mlab-upenn/gokart-mechatronics/Mechanical/SBW - lower/Why loose/loose 2.jpg

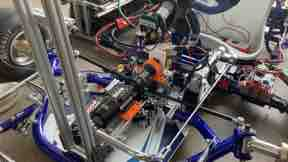
Mechanical/SBW - lower/Why loose/loose 2.jpg
