mlab-upenn/gokart-mechatronics/Mechanical/SBW - lower/Why loose/loose 1.jpg

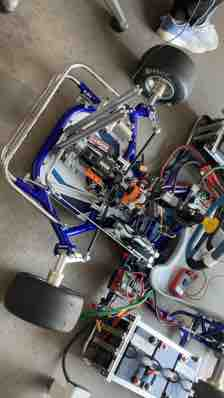
Mechanical/SBW - lower/Why loose/loose 1.jpg
