mlab-upenn/gokart-mechatronics/README.md

# Go-kart Mechatronics
Mechatronics design for AV4EV go-kart project.

**main branch** stores the current design, **dev branch** logs the previous developments and trials.
