mlab-upenn/gokart-mechatronics/Mechanical/BBW Spreadsheet.docx

BBW V4 Spreadsheet

Name | Photos | Functions | Solidworks Model | Quantity | Need of Manufacturing | Material

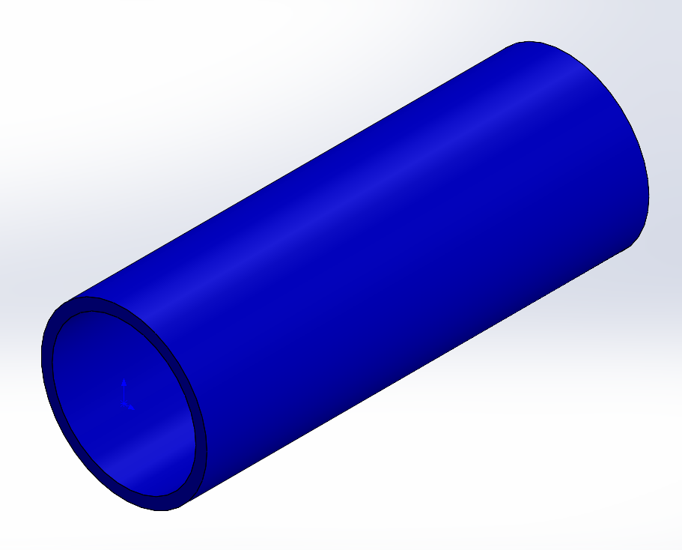
[picture p35: figure]

Side Chassis Frame | | original go-kart side chassis frame | link (https://github.com/mlab-upenn/gokart-mechatronics/tree/main/BBW%20V4) | 1 | No | Steel

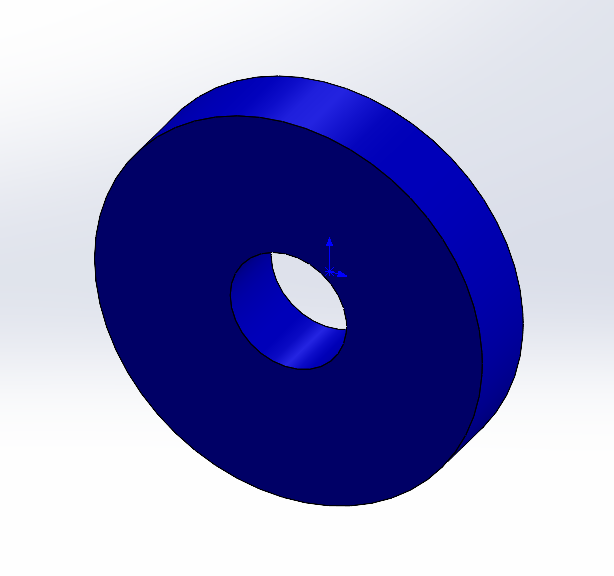
[picture p36: figure]

Chassis Mount | | original mounting hole for aluminum chassis | link (https://github.com/mlab-upenn/gokart-mechatronics/tree/main/BBW%20V4) | 1 | No | Steel

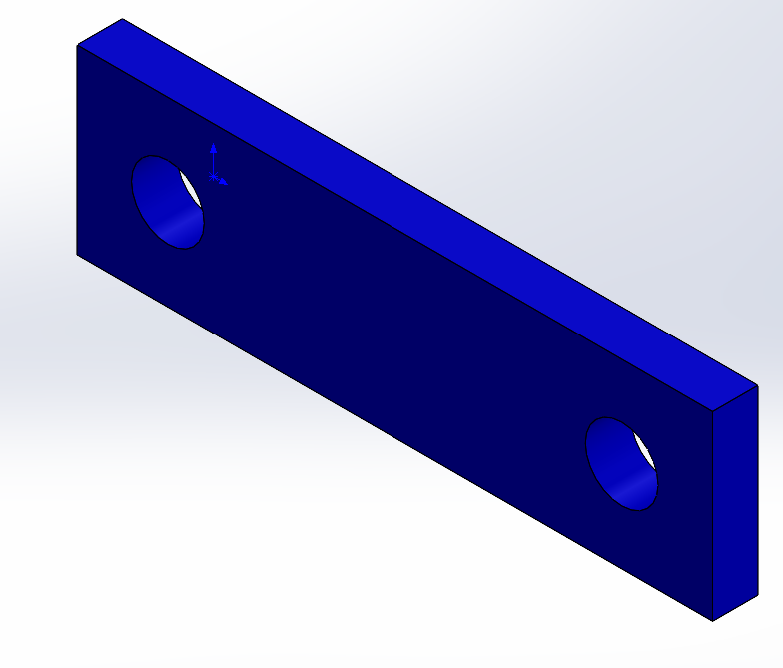
[picture p37: figure]

Black Box Frame | | original mount for the hydraulic brake part | link (https://github.com/mlab-upenn/gokart-mechatronics/tree/main/BBW%20V4) | 1 | No | Steel

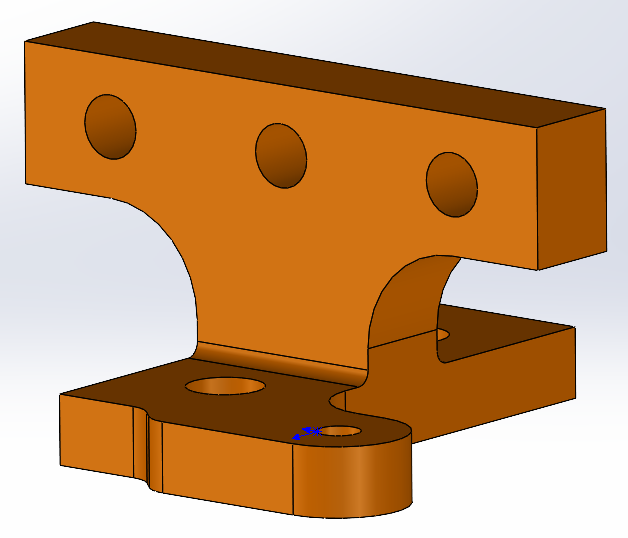
[picture p38: figure]

Small Plate | | connect the LA mount and chassis frame together | link (https://github.com/mlab-upenn/gokart-mechatronics/tree/main/BBW%20V4) | 1 | Yes | Plastic

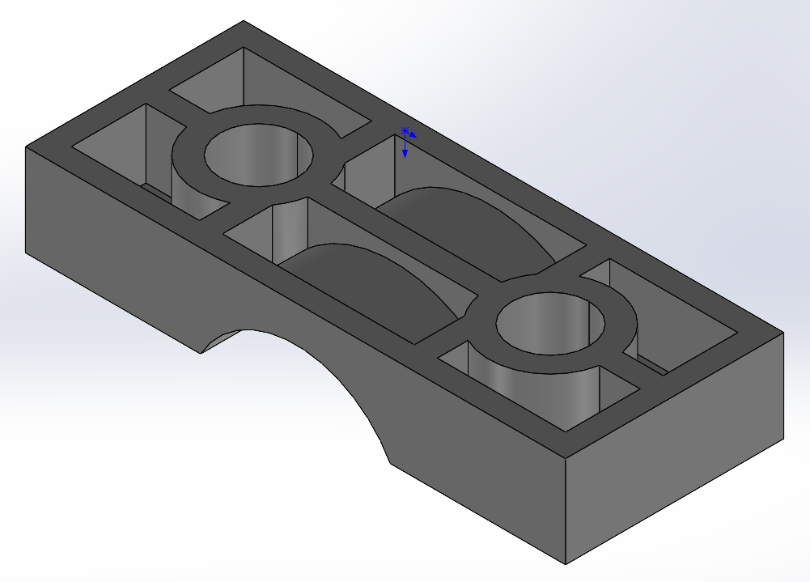
[picture p39: figure]

Original Clamp | | U-bolt clamp for holding the chassis frame | link (https://github.com/mlab-upenn/gokart-mechatronics/tree/main/BBW%20V4) | 1 | Purchase (https://www.mcmaster.com/u-bolts/system-of-measurement~metric/id~30mm/) | Plastic

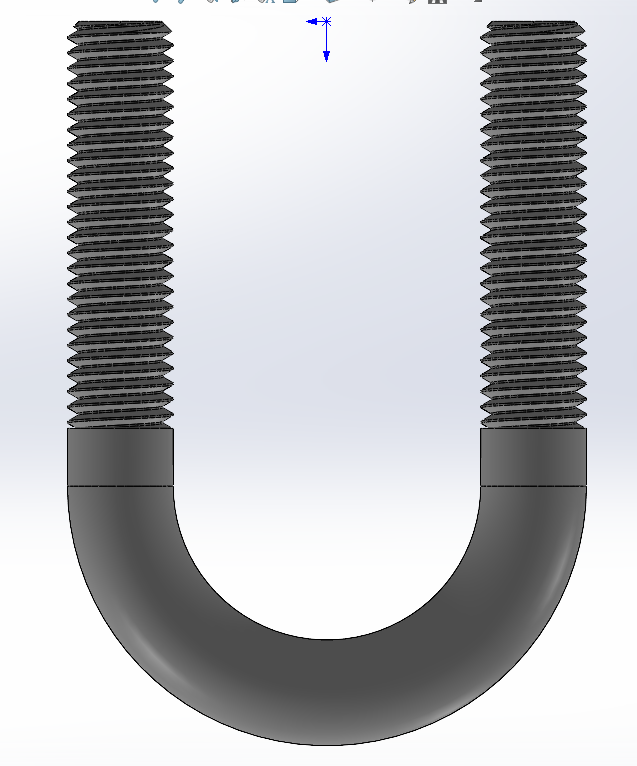
[picture p40: figure]

Thick U bolt | | clamp the whole design to the chassis frame | link (https://github.com/mlab-upenn/gokart-mechatronics/tree/main/BBW%20V4) | 1 | Purchase (https://www.mcmaster.com/u-bolts/system-of-measurement~metric/id~30mm/) | metal

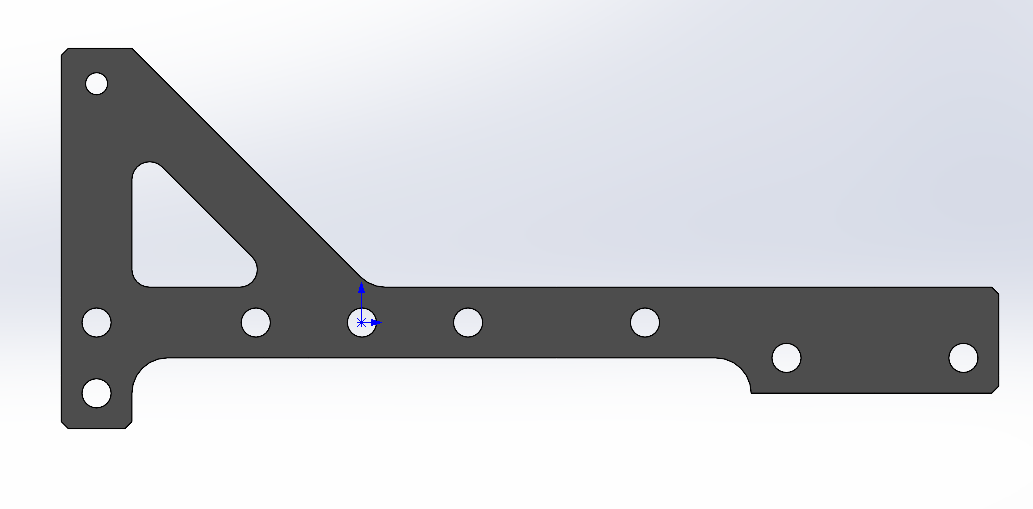
[picture p41: figure]

Steel Frame New | | mount the LA to the black box frame | link (https://github.com/mlab-upenn/gokart-mechatronics/tree/main/BBW%20V4) | 2 | custom | aluminum plate 6061

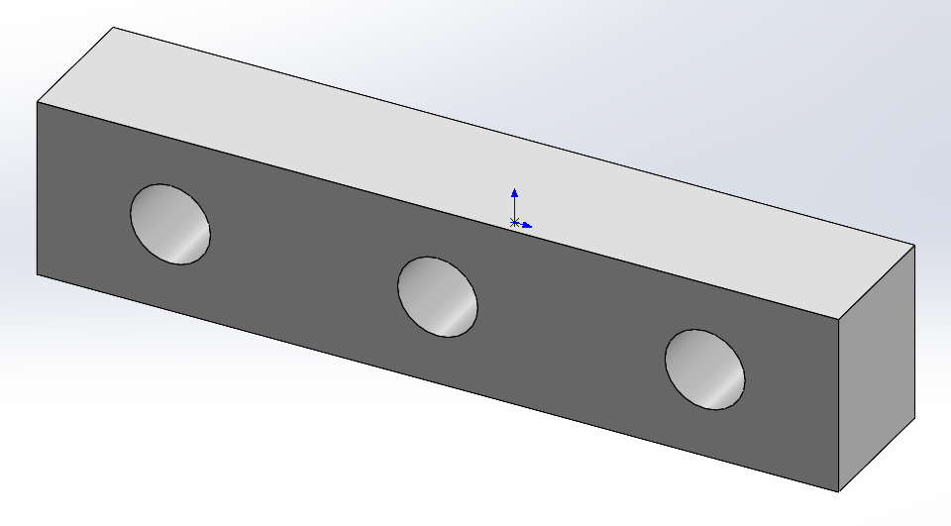
[picture p42: figure]

Mid Link | | position limit | link (https://github.com/mlab-upenn/gokart-mechatronics/tree/main/BBW%20V4) | 2 | Yes | plastic

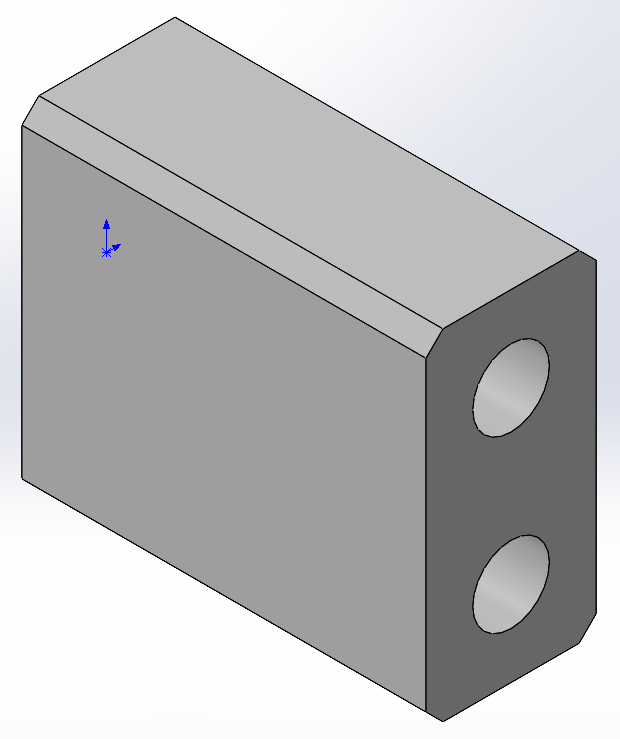
[picture p43: figure]

Back Link | | rear position limit | link (https://github.com/mlab-upenn/gokart-mechatronics/tree/main/BBW%20V4) | 1 | Yes | plastic

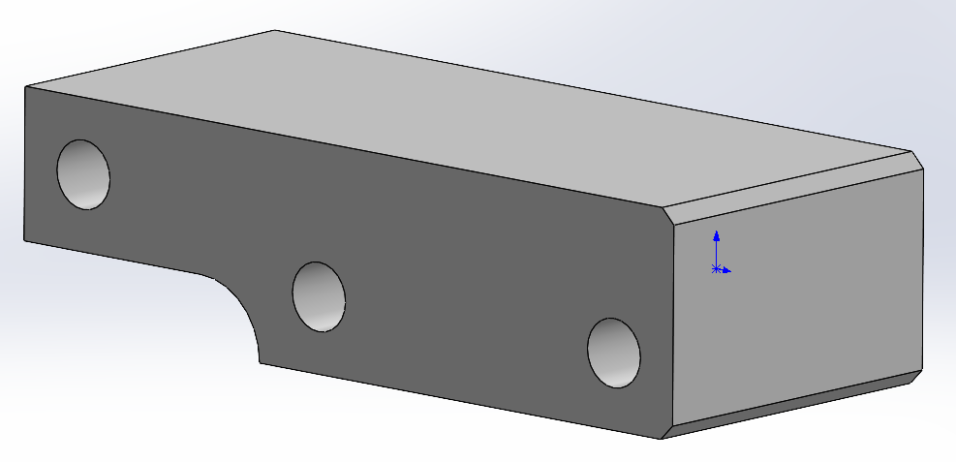
[picture p44: figure]

Front Link | | rear position limit | link (https://github.com/mlab-upenn/gokart-mechatronics/tree/main/BBW%20V4) | 1 | Yes | Plastic

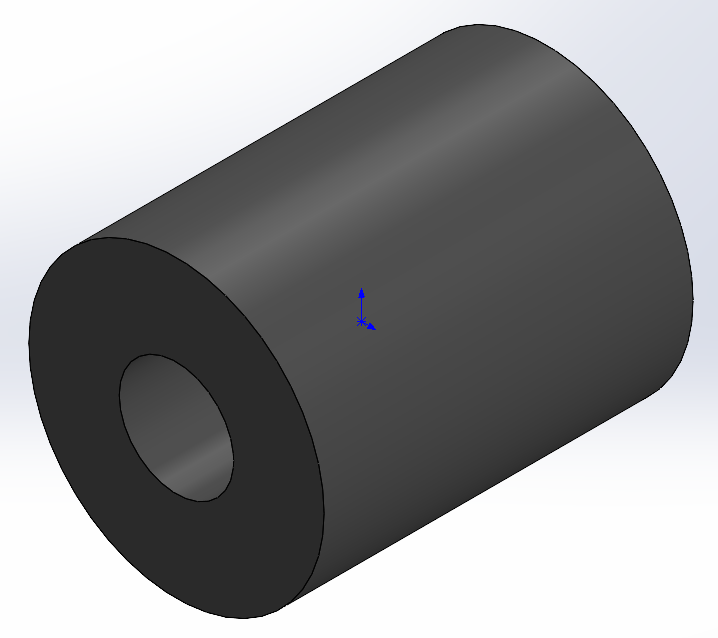
[picture p45: figure]

Sleeve 20mm | | position limit for the chassis mount screw | link (https://github.com/mlab-upenn/gokart-mechatronics/tree/main/BBW%20V4) | 1 | Yes | plastic

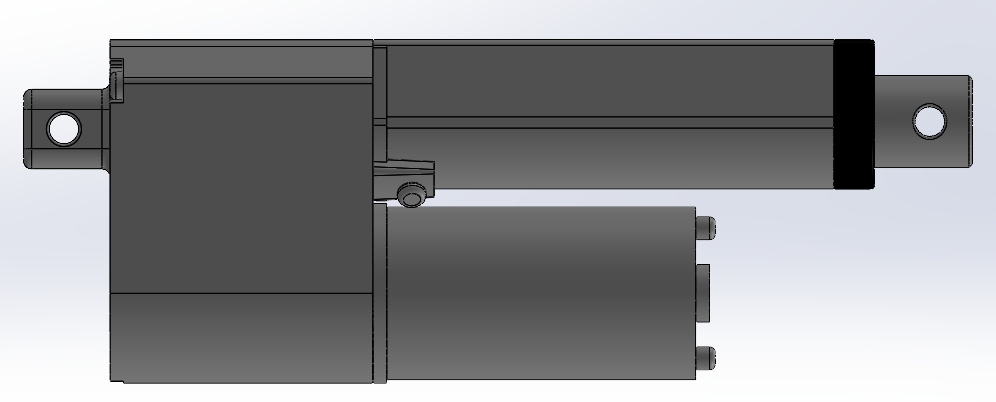
[picture p46: figure]

PA-14P | | linear actuator (LA) | link (https://github.com/mlab-upenn/gokart-mechatronics/tree/main/BBW%20V4) | 1 | Purchase (https://www.amazon.com/PROGRESSIVE-AUTOMATIONS-Electric-Actuator-PA-14P-4-35/dp/B00Q74I8TI) | -

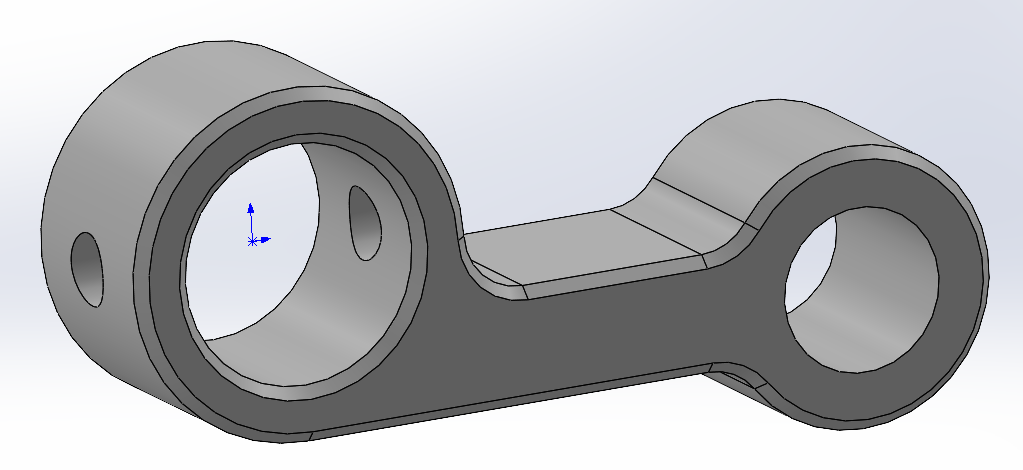
[picture p47: figure]

End Link New Metal | | connect the moving end of LA and transmit the force and the motion to the brake link | link (https://github.com/mlab-upenn/gokart-mechatronics/tree/main/BBW%20V4) | 1 | Custom | aluminum plate 6061

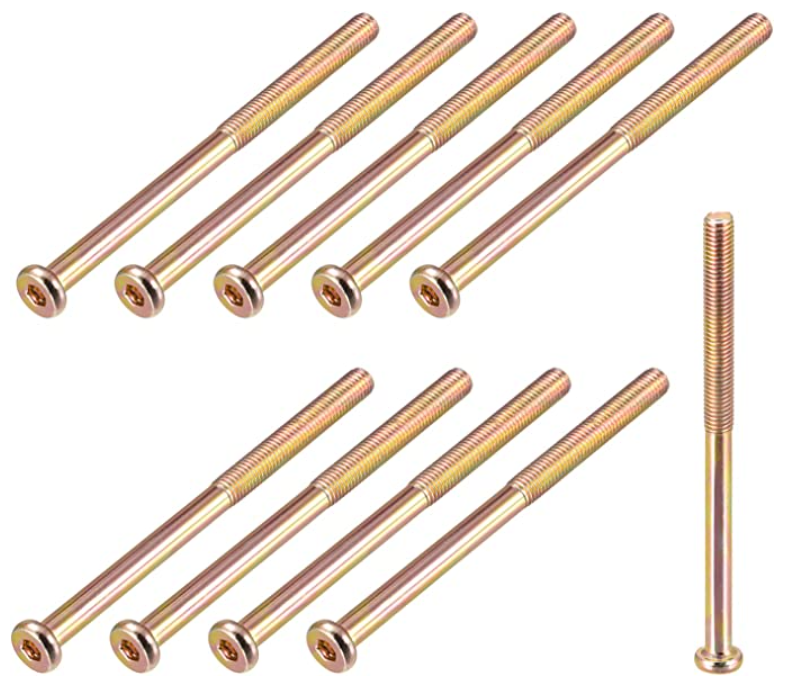
[picture p48: figure]

Hex Socket Head Machine Screws, (M8x120mm) | | horizontally fasten the LA steel frame | - | 8 | Purchase (https://www.amazon.com/METALLIXITY-Socket-Machine-Screws-M8x120mm/dp/B09YNLHP5Q) | metal

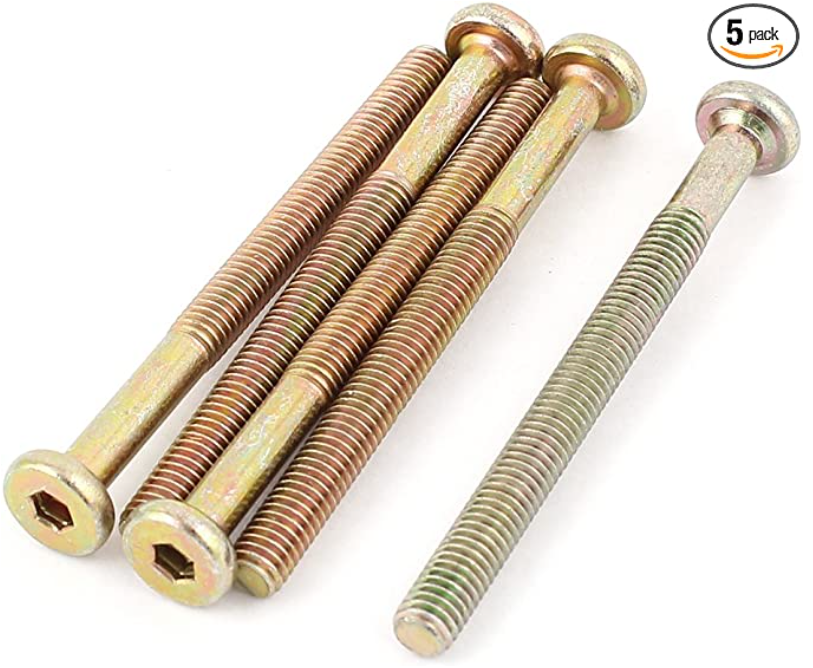
[picture p49: figure]

M6 x 70mm Threaded 1mm Pitch Hex Socket Head Cap Screws Bolts | | fasten the the stationary point of LA | - | 1 | Purchase (https://www.amazon.com/uxcell-Threaded-Pitch-Socket-Screws/dp/B012THHR1G) | metal
M6 washers & nuts | | assembling | | n
M8 washers & nuts | | assembling | | n

For earlier versions, please check the corresponding folders in the dev branch for further details.
