mlab-upenn/gokart-mechatronics/Mechanical/SBW - lower/Why loose/loose 3.jpg

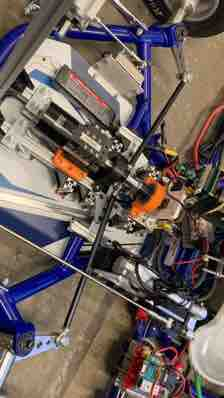
Mechanical/SBW - lower/Why loose/loose 3.jpg
