mlab-upenn/gokart-mechatronics/Mechanical/Rear Shelves/Rear Frame - Sensors and mounts/Ouster Driver/Ouster Driver Assy.SLDASM

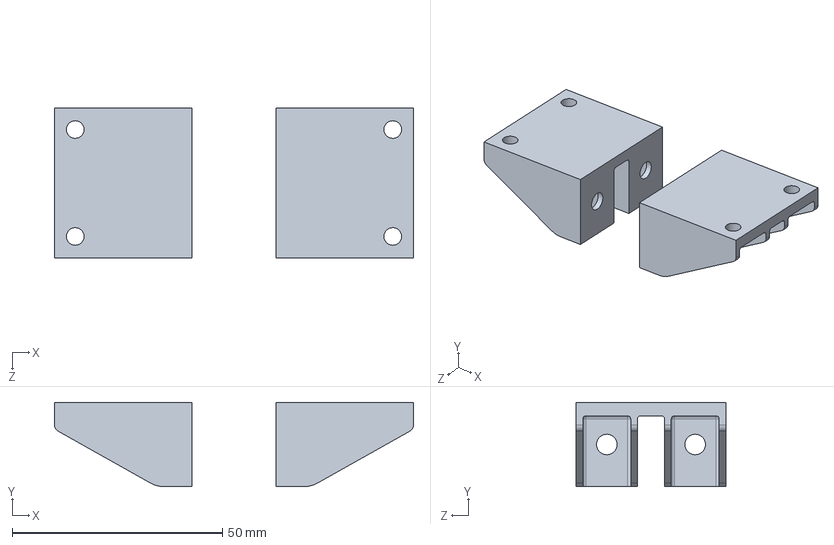
[picture p52: CAD file, 2023-08-22]
Mechanical/Rear Shelves/Rear Frame - Sensors and mounts/Ouster Driver/Ouster Driver Assy.SLDASM
85.3 x 20.0 x 35.6 mm
Ouster Driver Mount x 2
