mlab-upenn/gokart-mechatronics/Mechanical/Battery Mount/Battery_Box_Assy.STEP

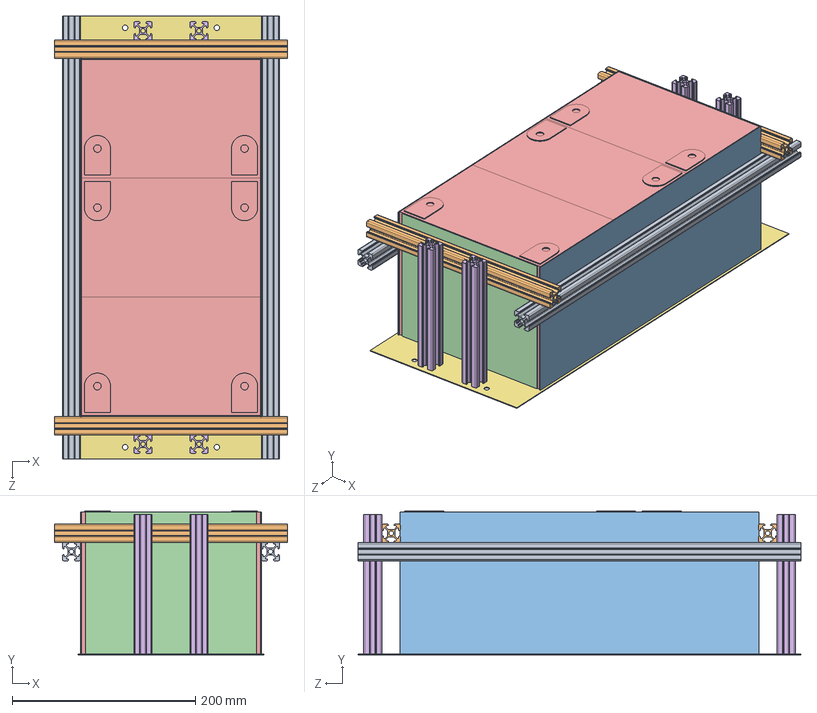
[picture p53: CAD file, 2024-02-22]
Mechanical/Battery Mount/Battery_Box_Assy.STEP
254.0 x 156.9 x 482.6 mm
Tslot1_默认 x 2
Tslot2_默认 x 2
vertical sheet sides x 2
vertical sheet front and back x 2
LiPo_Simple x 3
Tslot3_默认 x 4
floor sheet left_默认
floor sheet right_默认
