mlab-upenn/gokart-mechatronics/Mechanical/Front LiDAR Driver Mount/LiDAR Driver Mount Assem.SLDASM

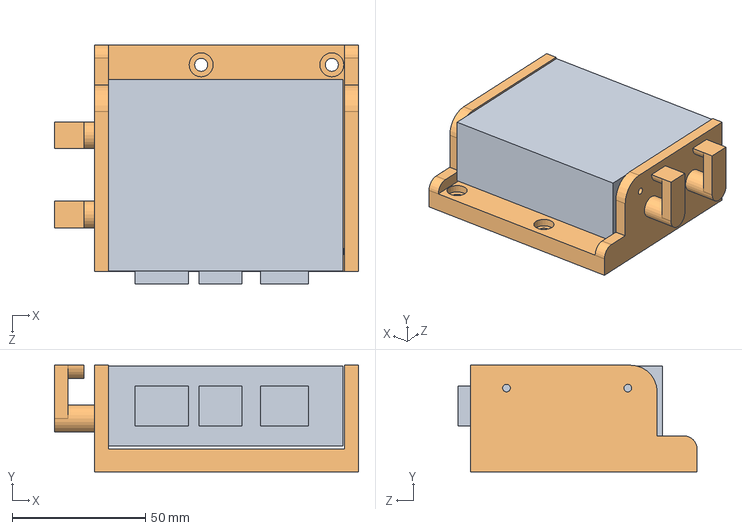
[picture p54: CAD file, 2023-04-07]
Mechanical/Front LiDAR Driver Mount/LiDAR Driver Mount Assem.SLDASM
114.0 x 40.0 x 89.8 mm
Driver
Driver Mount
