mlab-upenn/gokart-mechatronics/Mechanical/Battery Mount/LiPo_Simple.SLDPRT

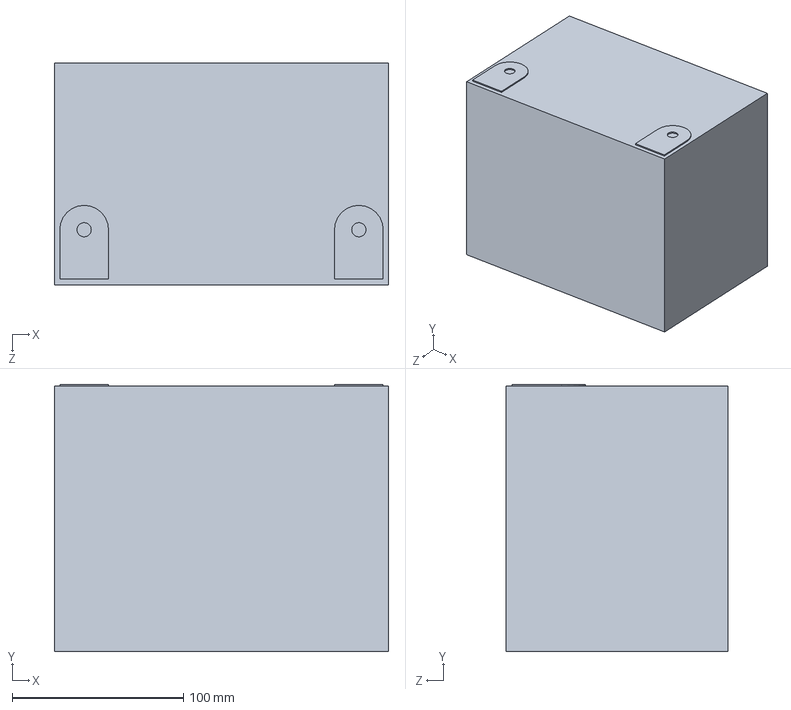
[picture p55: CAD file, 2024-02-22]
Mechanical/Battery Mount/LiPo_Simple.SLDPRT
195.0 x 156.0 x 129.5 mm
