mlab-upenn/gokart-mechatronics/Mechanical/BBW controller mount/acrylic layer.SLDPRT

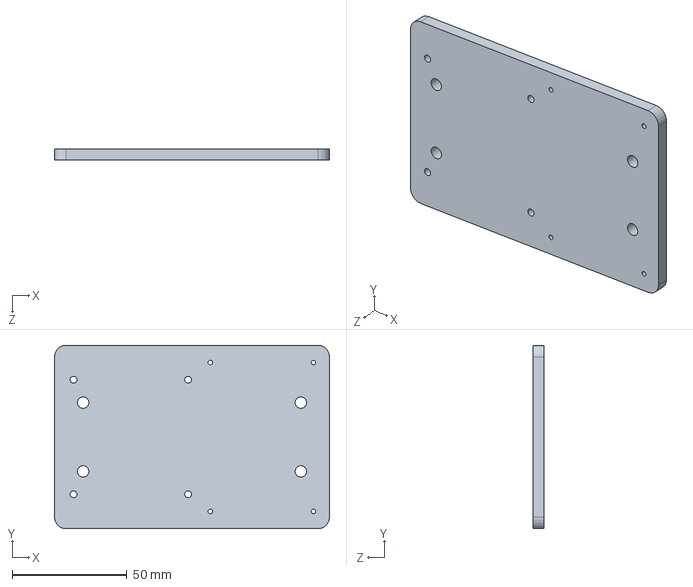
[picture p56: CAD file, 2023-08-09]
Mechanical/BBW controller mount/acrylic layer.SLDPRT
120.0 x 80.0 x 5.00 mm
