mlab-upenn/gokart-mechatronics/Mechanical/BBW/STL/mid link.STL

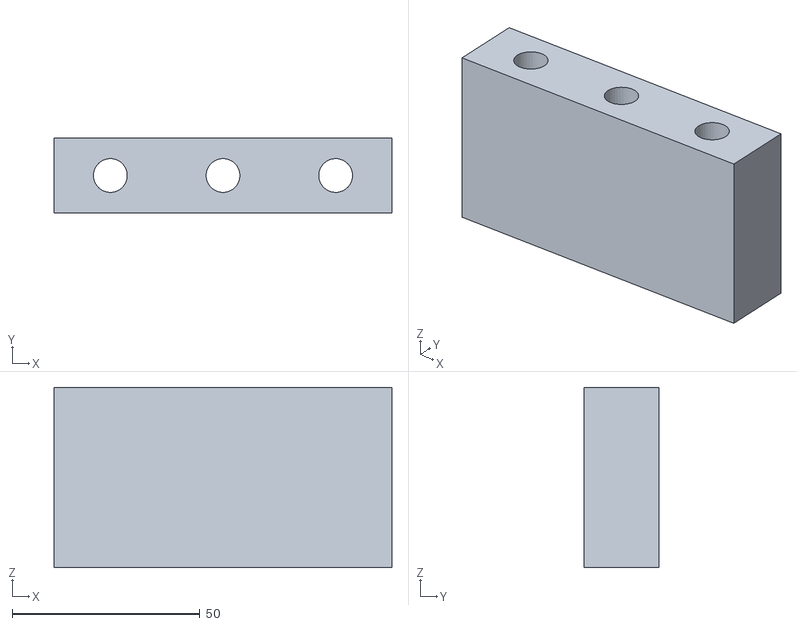
[picture p57: CAD file, 2023-08-24]
Mechanical/BBW/STL/mid link.STL
90.0 x 20.0 x 48.0
