mlab-upenn/gokart-mechatronics/Mechanical/Front LiDAR Driver Mount/Driver.SLDPRT

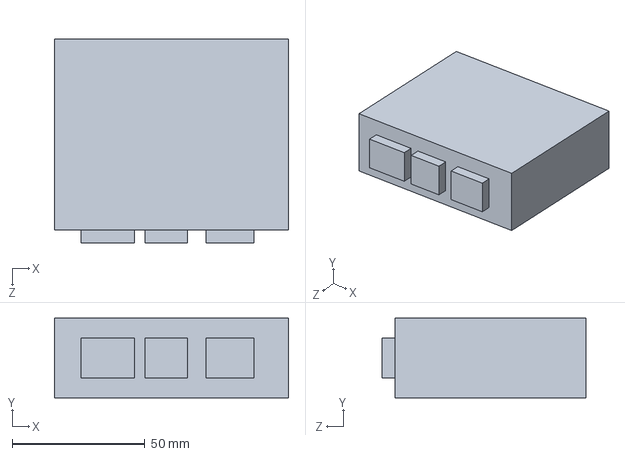
[picture p58: CAD file, 2023-04-07]
Mechanical/Front LiDAR Driver Mount/Driver.SLDPRT
88.0 x 30.0 x 76.8 mm
