mlab-upenn/gokart-mechatronics/Mechanical/Rear axle sensor/magnet_holder_collar.SLDPRT

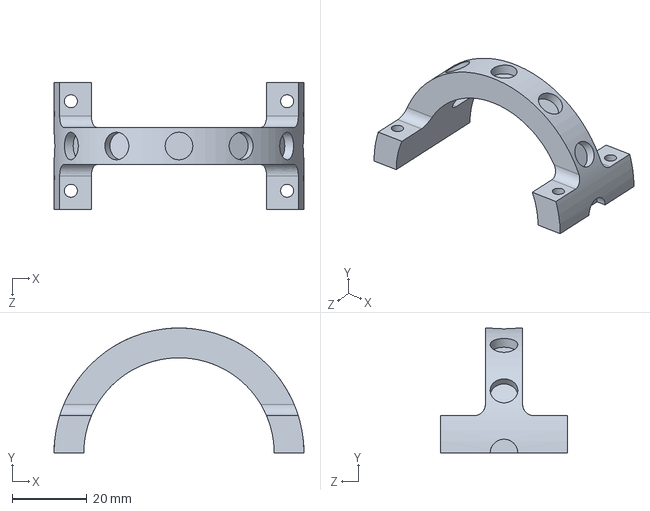
[picture p59: CAD file, 2023-08-30]
Mechanical/Rear axle sensor/magnet_holder_collar.SLDPRT
67.0 x 33.5 x 34.0 mm
