mlab-upenn/gokart-mechatronics/Mechanical/Rear Shelves/Rear Frame - MDF shelves/Autonomy Kit shelves/Top Plate AutoKit V6.SLDPRT

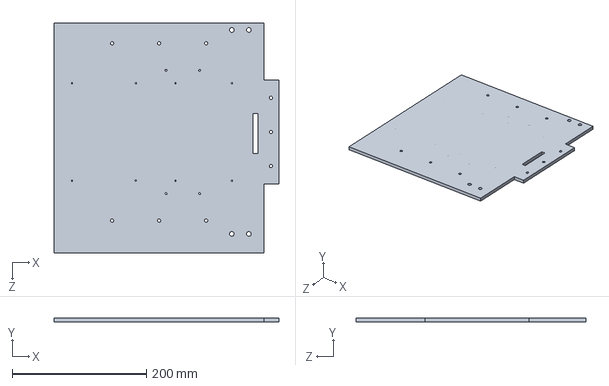
[picture p60: CAD file, 2023-10-17]
Mechanical/Rear Shelves/Rear Frame - MDF shelves/Autonomy Kit shelves/Top Plate AutoKit V6.SLDPRT
335.0 x 6.35 x 342.0 mm
