mlab-upenn/gokart-mechatronics/Mechanical/Rear Shelves/Rear Frame - MDF shelves/Rear shelves top and bottom V1 - V4/Bottom plate right side V4.SLDPRT

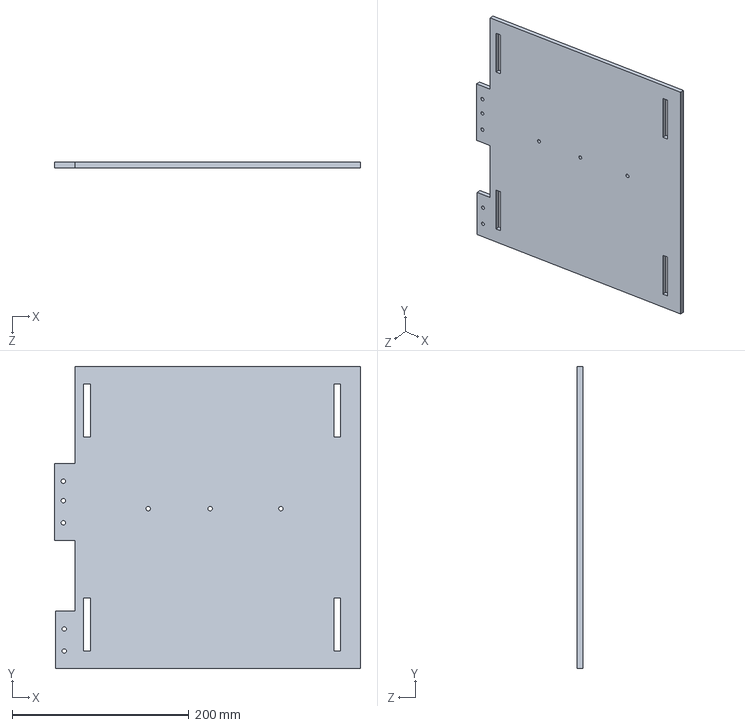
[picture p61: CAD file, 2023-07-20]
Mechanical/Rear Shelves/Rear Frame - MDF shelves/Rear shelves top and bottom V1 - V4/Bottom plate right side V4.SLDPRT
346.0 x 342.0 x 6.35 mm
