mlab-upenn/gokart-mechatronics/Mechanical/Rear Shelves/Rear Frame - Metal/Planar_Connector_Quad.SLDPRT

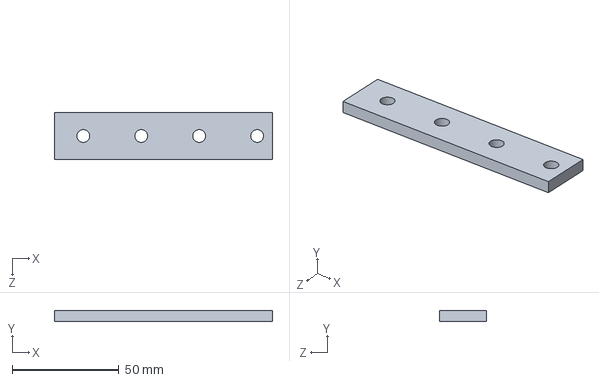
[picture p62: CAD file, 2023-07-21]
Mechanical/Rear Shelves/Rear Frame - Metal/Planar_Connector_Quad.SLDPRT
102.0 x 5.00 x 22.0 mm
