mlab-upenn/gokart-mechatronics/Mechanical/Rear Shelves/Rear Frame - Metal/T-slots/T-slot frame 146mm.SLDPRT

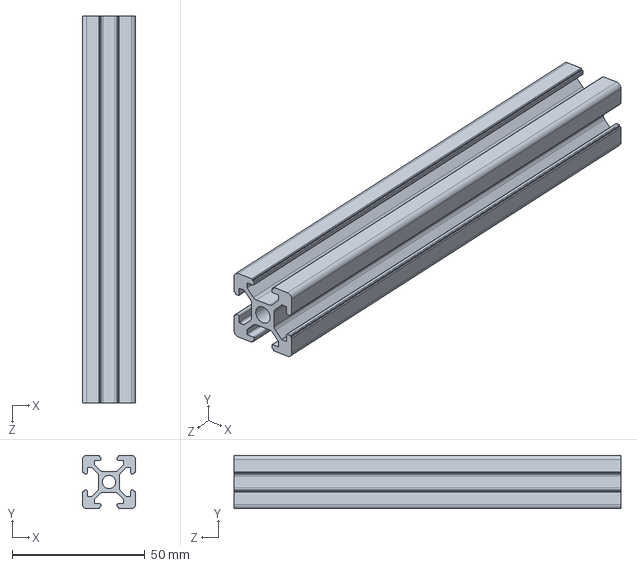
[picture p63: CAD file, 2023-08-10]
Mechanical/Rear Shelves/Rear Frame - Metal/T-slots/T-slot frame 146mm.SLDPRT
20.0 x 20.0 x 146.0 mm
