mlab-upenn/gokart-mechatronics/Mechanical/Rear Shelves/Rear Frame - Sensors and mounts/Antenna/Antenna.SLDPRT

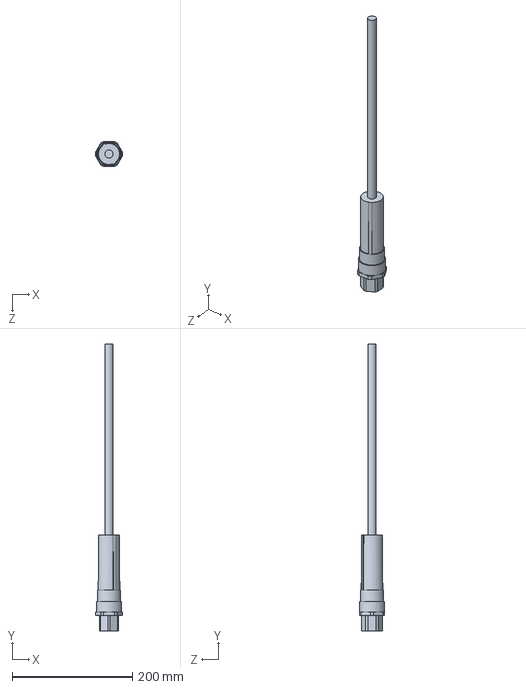
[picture p64: CAD file, 2023-06-22]
Mechanical/Rear Shelves/Rear Frame - Sensors and mounts/Antenna/Antenna.SLDPRT
45.5 x 477.1 x 42.1 mm
