mlab-upenn/gokart-mechatronics/Mechanical/Rear Shelves/Rear Frame - Sensors and mounts/Antenna/Derek antenna mount/antenna mount.SLDPRT

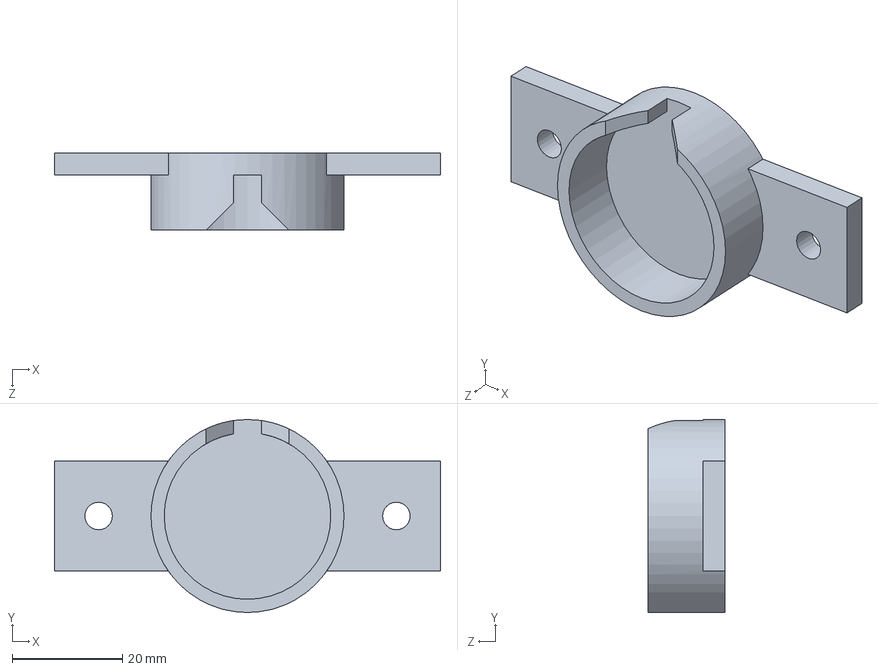
[picture p65: CAD file, 2023-05-11]
Mechanical/Rear Shelves/Rear Frame - Sensors and mounts/Antenna/Derek antenna mount/antenna mount.SLDPRT
70.0 x 35.0 x 14.0 mm
