mlab-upenn/gokart-mechatronics/Mechanical/Rear Shelves/Rear Frame - Sensors and mounts/RealSense/RealSense_Mount.SLDPRT

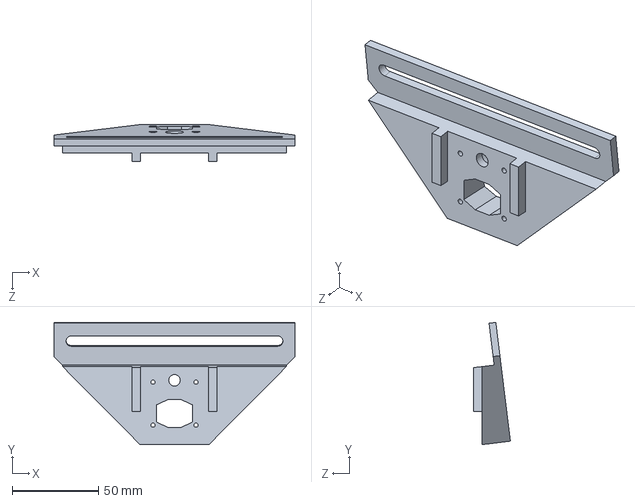
[picture p66: CAD file, 2023-07-25]
Mechanical/Rear Shelves/Rear Frame - Sensors and mounts/RealSense/RealSense_Mount.SLDPRT
140.0 x 71.0 x 21.4 mm
