mlab-upenn/gokart-mechatronics/Mechanical/Rear Shelves/Rear Frame - Sensors and mounts/T-slot frame 656mm.SLDPRT

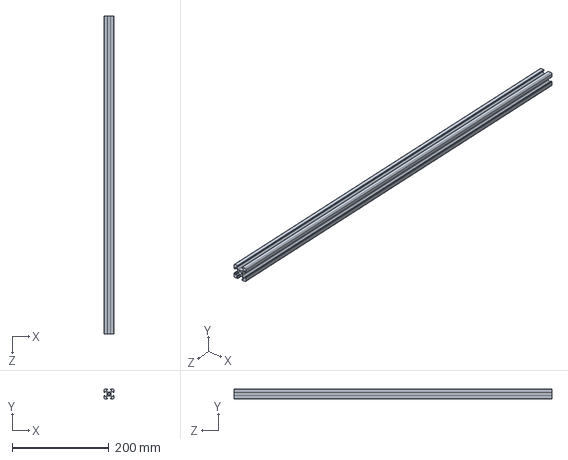
[picture p67: CAD file, 2023-04-07]
Mechanical/Rear Shelves/Rear Frame - Sensors and mounts/T-slot frame 656mm.SLDPRT
20.0 x 20.0 x 656.0 mm
