mlab-upenn/gokart-mechatronics/Mechanical/SBW - lower/BLDC_Back_Half.SLDPRT

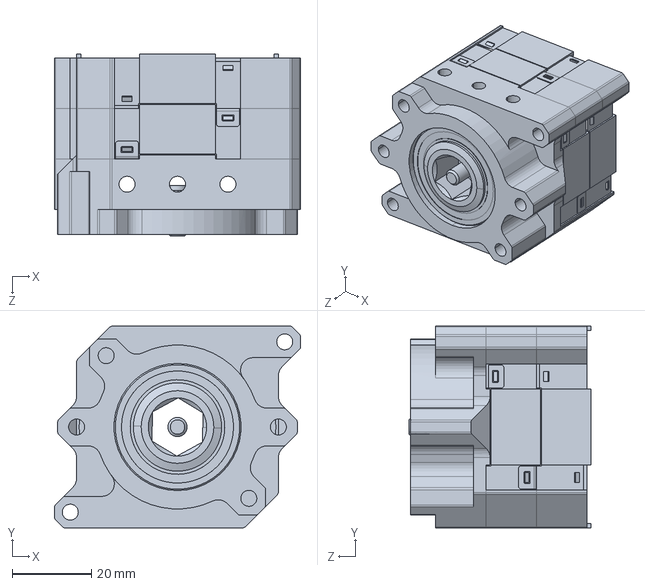
[picture p68: CAD file, 2023-09-13]
Mechanical/SBW - lower/BLDC_Back_Half.SLDPRT
61.9 x 50.8 x 45.8 mm
