mlab-upenn/gokart-mechatronics/Mechanical/SBW - lower/Lower Steer By Wire/Lower Steer By Wire.step

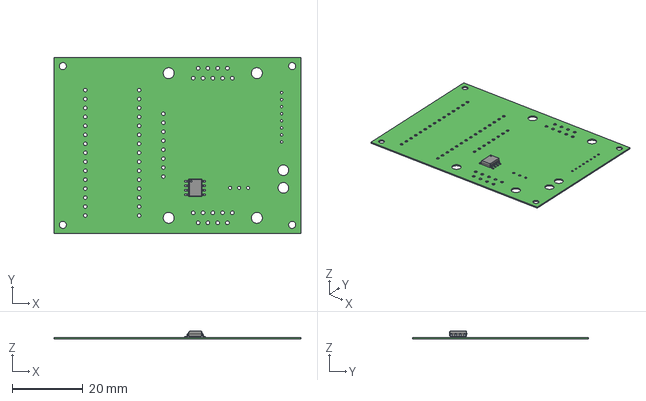
[picture p69: CAD file, 2022-12-17]
Mechanical/SBW - lower/Lower Steer By Wire/Lower Steer By Wire.step
70.0 x 50.0 x 2.16 mm
