mlab-upenn/gokart-mechatronics/Mechanical/SBW - lower/LSBW ASM/AS5047P mount.SLDPRT

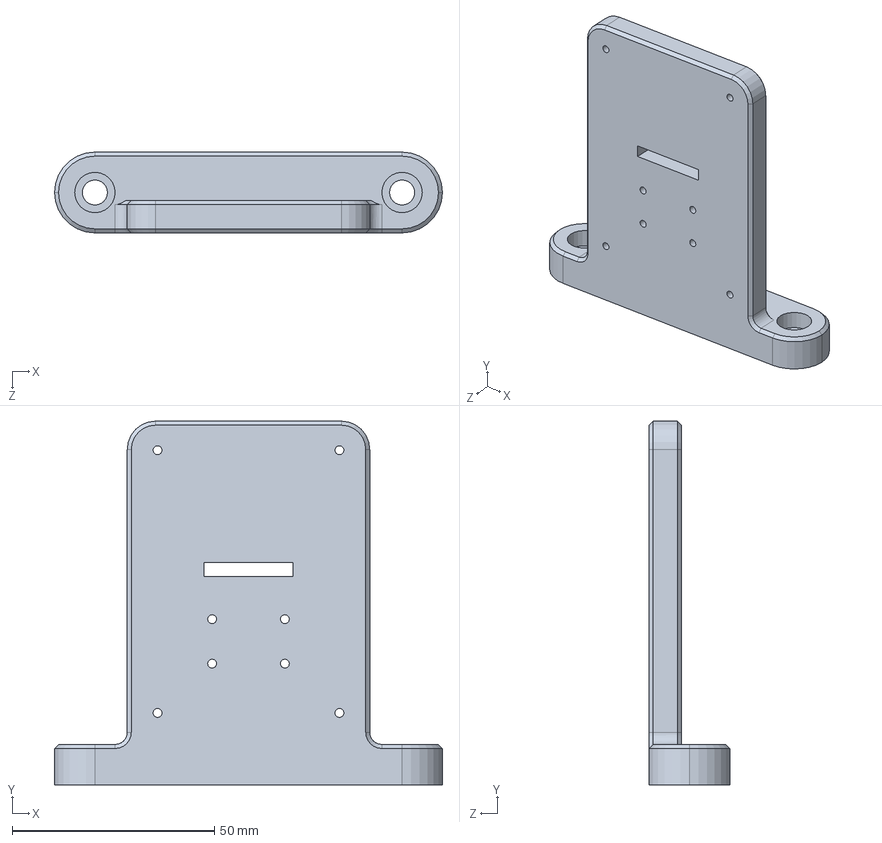
[picture p70: CAD file, 2023-10-17]
Mechanical/SBW - lower/LSBW ASM/AS5047P mount.SLDPRT
96.0 x 90.0 x 20.0 mm
