mlab-upenn/gokart-mechatronics/Mechanical/SBW - upper/USBW PCB mount.SLDPRT

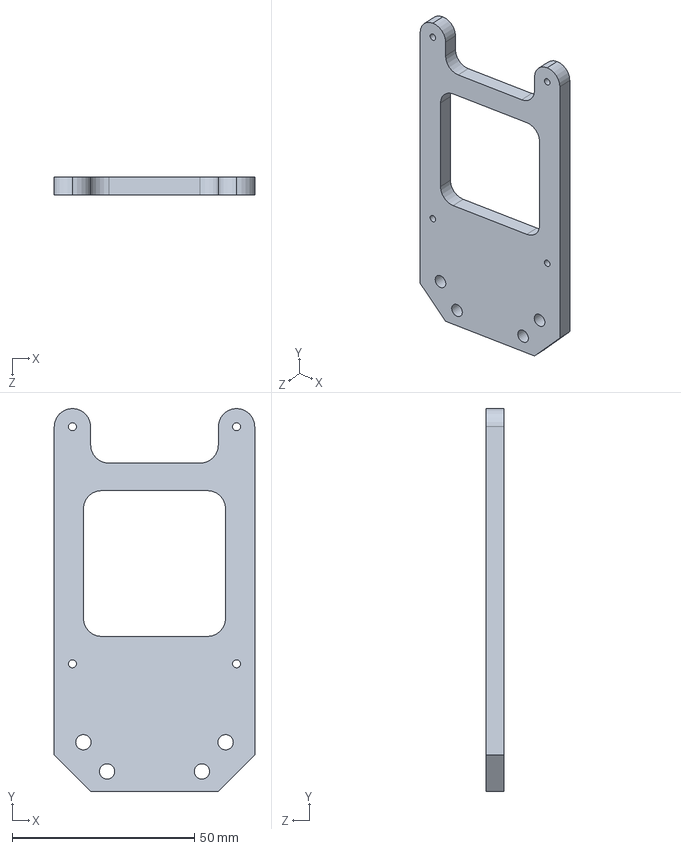
[picture p71: CAD file, 2023-08-29]
Mechanical/SBW - upper/USBW PCB mount.SLDPRT
55.0 x 105.0 x 5.00 mm
