mlab-upenn/gokart-mechatronics/Mechanical/Battery Mount/floor sheet right.SLDPRT

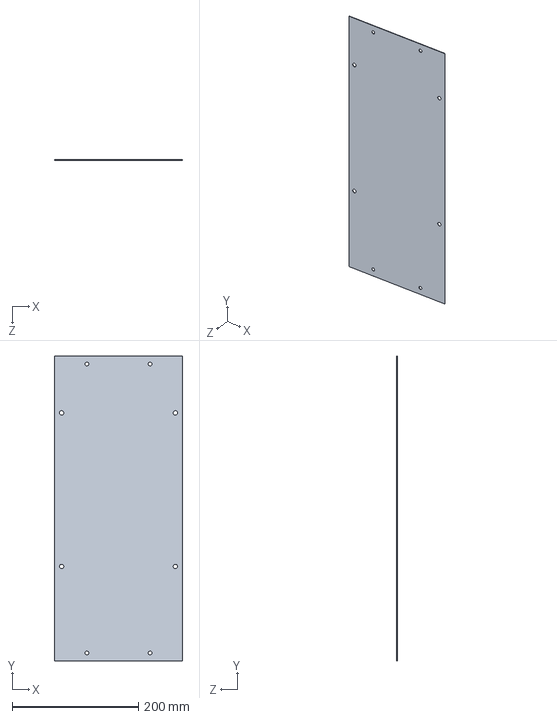
[picture p72: CAD file, 2024-02-22]
Mechanical/Battery Mount/floor sheet right.SLDPRT
203.2 x 482.6 x 0.9 mm
