mlab-upenn/gokart-mechatronics/Mechanical/BBW controller mount/upper clutch.SLDPRT

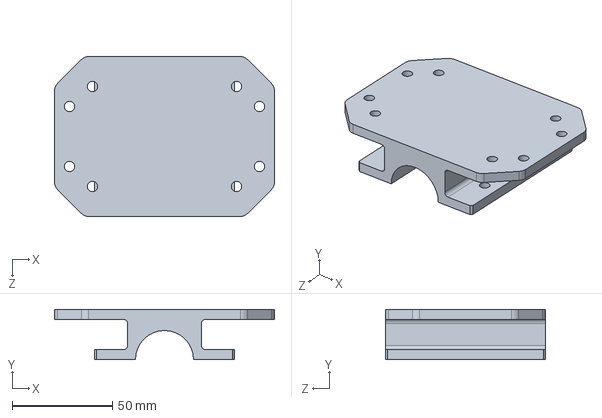
[picture p73: CAD file, 2023-08-09]
Mechanical/BBW controller mount/upper clutch.SLDPRT
110.0 x 25.0 x 80.0 mm
