mlab-upenn/gokart-mechatronics/Mechanical/BBW/BBW ASM/LA side mount.SLDPRT

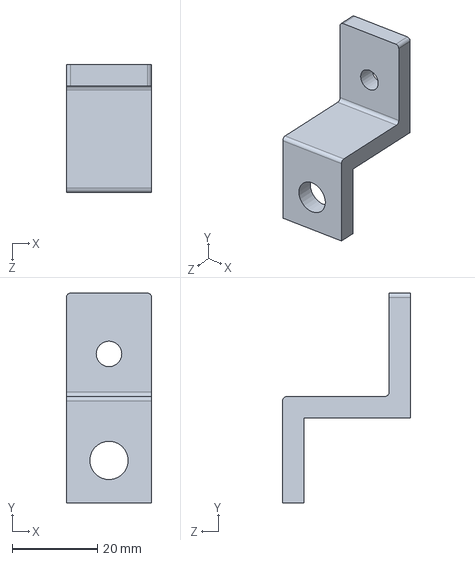
[picture p74: CAD file, 2023-09-29]
Mechanical/BBW/BBW ASM/LA side mount.SLDPRT
20.0 x 49.3 x 30.0 mm
