mlab-upenn/gokart-mechatronics/Mechanical/BBW/Lever_arm_pin.SLDPRT

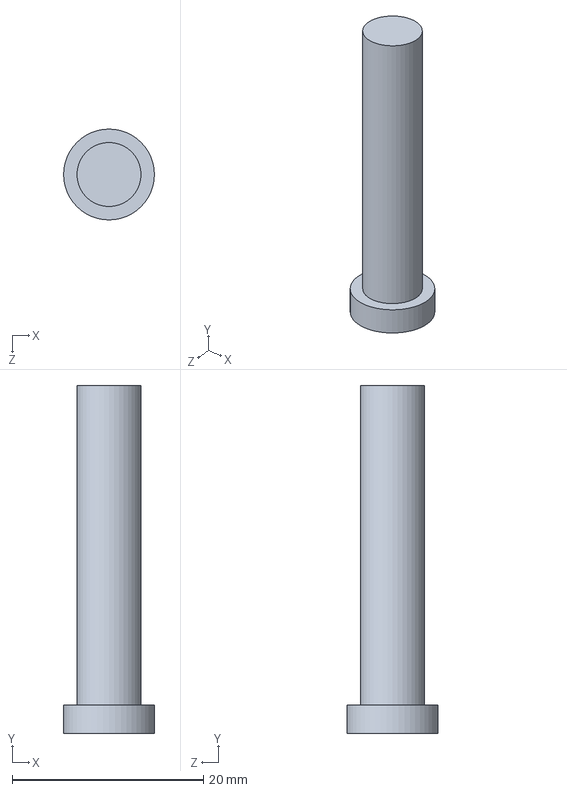
[picture p75: CAD file, 2023-08-28]
Mechanical/BBW/Lever_arm_pin.SLDPRT
9.50 x 36.4 x 9.50 mm
