mlab-upenn/gokart-mechatronics/Mechanical/BBW/STL/front link.STL

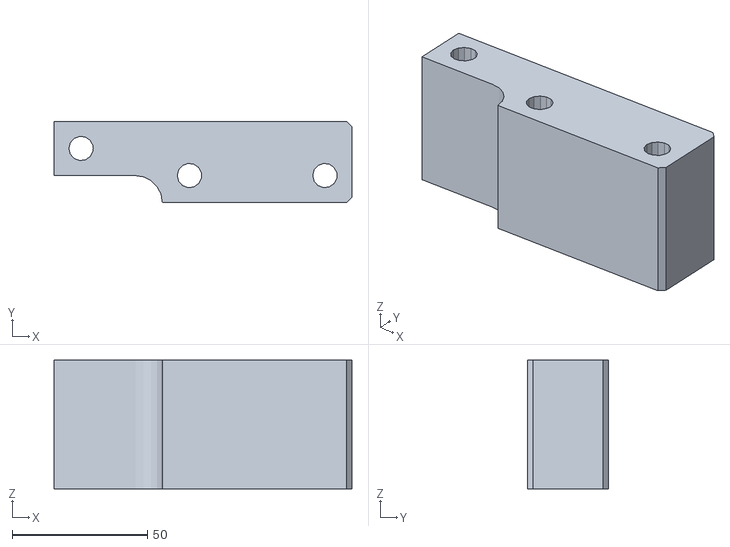
[picture p76: CAD file, 2022-12-17]
Mechanical/BBW/STL/front link.STL
110.0 x 30.0 x 47.5
