mlab-upenn/gokart-mechatronics/Mechanical/Eve_autonomy/Lidar_Mount.SLDPRT

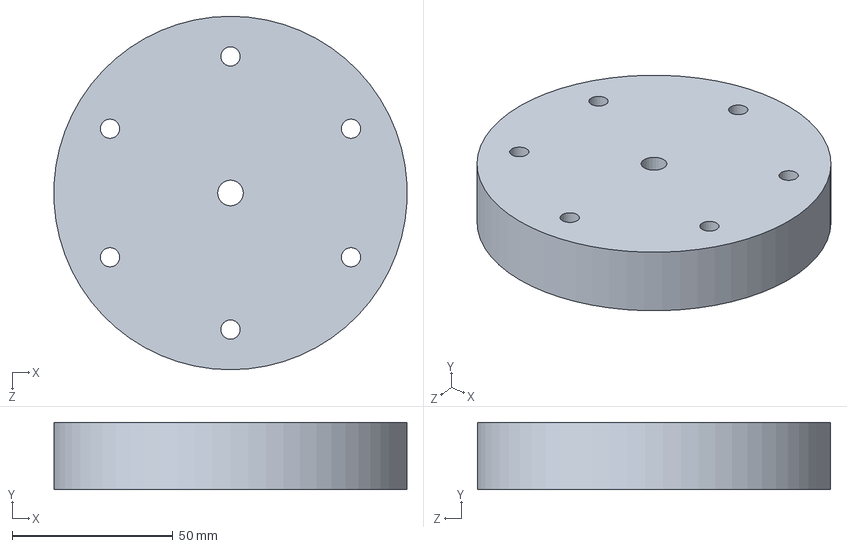
[picture p77: CAD file, 2024-02-26]
Mechanical/Eve_autonomy/Lidar_Mount.SLDPRT
109.9 x 21.0 x 110.0 mm
