mlab-upenn/gokart-mechatronics/Mechanical/Front LiDAR Driver Mount/Driver Mount V2 - Driver Mount-1.STL

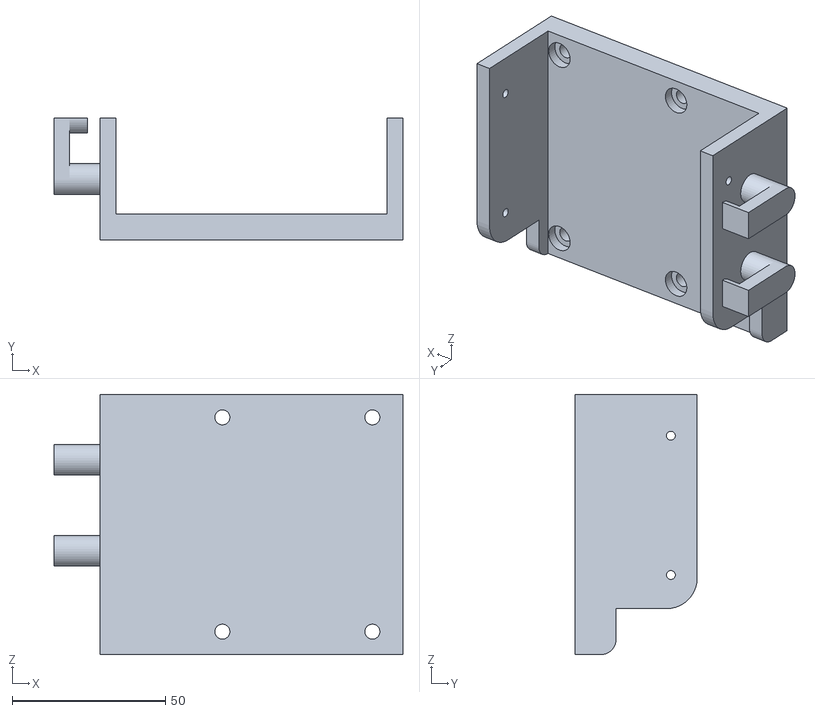
[picture p78: CAD file, 2023-04-07]
Mechanical/Front LiDAR Driver Mount/Driver Mount V2 - Driver Mount-1.STL
114.0 x 40.0 x 85.0
