mlab-upenn/gokart-mechatronics/Mechanical/Rear axle sensor/rear_sensor_holder.SLDPRT

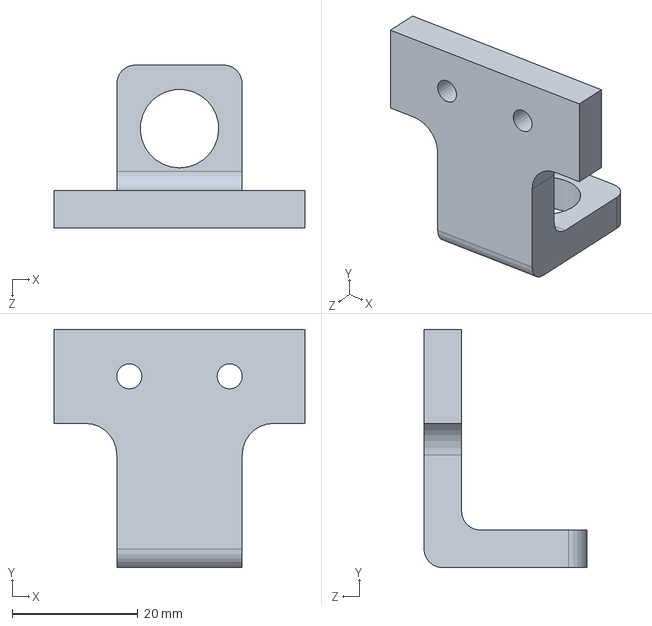
[picture p79: CAD file, 2023-08-17]
Mechanical/Rear axle sensor/rear_sensor_holder.SLDPRT
40.0 x 38.0 x 26.0 mm
