mlab-upenn/gokart-mechatronics/Mechanical/Rear Shelves/Rear Frame - MDF shelves/Autonomy Kit shelves/AutoKit_Blocker.SLDPRT

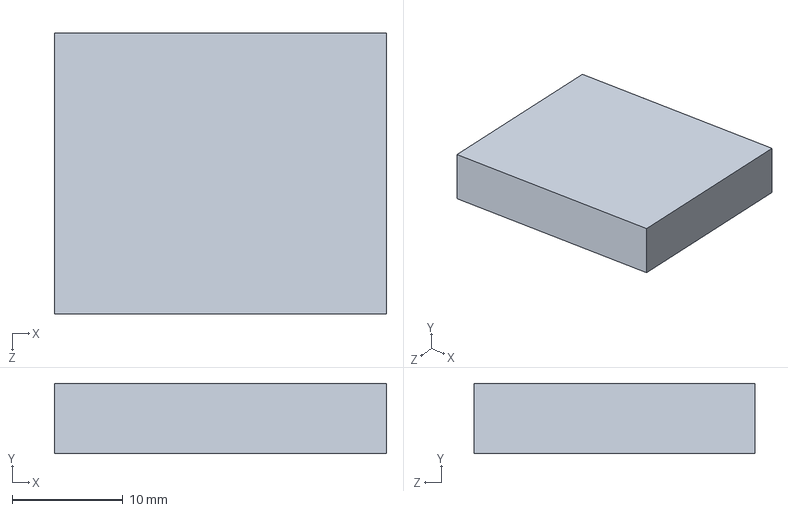
[picture p80: CAD file, 2023-10-17]
Mechanical/Rear Shelves/Rear Frame - MDF shelves/Autonomy Kit shelves/AutoKit_Blocker.SLDPRT
30.0 x 6.35 x 25.4 mm
