mlab-upenn/gokart-mechatronics/Mechanical/Rear Shelves/Rear Frame - MDF shelves/Rear shelves top and bottom V1 - V4/Top Plate left side V1.SLDPRT

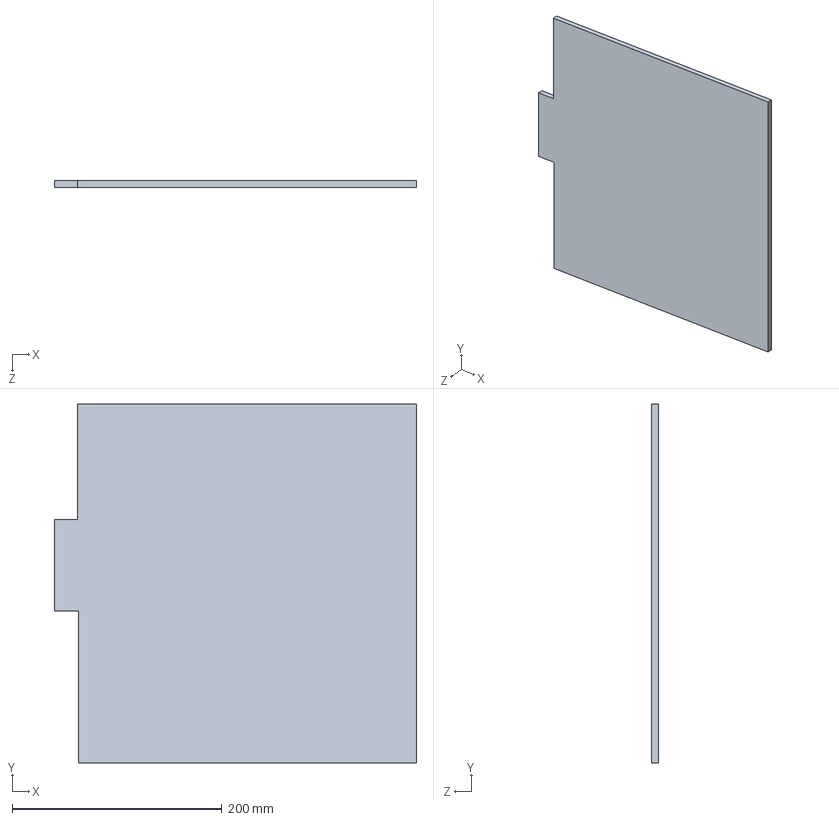
[picture p81: CAD file, 2023-07-20]
Mechanical/Rear Shelves/Rear Frame - MDF shelves/Rear shelves top and bottom V1 - V4/Top Plate left side V1.SLDPRT
345.0 x 342.0 x 6.35 mm
