mlab-upenn/gokart-mechatronics/Mechanical/Rear Shelves/Rear Frame - Metal/L-Link.SLDPRT

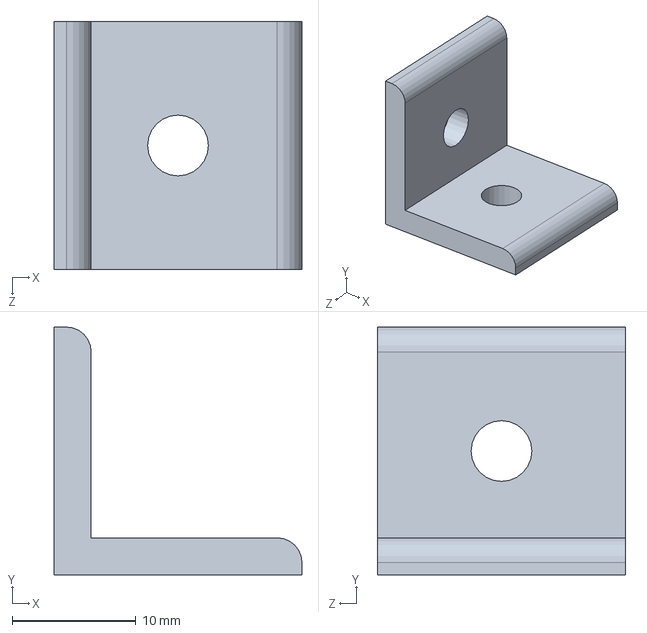
[picture p82: CAD file, 2023-07-21]
Mechanical/Rear Shelves/Rear Frame - Metal/L-Link.SLDPRT
20.0 x 20.0 x 20.0 mm
