mlab-upenn/gokart-mechatronics/Mechanical/Rear Shelves/Rear Frame - Metal/T-slots/T-slot frame 210mm.SLDPRT

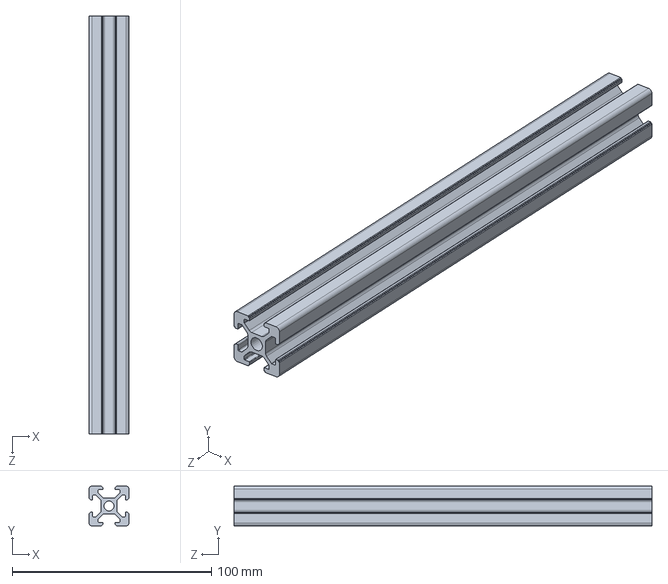
[picture p83: CAD file, 2023-08-10]
Mechanical/Rear Shelves/Rear Frame - Metal/T-slots/T-slot frame 210mm.SLDPRT
20.0 x 20.0 x 210.0 mm
