mlab-upenn/gokart-mechatronics/Mechanical/Rear Shelves/Rear Frame - Sensors and mounts/Antenna/Mount_Circle_Pocket_v2.SLDPRT

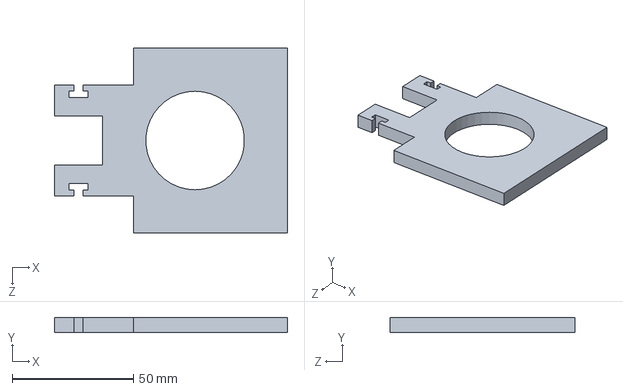
[picture p84: CAD file, 2023-06-22]
Mechanical/Rear Shelves/Rear Frame - Sensors and mounts/Antenna/Mount_Circle_Pocket_v2.SLDPRT
96.1 x 6.35 x 76.2 mm
