mlab-upenn/gokart-mechatronics/Mechanical/Rear Shelves/Rear Frame - Sensors and mounts/Ouster Driver/Ouster Driver Mount.SLDPRT

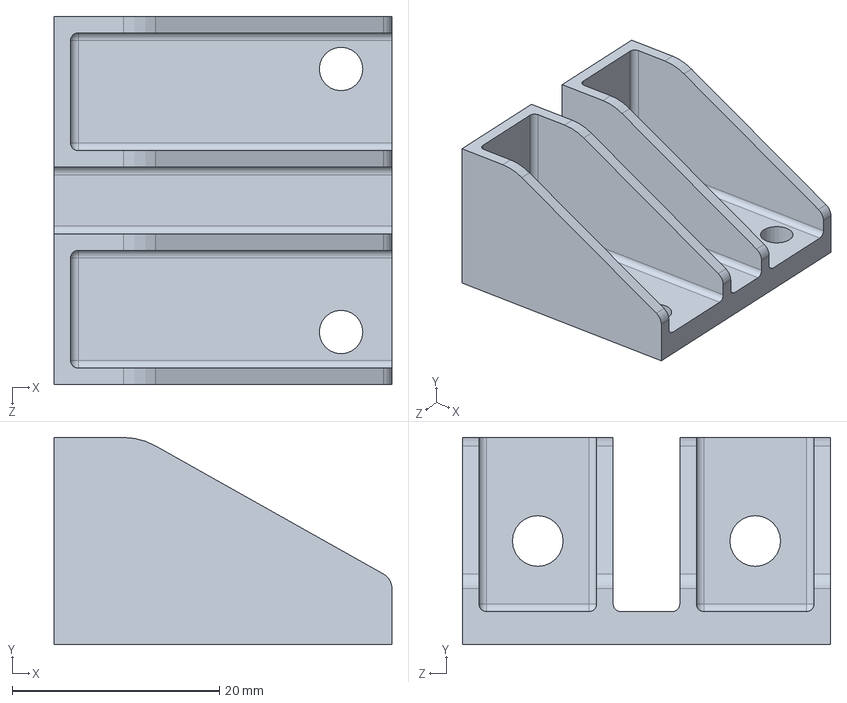
[picture p85: CAD file, 2023-07-21]
Mechanical/Rear Shelves/Rear Frame - Sensors and mounts/Ouster Driver/Ouster Driver Mount.SLDPRT
32.6 x 20.0 x 35.6 mm
