mlab-upenn/gokart-mechatronics/Mechanical/Rear Shelves/Rear Frame - Sensors and mounts/Ouster/Alum_prof_resized_short.SLDPRT

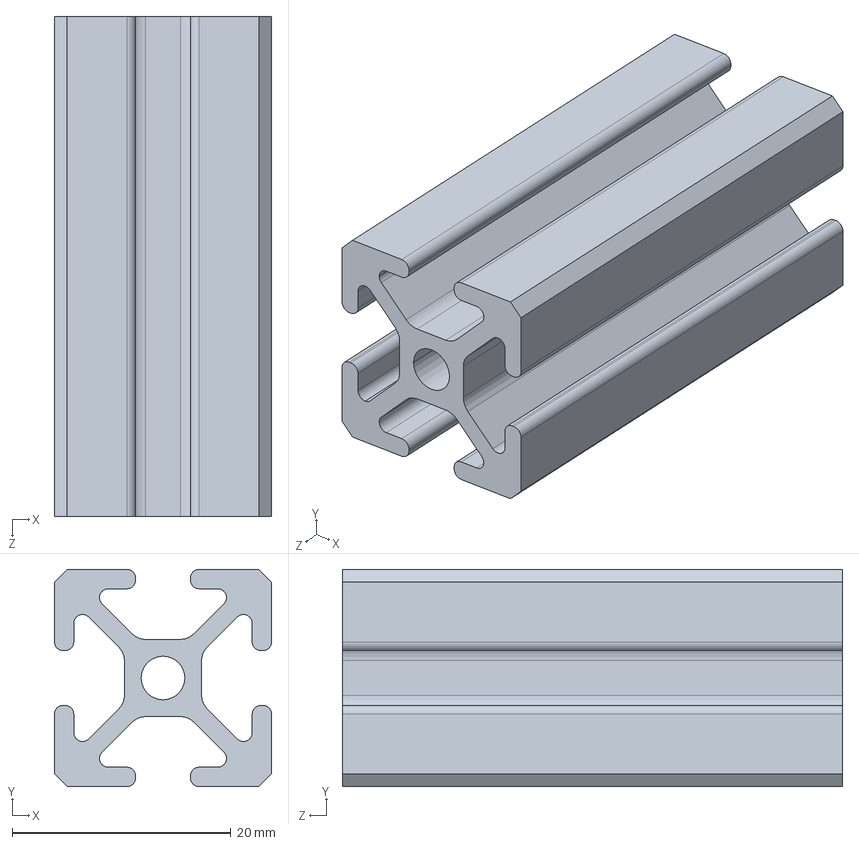
[picture p86: CAD file, 2023-07-21]
Mechanical/Rear Shelves/Rear Frame - Sensors and mounts/Ouster/Alum_prof_resized_short.SLDPRT
19.9 x 19.9 x 45.7 mm
