mlab-upenn/gokart-mechatronics/Mechanical/Rear Shelves/Rear Frame - Sensors and mounts/RC Receiver/RC Receiver.SLDPRT

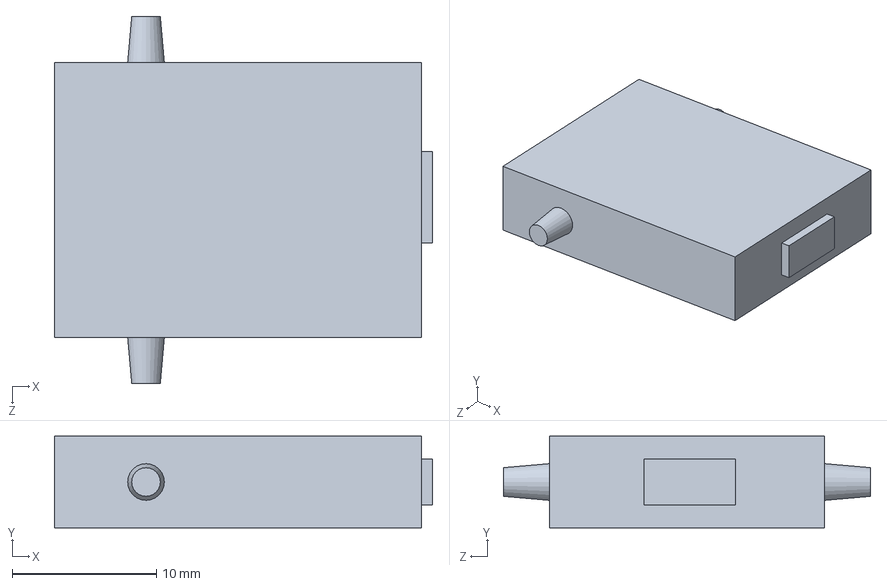
[picture p87: CAD file, 2023-07-21]
Mechanical/Rear Shelves/Rear Frame - Sensors and mounts/RC Receiver/RC Receiver.SLDPRT
26.2 x 6.35 x 25.4 mm
