mlab-upenn/gokart-mechatronics/Mechanical/Rear Shelves/String.SLDPRT

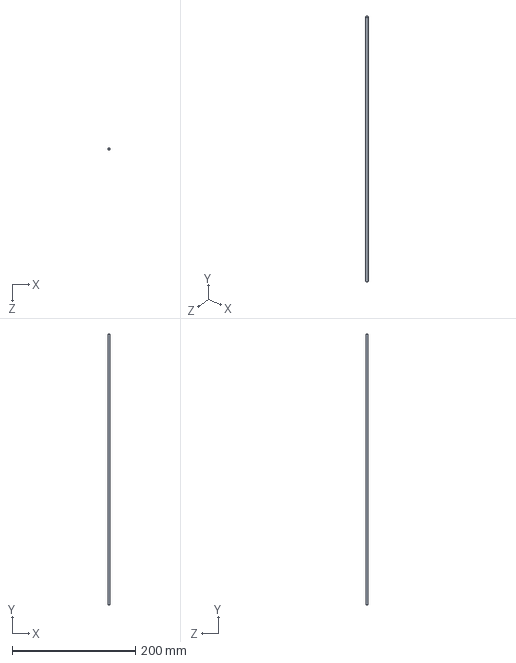
[picture p88: CAD file, 2023-07-21]
Mechanical/Rear Shelves/String.SLDPRT
4.00 x 440.1 x 4.00 mm
