mlab-upenn/gokart-mechatronics/Mechanical/SBW - upper/STL/beam.STL

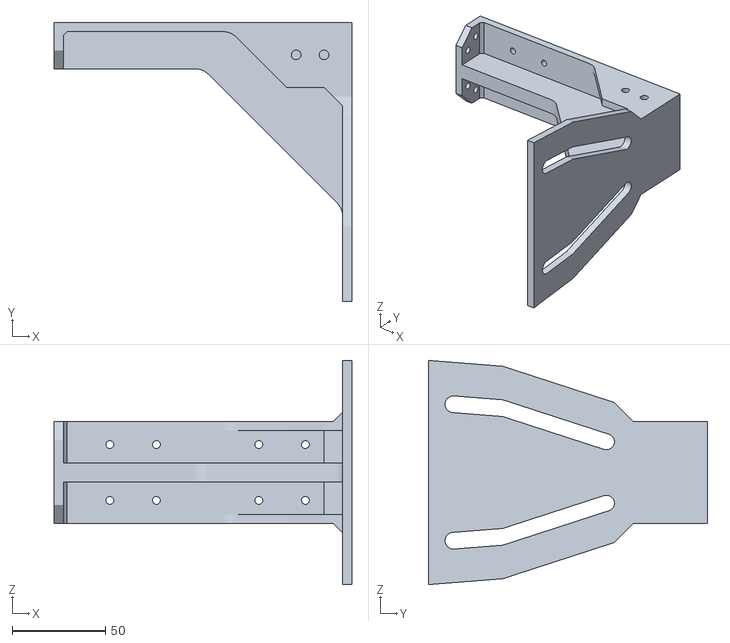
[picture p89: CAD file, 2023-08-29]
Mechanical/SBW - upper/STL/beam.STL
160.0 x 150.0 x 120.4
