mlab-upenn/gokart-mechatronics/Mechanical/SBW - upper/sw bushing.SLDPRT

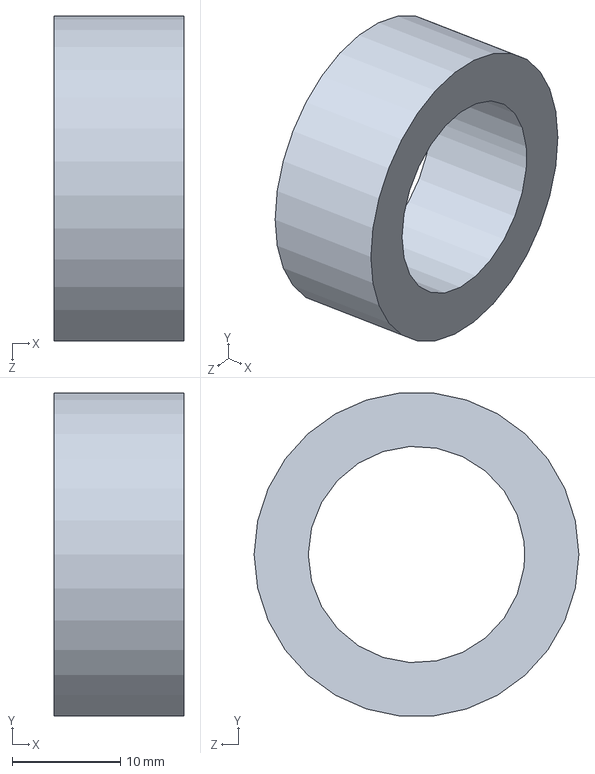
[picture p90: CAD file, 2022-12-17]
Mechanical/SBW - upper/sw bushing.SLDPRT
12.0 x 29.8 x 30.0 mm
