mlab-upenn/gokart-mechatronics/Mechanical/SBW - upper/USBW ASM/sw mount.SLDPRT

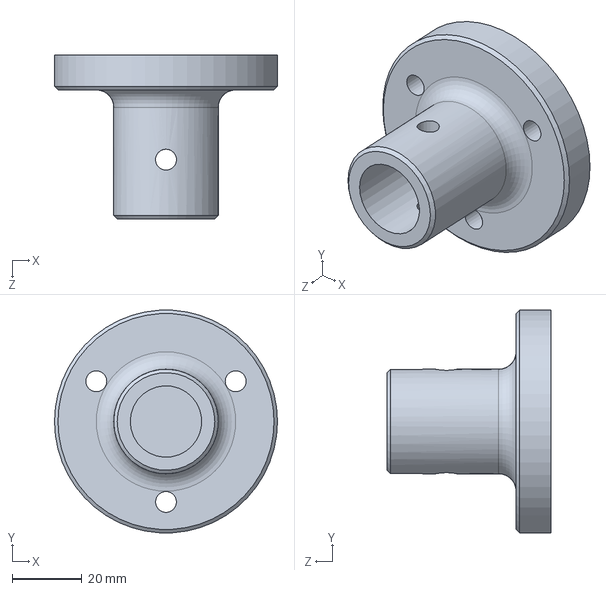
[picture p91: CAD file, 2023-08-19]
Mechanical/SBW - upper/USBW ASM/sw mount.SLDPRT
64.0 x 63.9 x 47.0 mm
