mlab-upenn/gokart-mechatronics/Mechanical/BBW controller mount/converter.SLDPRT

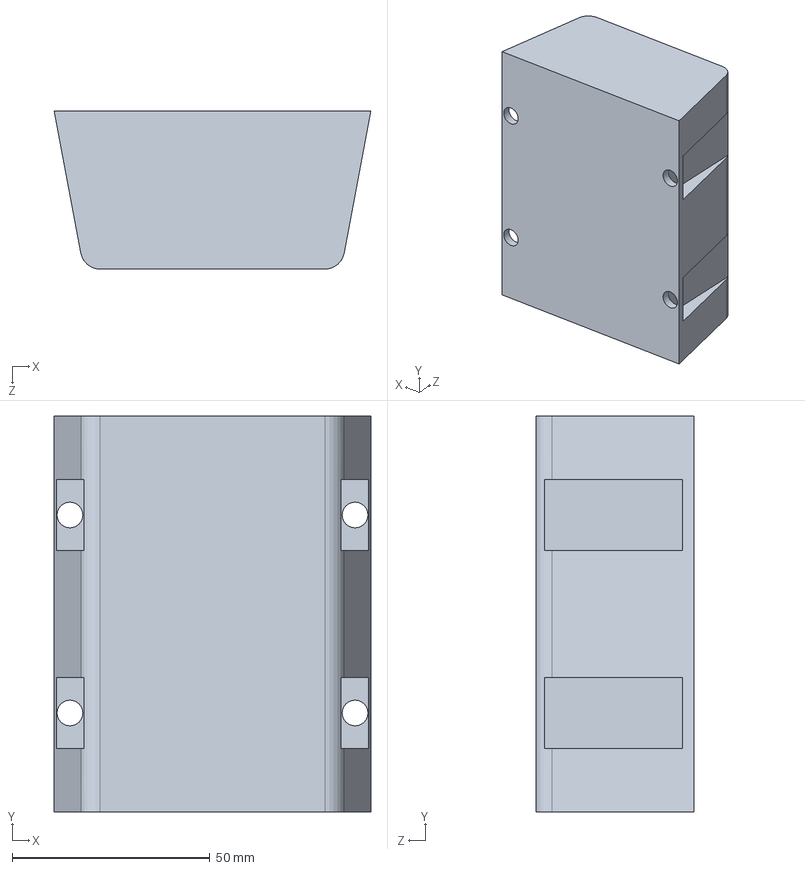
[picture p92: CAD file, 2023-08-09]
Mechanical/BBW controller mount/converter.SLDPRT
80.0 x 100.0 x 40.0 mm
