mlab-upenn/gokart-mechatronics/Mechanical/BBW/STL/sleeve 15mm.STL

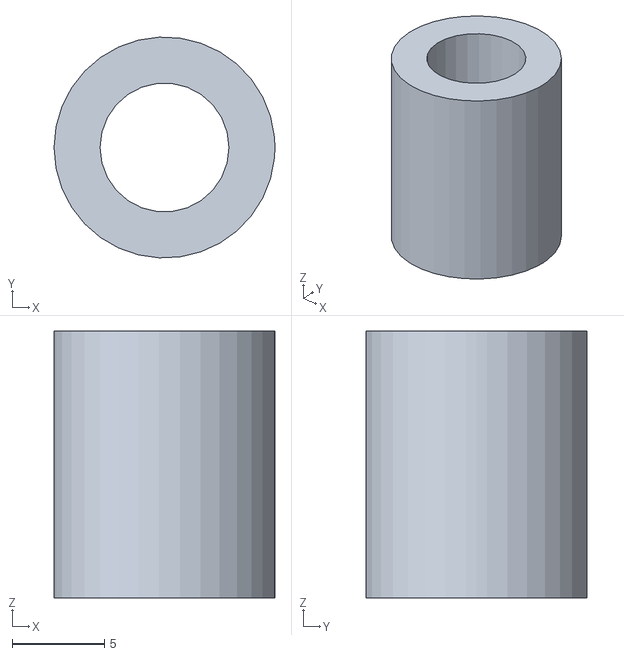
[picture p93: CAD file, 2022-12-17]
Mechanical/BBW/STL/sleeve 15mm.STL
12.0 x 12.0 x 14.5
