mlab-upenn/gokart-mechatronics/Mechanical/Rear Shelves/Rear Frame - Metal/T-slots/T-slot frame 160mm.SLDPRT

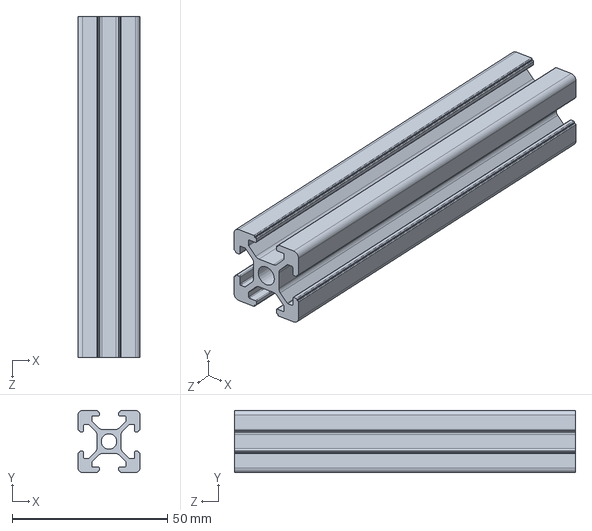
[picture p94: CAD file, 2023-07-21]
Mechanical/Rear Shelves/Rear Frame - Metal/T-slots/T-slot frame 160mm.SLDPRT
20.0 x 20.0 x 110.0 mm
