mlab-upenn/gokart-mechatronics/Mechanical/Rear Shelves/Rear Frame - Sensors and mounts/Antenna/Mount_Vertical_Close_Outer_Top.SLDPRT

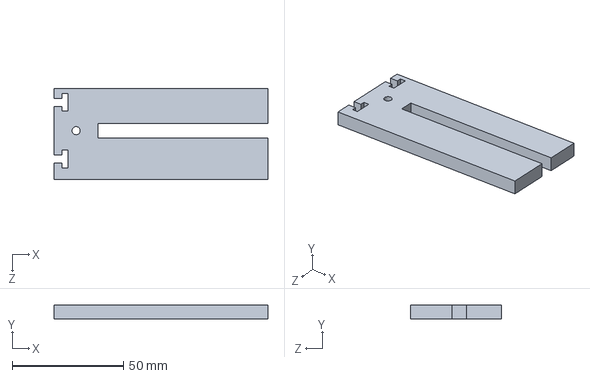
[picture p95: CAD file, 2023-06-22]
Mechanical/Rear Shelves/Rear Frame - Sensors and mounts/Antenna/Mount_Vertical_Close_Outer_Top.SLDPRT
96.1 x 6.35 x 41.1 mm
