mlab-upenn/gokart-mechatronics/Mechanical/Rear Shelves/Rear Frame - Sensors and mounts/GNSS/GNSS.SLDPRT

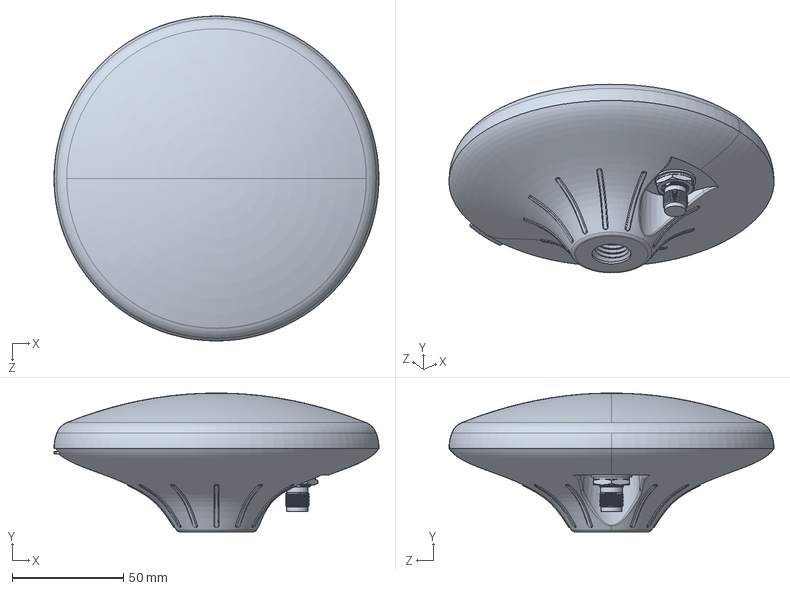
[picture p96: CAD file, 2023-07-20]
Mechanical/Rear Shelves/Rear Frame - Sensors and mounts/GNSS/GNSS.SLDPRT
146.2 x 62.5 x 146.2 mm
