mlab-upenn/gokart-mechatronics/Mechanical/Rear Shelves/Rear Frame - Sensors and mounts/Ouster Driver/Ouster Driver.SLDPRT

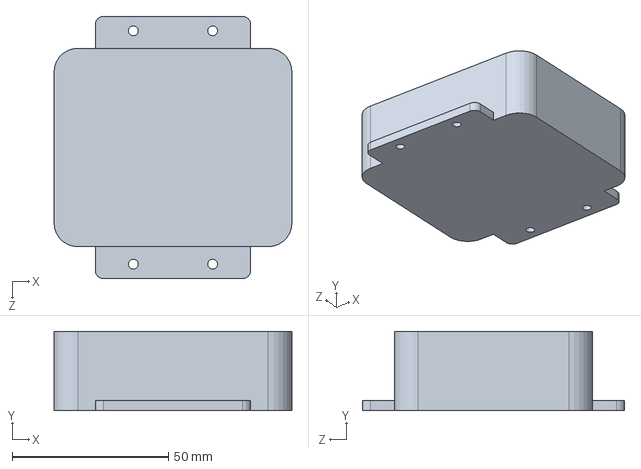
[picture p97: CAD file, 2023-07-21]
Mechanical/Rear Shelves/Rear Frame - Sensors and mounts/Ouster Driver/Ouster Driver.SLDPRT
76.2 x 25.4 x 83.9 mm
