mlab-upenn/gokart-mechatronics/Mechanical/Rear Shelves/Rear Frame - Sensors and mounts/Ouster/Corner.SLDPRT

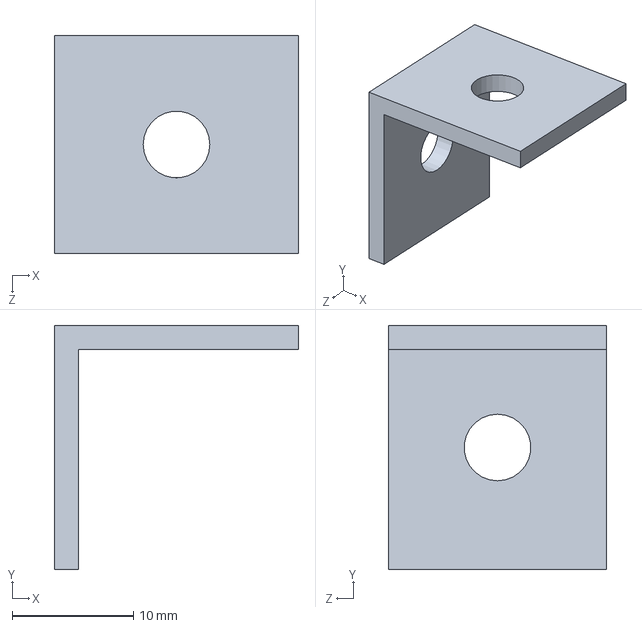
[picture p98: CAD file, 2023-07-21]
Mechanical/Rear Shelves/Rear Frame - Sensors and mounts/Ouster/Corner.SLDPRT
20.1 x 20.1 x 18.0 mm
