mlab-upenn/gokart-mechatronics/Mechanical/Rear Shelves/Rear Frame - Sensors and mounts/RC Receiver/RC Receiver Mount.SLDPRT

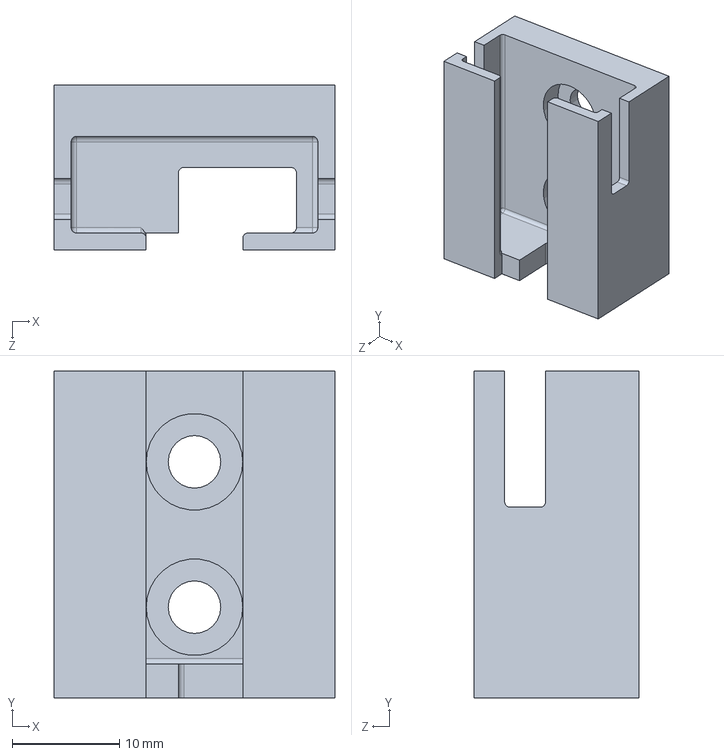
[picture p99: CAD file, 2023-07-21]
Mechanical/Rear Shelves/Rear Frame - Sensors and mounts/RC Receiver/RC Receiver Mount.SLDPRT
26.2 x 30.5 x 15.4 mm
