mlab-upenn/gokart-mechatronics/Mechanical/SBW - lower/LSBW ASM/MAXPlanetary 3-Stage.SLDPRT

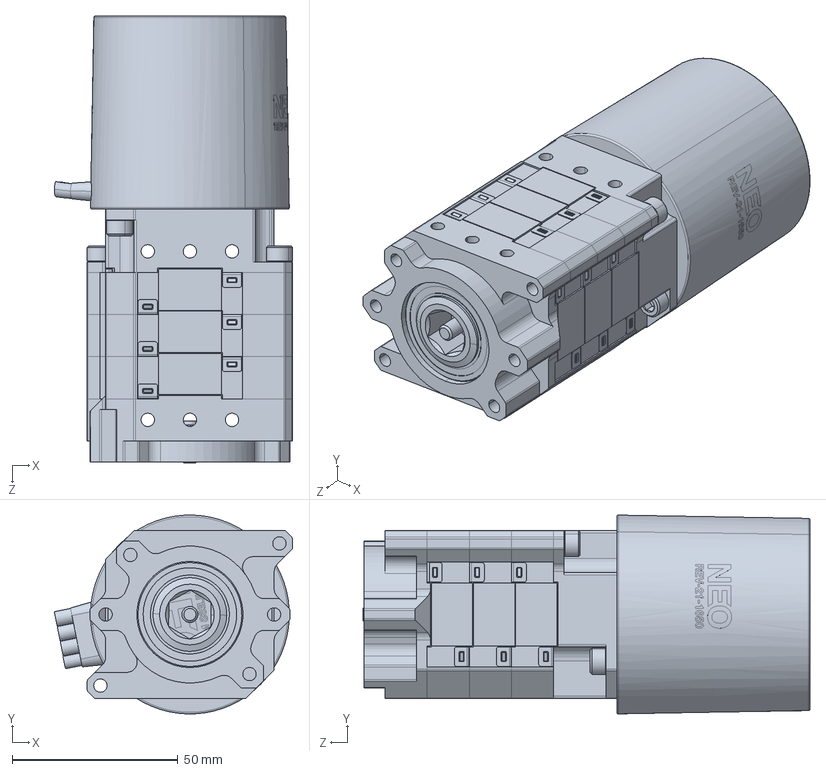
[picture p100: CAD file, 2023-08-09]
Mechanical/SBW - lower/LSBW ASM/MAXPlanetary 3-Stage.SLDPRT
71.8 x 59.9 x 134.8 mm
