mlab-upenn/gokart-mechatronics/Mechanical/SBW - upper/STL/Pololu mount.STL

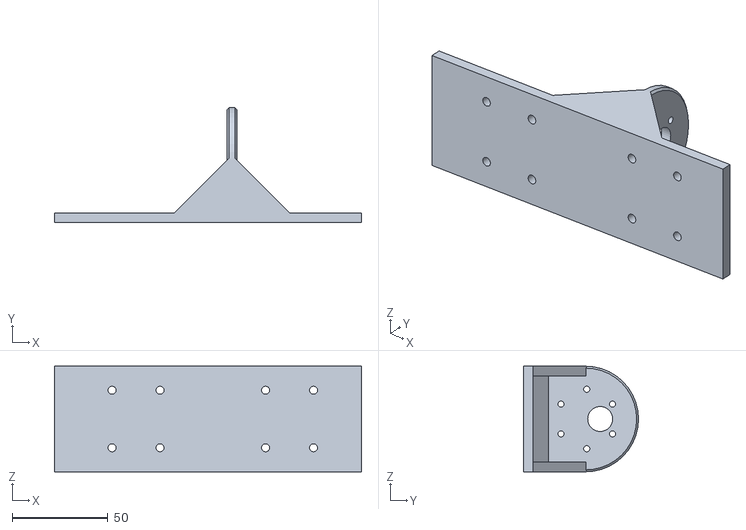
[picture p101: CAD file, 2023-08-29]
Mechanical/SBW - upper/STL/Pololu mount.STL
160.0 x 60.0 x 55.0
