mlab-upenn/gokart-mechatronics/Mechanical/SBW - upper/USBW ASM/shaft mount.SLDPRT

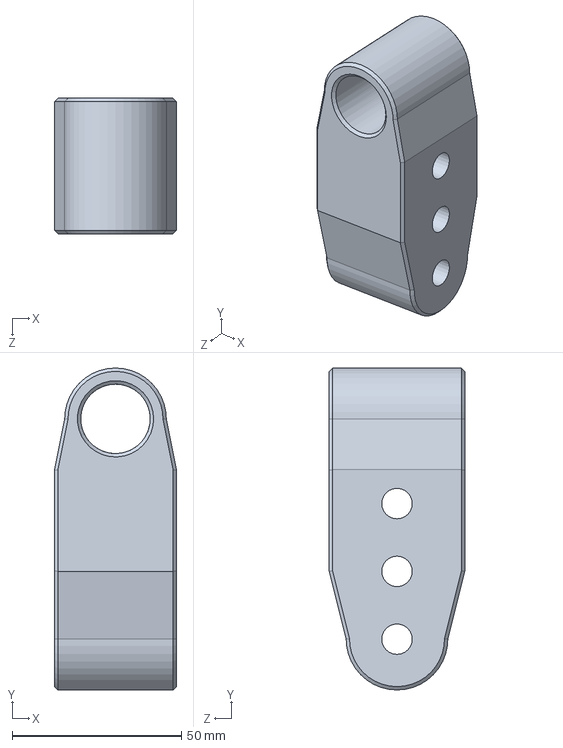
[picture p102: CAD file, 2023-08-19]
Mechanical/SBW - upper/USBW ASM/shaft mount.SLDPRT
36.0 x 95.0 x 40.0 mm
