mlab-upenn/gokart-mechatronics/Mechanical/BBW controller mount/lower clutch.SLDPRT

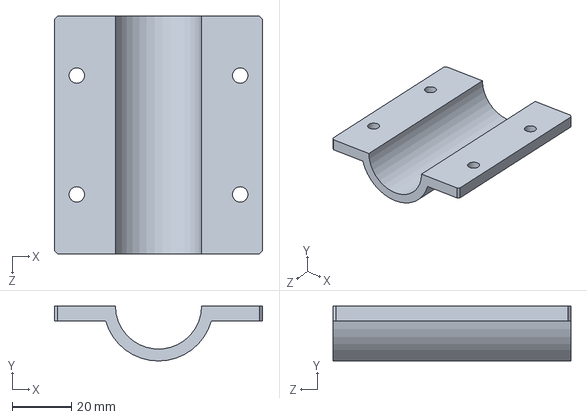
[picture p103: CAD file, 2023-08-09]
Mechanical/BBW controller mount/lower clutch.SLDPRT
70.0 x 18.5 x 80.0 mm
