mlab-upenn/gokart-mechatronics/Mechanical/BBW/Brake_rod_locator.SLDPRT

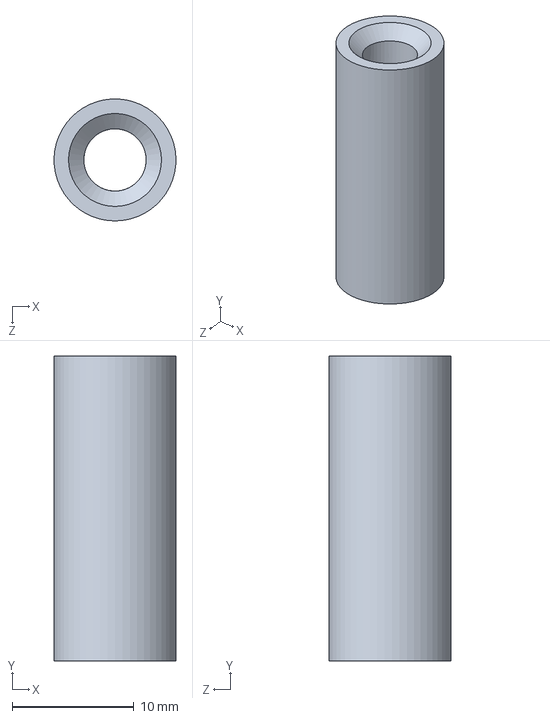
[picture p105: CAD file, 2023-08-28]
Mechanical/BBW/Brake_rod_locator.SLDPRT
10.00 x 25.0 x 9.99 mm
