mlab-upenn/gokart-mechatronics/Mechanical/BBW/STL/back link.STL

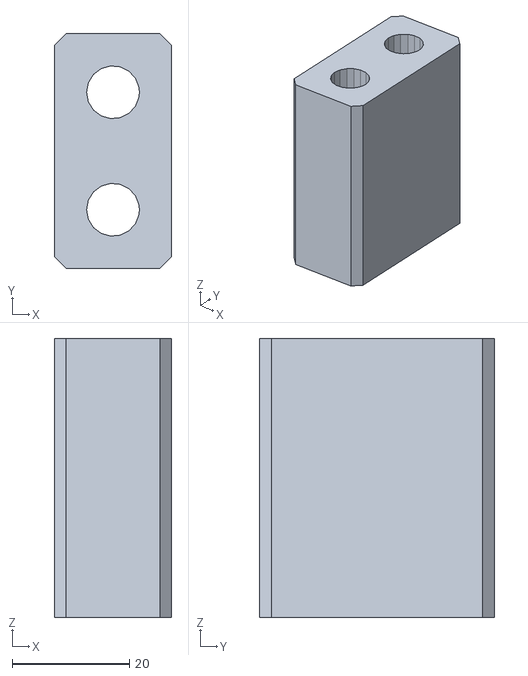
[picture p106: CAD file, 2022-12-17]
Mechanical/BBW/STL/back link.STL
20.0 x 40.0 x 47.5
