mlab-upenn/gokart-mechatronics/Mechanical/Eve_autonomy/Tslot2.SLDPRT

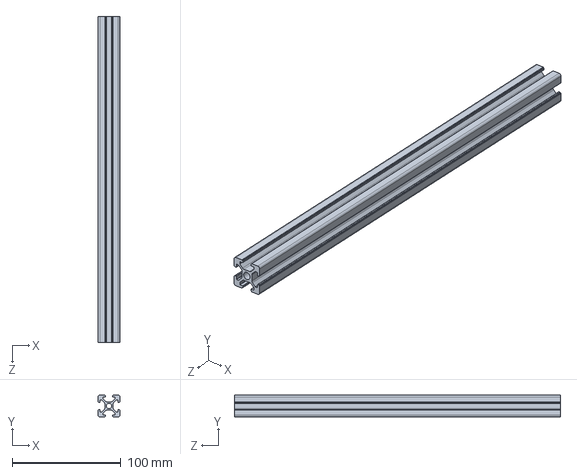
[picture p107: CAD file, 2024-02-15]
Mechanical/Eve_autonomy/Tslot2.SLDPRT
20.0 x 20.0 x 300.0 mm
