mlab-upenn/gokart-mechatronics/Mechanical/Rear axle sensor/rear_sensor_mount.SLDPRT

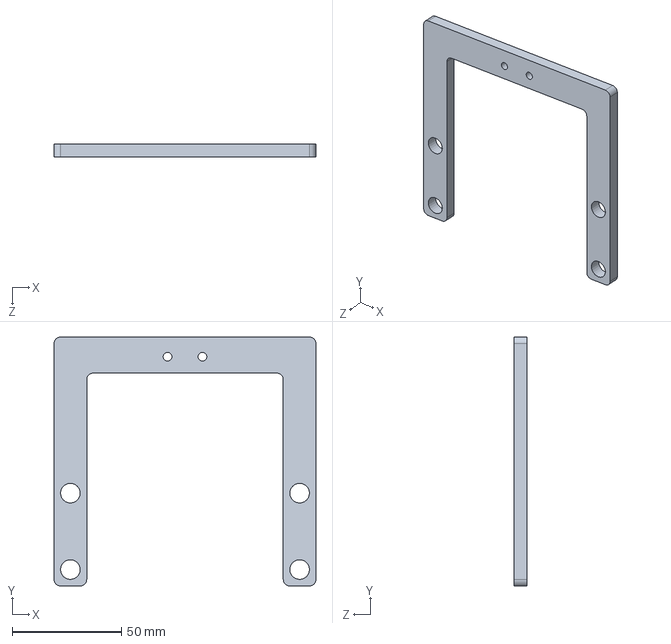
[picture p108: CAD file, 2023-08-17]
Mechanical/Rear axle sensor/rear_sensor_mount.SLDPRT
120.0 x 114.0 x 6.00 mm
