mlab-upenn/gokart-mechatronics/Mechanical/Rear Shelves/Rear Frame - Metal/PCB Mount.SLDPRT

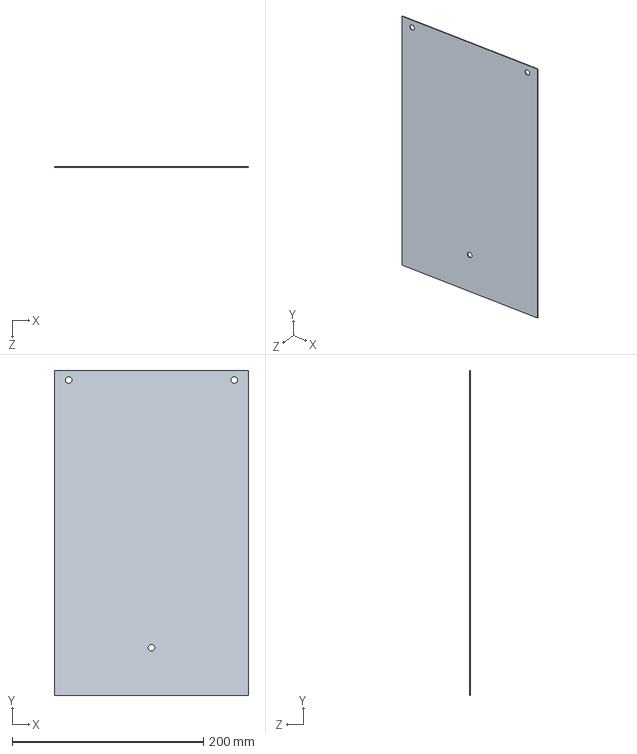
[picture p109: CAD file, 2023-07-20]
Mechanical/Rear Shelves/Rear Frame - Metal/PCB Mount.SLDPRT
203.2 x 340.0 x 0.9 mm
