mlab-upenn/gokart-mechatronics/Mechanical/Rear Shelves/Rear Frame - Sensors and mounts/Antenna/Mount_Vertical_Far_v2.SLDPRT

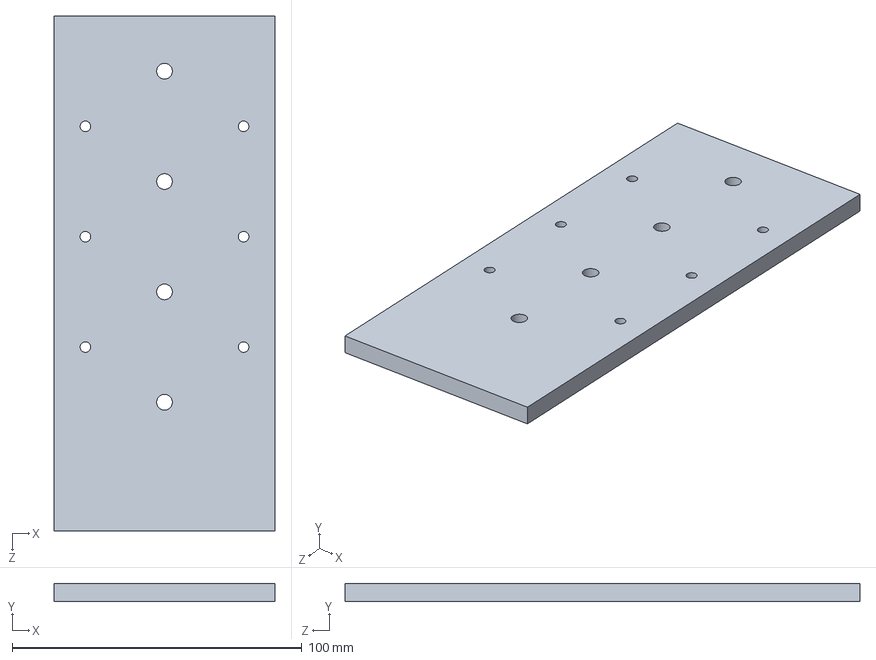
[picture p110: CAD file, 2023-06-22]
Mechanical/Rear Shelves/Rear Frame - Sensors and mounts/Antenna/Mount_Vertical_Far_v2.SLDPRT
76.2 x 6.35 x 177.8 mm
