mlab-upenn/gokart-mechatronics/Mechanical/Rear Shelves/Rear Frame - Sensors and mounts/Ouster/Alum_prof_resized_shorter.SLDPRT

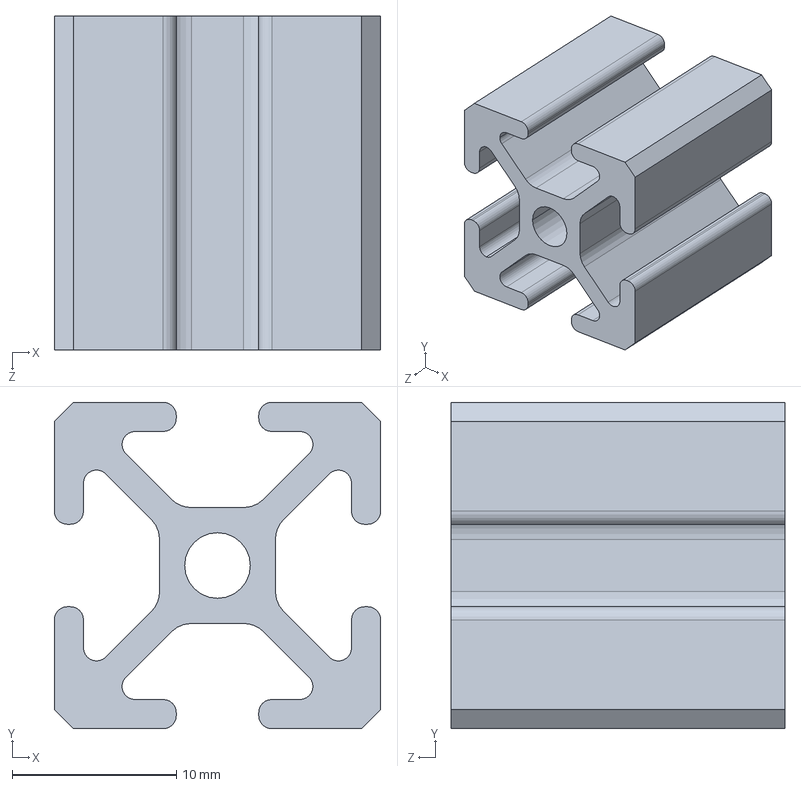
[picture p111: CAD file, 2023-07-21]
Mechanical/Rear Shelves/Rear Frame - Sensors and mounts/Ouster/Alum_prof_resized_shorter.SLDPRT
19.9 x 19.9 x 20.3 mm
