mlab-upenn/gokart-mechatronics/Mechanical/SBW - lower/bearing mount.SLDPRT

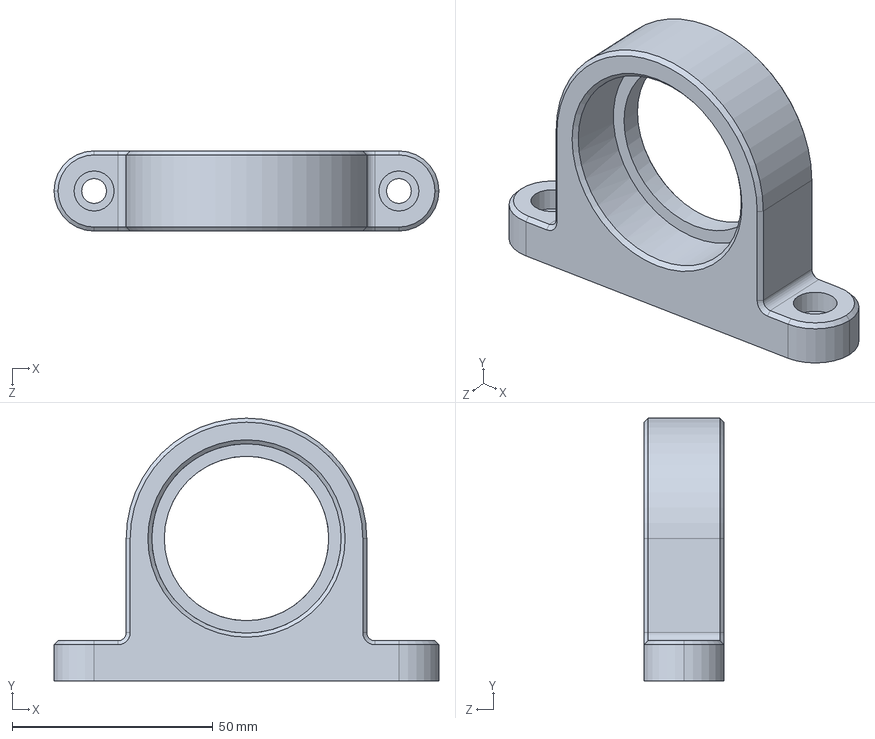
[picture p112: CAD file, 2023-09-13]
Mechanical/SBW - lower/bearing mount.SLDPRT
96.0 x 65.5 x 20.0 mm
