mlab-upenn/gokart-mechatronics/Mechanical/SBW - lower/LSBW ASM/BLDC mount - V9.SLDPRT

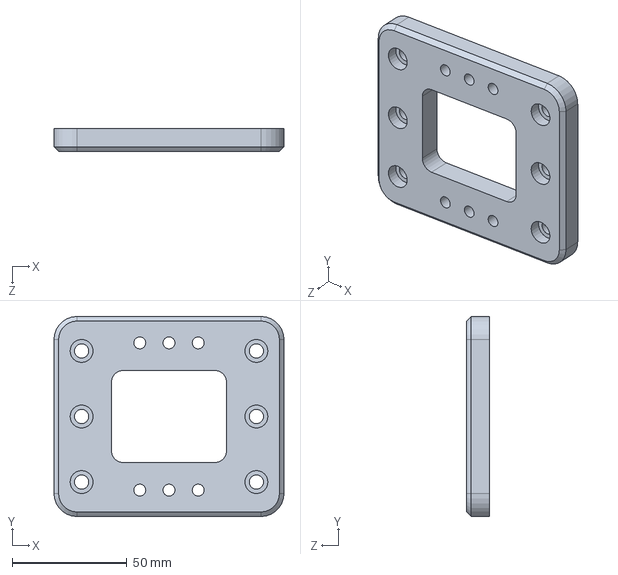
[picture p113: CAD file, 2023-08-09]
Mechanical/SBW - lower/LSBW ASM/BLDC mount - V9.SLDPRT
100.0 x 87.0 x 10.0 mm
