mlab-upenn/gokart-mechatronics/Mechanical/SBW - upper/STL/rounded spacer.STL

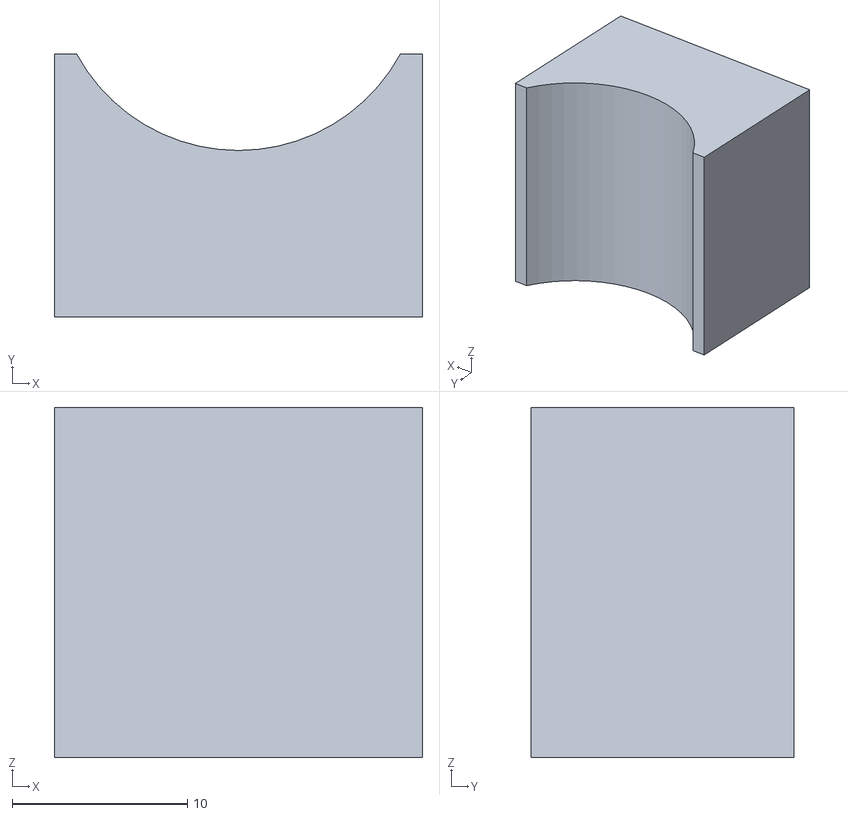
[picture p114: CAD file, 2023-08-29]
Mechanical/SBW - upper/STL/rounded spacer.STL
21.0 x 15.0 x 20.0
