mlab-upenn/gokart-mechatronics/Mechanical/SBW - upper/USBW ASM/sw shaft.SLDPRT

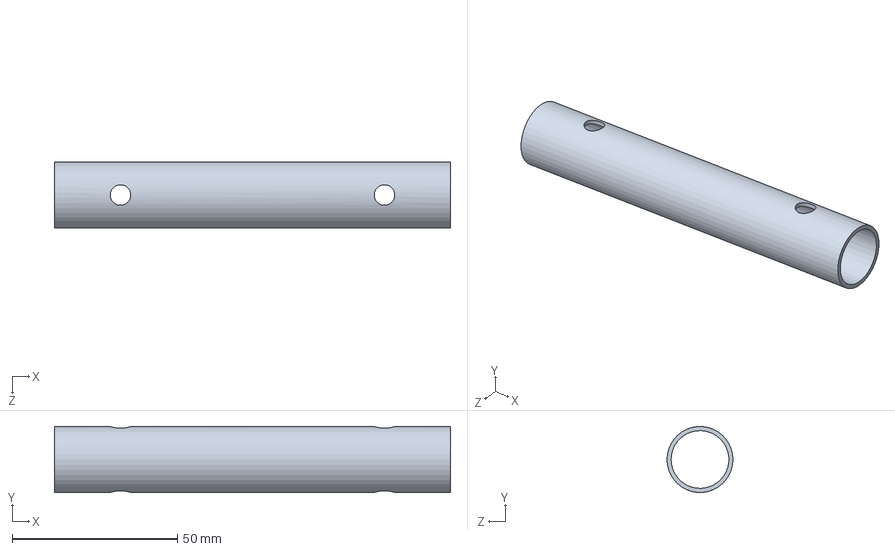
[picture p115: CAD file, 2023-08-19]
Mechanical/SBW - upper/USBW ASM/sw shaft.SLDPRT
120.0 x 20.0 x 20.0 mm
