mlab-upenn/gokart-mechatronics/Mechanical/Battery Mount/vertical sheet sides.SLDPRT

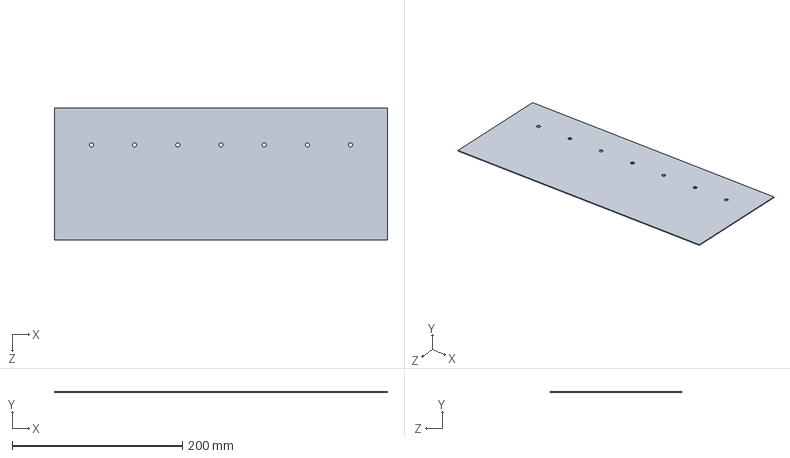
[picture p116: CAD file, 2024-02-22]
Mechanical/Battery Mount/vertical sheet sides.SLDPRT
391.7 x 1.00 x 155.0 mm
