mlab-upenn/gokart-mechatronics/Mechanical/BBW controller mount/chassis frame.SLDPRT

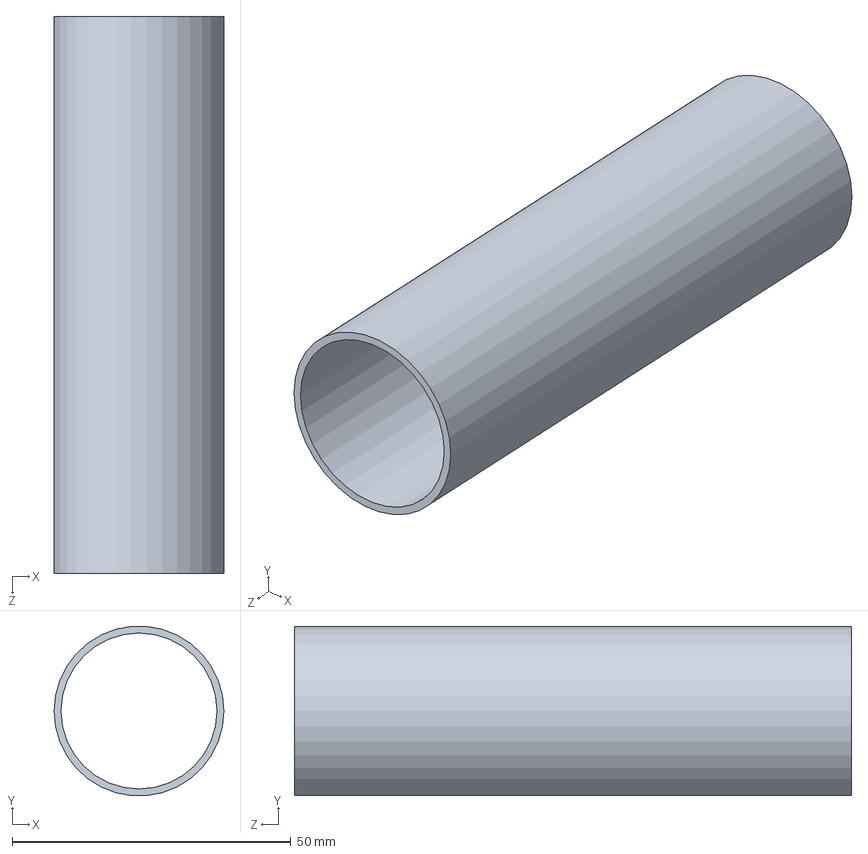
[picture p117: CAD file, 2023-08-09]
Mechanical/BBW controller mount/chassis frame.SLDPRT
30.5 x 30.4 x 100.0 mm
