mlab-upenn/gokart-mechatronics/Mechanical/BBW/BBW ASM/TopKart reservoir frame.SLDPRT

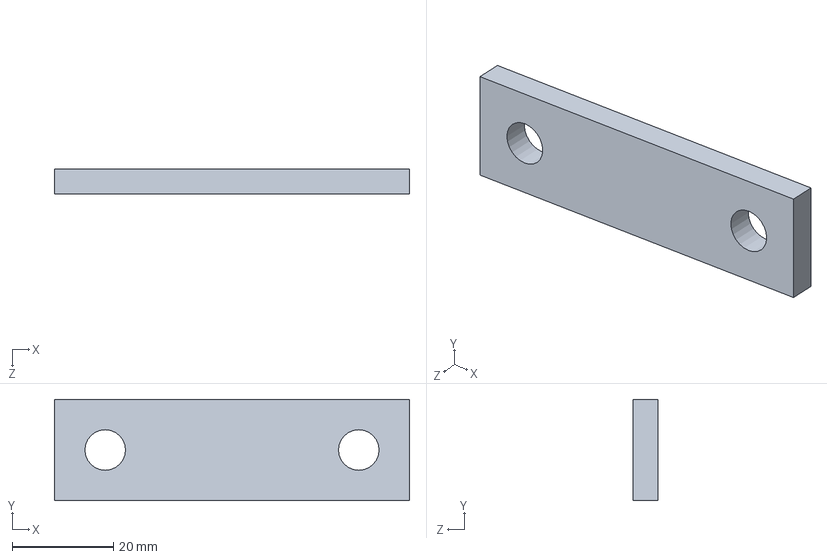
[picture p118: CAD file, 2023-08-10]
Mechanical/BBW/BBW ASM/TopKart reservoir frame.SLDPRT
70.0 x 20.0 x 5.00 mm
