mlab-upenn/gokart-mechatronics/Mechanical/BBW/Brake_rod_extender.SLDPRT

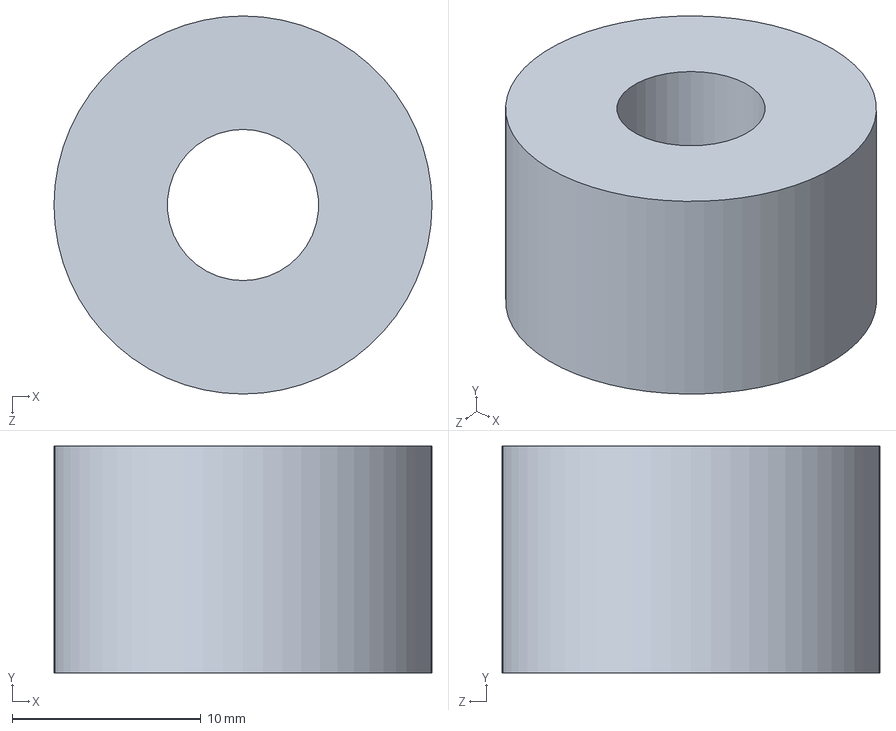
[picture p119: CAD file, 2023-08-28]
Mechanical/BBW/Brake_rod_extender.SLDPRT
20.0 x 12.0 x 20.0 mm
