mlab-upenn/gokart-mechatronics/Mechanical/Eve_autonomy/Tslot1.SLDPRT

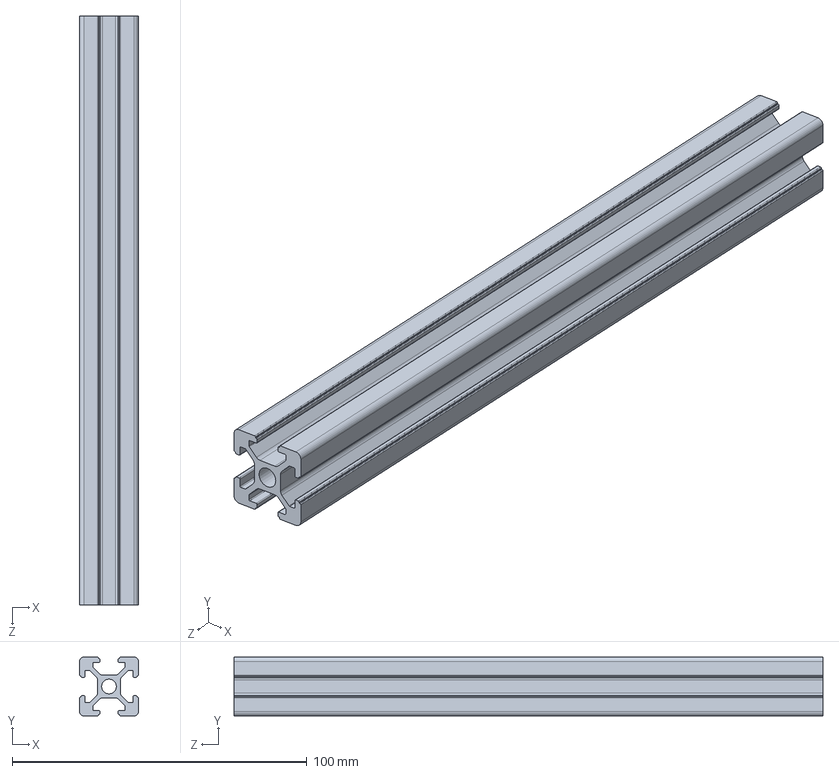
[picture p120: CAD file, 2024-02-15]
Mechanical/Eve_autonomy/Tslot1.SLDPRT
20.0 x 20.0 x 200.0 mm
