mlab-upenn/gokart-mechatronics/Mechanical/Rear Shelves/Rear Frame - Metal/T-slots/T-slot frame 616mm.SLDPRT

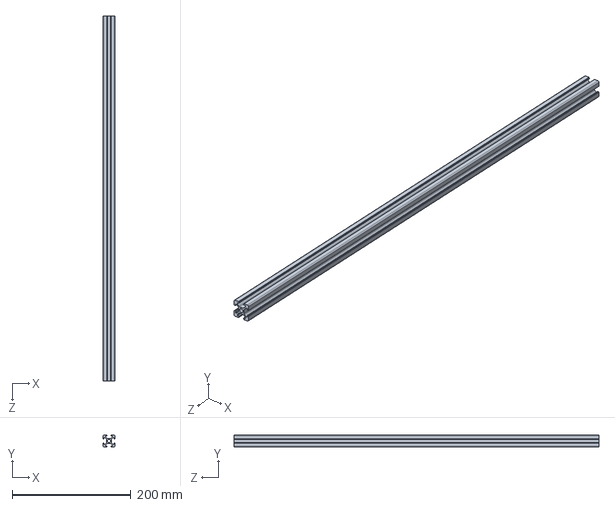
[picture p121: CAD file, 2023-07-20]
Mechanical/Rear Shelves/Rear Frame - Metal/T-slots/T-slot frame 616mm.SLDPRT
20.0 x 20.0 x 616.0 mm
