mlab-upenn/gokart-mechatronics/Mechanical/Rear Shelves/Rear Frame - Metal/Trapezoid-Link.SLDPRT

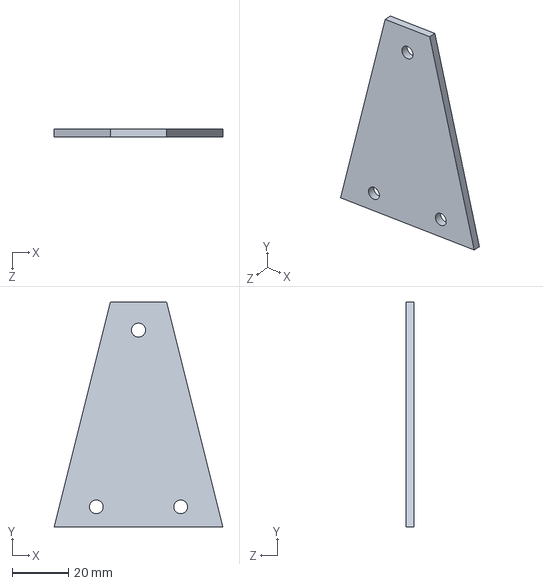
[picture p122: CAD file, 2023-04-07]
Mechanical/Rear Shelves/Rear Frame - Metal/Trapezoid-Link.SLDPRT
60.0 x 80.0 x 3.00 mm
