mlab-upenn/gokart-mechatronics/Mechanical/Rear Shelves/Rear Frame - Sensors and mounts/Antenna/Mount_Center_Pocket.SLDPRT

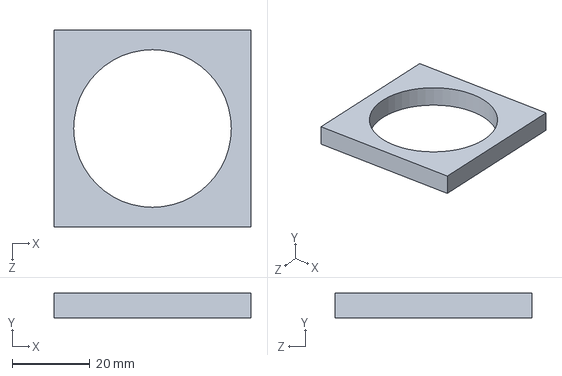
[picture p123: CAD file, 2023-06-22]
Mechanical/Rear Shelves/Rear Frame - Sensors and mounts/Antenna/Mount_Center_Pocket.SLDPRT
50.8 x 6.35 x 50.8 mm
