mlab-upenn/gokart-mechatronics/Mechanical/Rear Shelves/Rear Frame - Sensors and mounts/Ouster/Ouster_Mount.SLDPRT

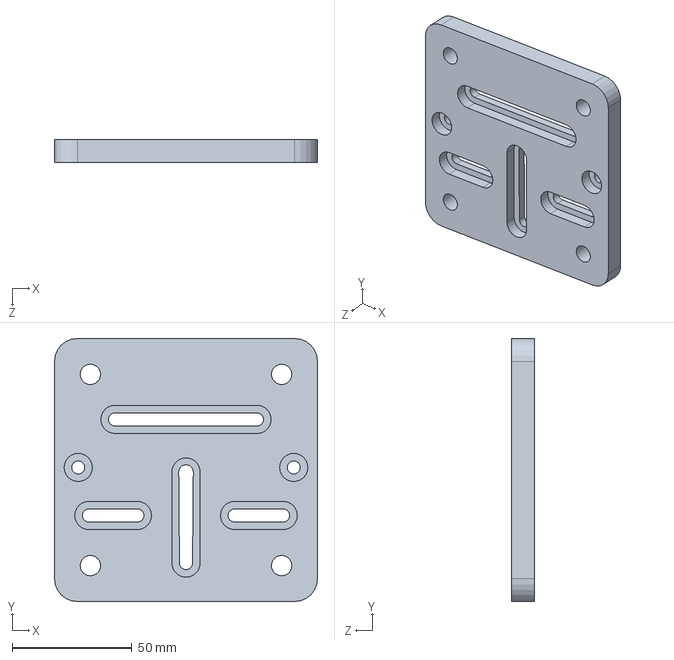
[picture p124: CAD file, 2023-07-21]
Mechanical/Rear Shelves/Rear Frame - Sensors and mounts/Ouster/Ouster_Mount.SLDPRT
110.0 x 110.0 x 9.53 mm
