mlab-upenn/gokart-mechatronics/Mechanical/SBW - lower/BLDC_Front_Half.SLDPRT

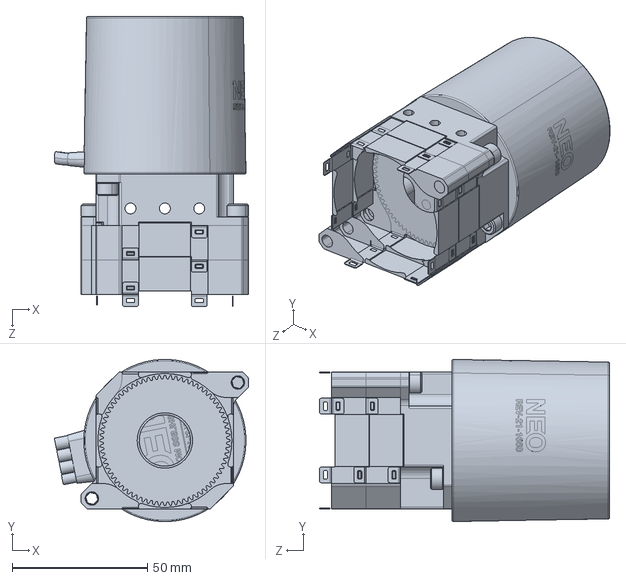
[picture p125: CAD file, 2023-09-13]
Mechanical/SBW - lower/BLDC_Front_Half.SLDPRT
71.8 x 59.9 x 107.2 mm
