mlab-upenn/gokart-mechatronics/Mechanical/SBW - lower/LSBW ASM/sleeve front.SLDPRT

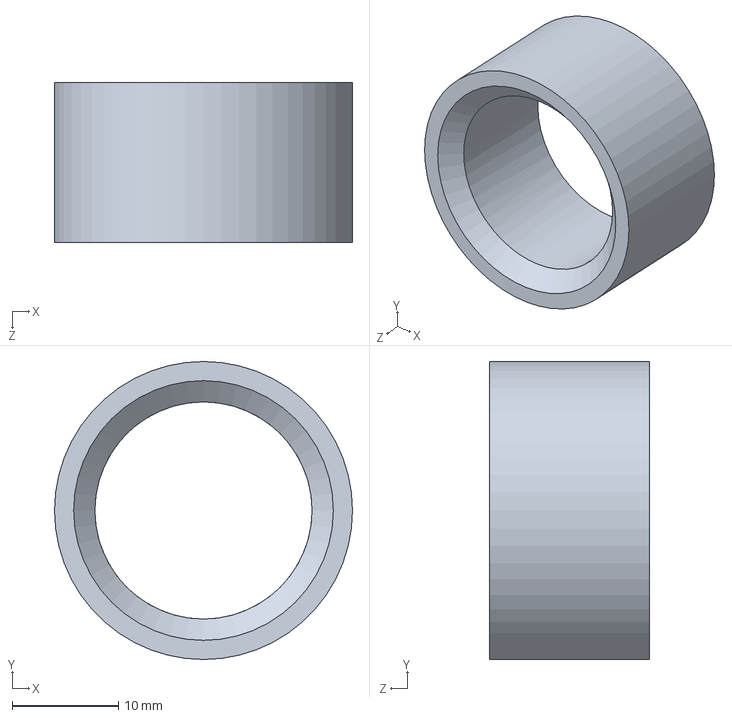
[picture p126: CAD file, 2023-08-09]
Mechanical/SBW - lower/LSBW ASM/sleeve front.SLDPRT
28.0 x 28.0 x 15.0 mm
