mlab-upenn/gokart-mechatronics/Mechanical/SBW - upper/STL/beam link.STL

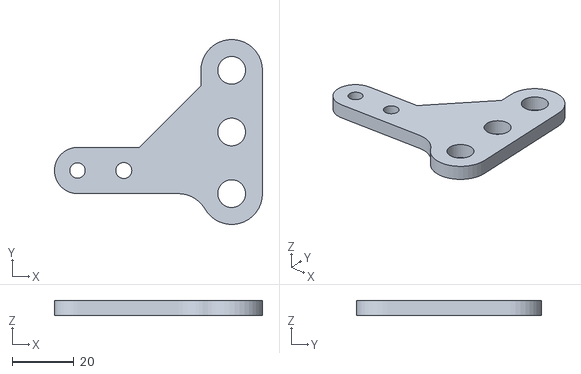
[picture p127: CAD file, 2023-08-29]
Mechanical/SBW - upper/STL/beam link.STL
67.5 x 59.9 x 5.00
