mlab-upenn/gokart-mechatronics/Mechanical/Battery Mount/vertical sheet front and back.SLDPRT

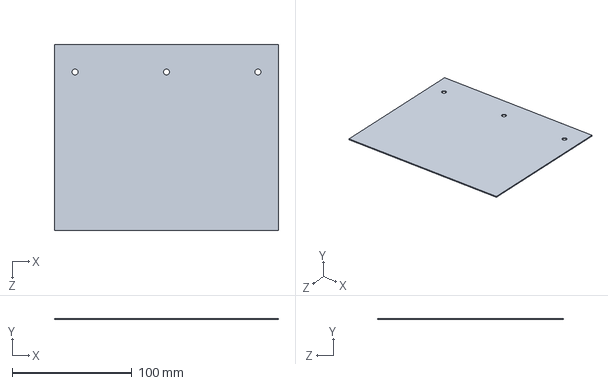
[picture p128: CAD file, 2024-02-22]
Mechanical/Battery Mount/vertical sheet front and back.SLDPRT
186.7 x 1.00 x 155.0 mm
