mlab-upenn/gokart-mechatronics/Mechanical/BBW/BBW ASM/lever arm.SLDPRT

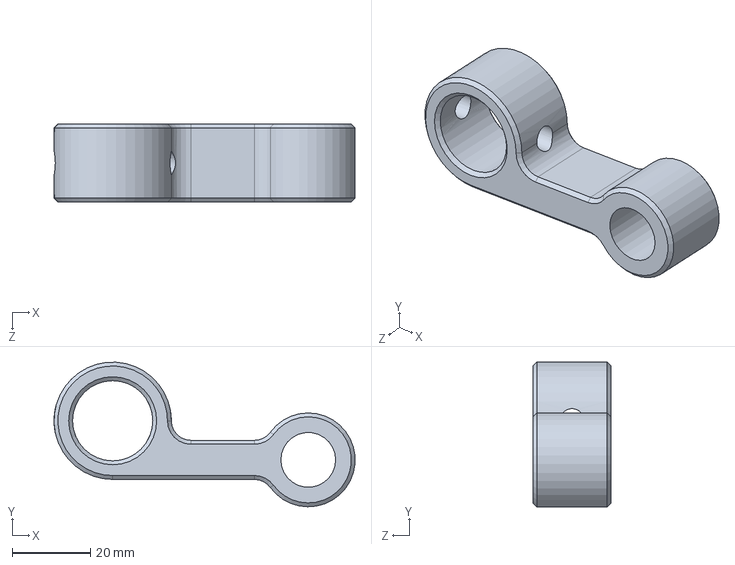
[picture p129: CAD file, 2023-08-10]
Mechanical/BBW/BBW ASM/lever arm.SLDPRT
76.9 x 37.0 x 20.0 mm
