mlab-upenn/gokart-mechatronics/Mechanical/Eve_autonomy/Tslot4.SLDPRT

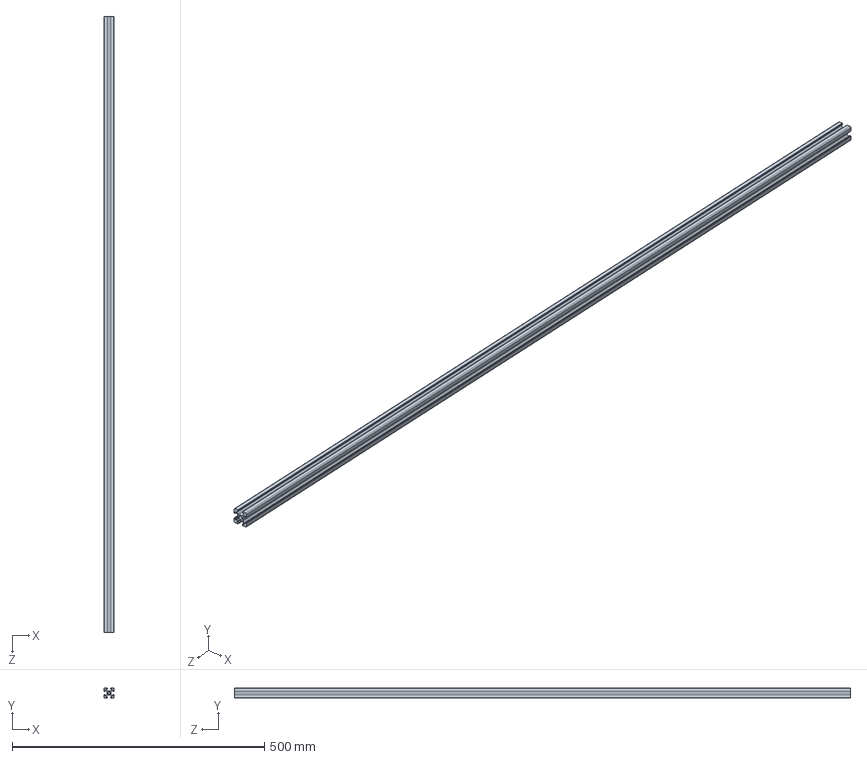
[picture p130: CAD file, 2024-02-15]
Mechanical/Eve_autonomy/Tslot4.SLDPRT
20.0 x 20.0 x 1220.0 mm
