mlab-upenn/gokart-mechatronics/Mechanical/Rear Shelves/Rear Frame - Metal/T-slots/T-slot frame 420mm.SLDPRT

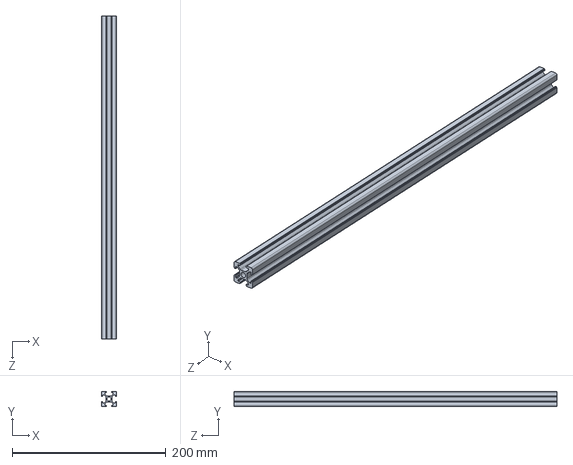
[picture p131: CAD file, 2023-07-20]
Mechanical/Rear Shelves/Rear Frame - Metal/T-slots/T-slot frame 420mm.SLDPRT
20.0 x 20.0 x 420.0 mm
