mlab-upenn/gokart-mechatronics/Mechanical/Rear Shelves/Rear Frame - Sensors and mounts/Ouster/Alum_prof_resized.SLDPRT

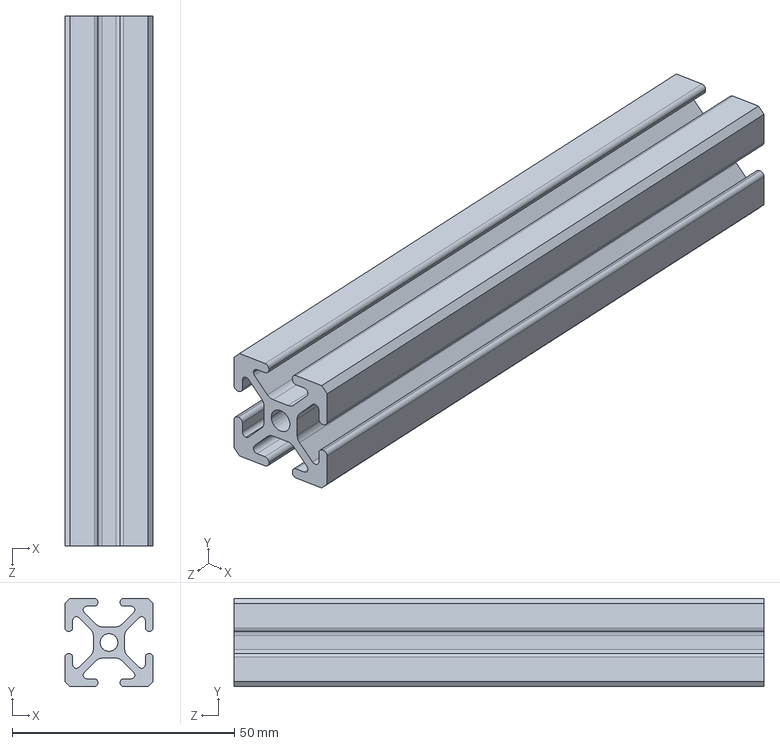
[picture p132: CAD file, 2023-06-22]
Mechanical/Rear Shelves/Rear Frame - Sensors and mounts/Ouster/Alum_prof_resized.SLDPRT
19.9 x 19.9 x 119.2 mm
