mlab-upenn/gokart-mechatronics/Mechanical/SBW - lower/LSBW ASM/magnet mount.SLDPRT

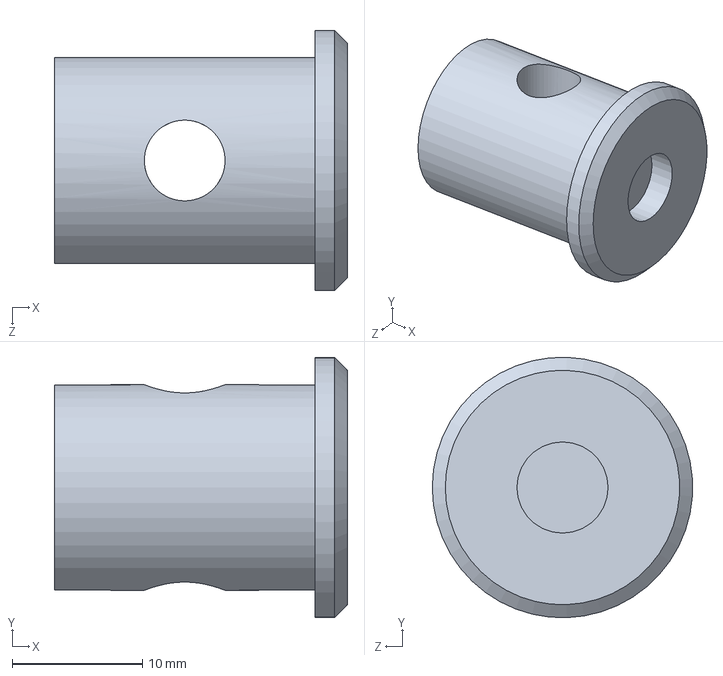
[picture p133: CAD file, 2023-08-09]
Mechanical/SBW - lower/LSBW ASM/magnet mount.SLDPRT
22.5 x 20.0 x 20.0 mm
