mlab-upenn/gokart-mechatronics/Mechanical/SBW - upper/USBW ASM/sw frame.SLDPRT

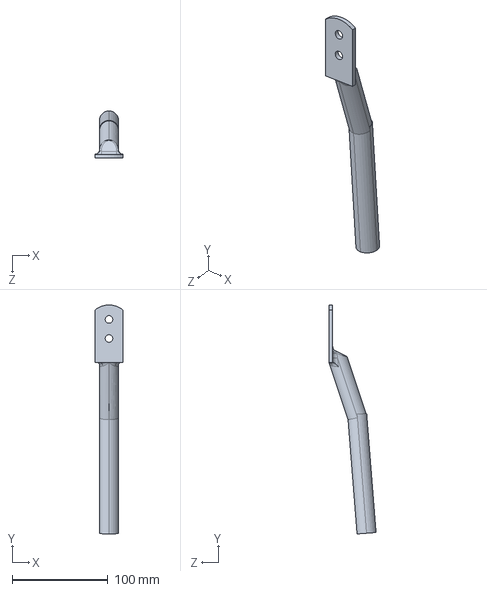
[picture p134: CAD file, 2023-08-15]
Mechanical/SBW - upper/USBW ASM/sw frame.SLDPRT
29.0 x 239.7 x 49.4 mm
