mlab-upenn/gokart-mechatronics/Mechanical/Battery Mount/Tslot1.SLDPRT

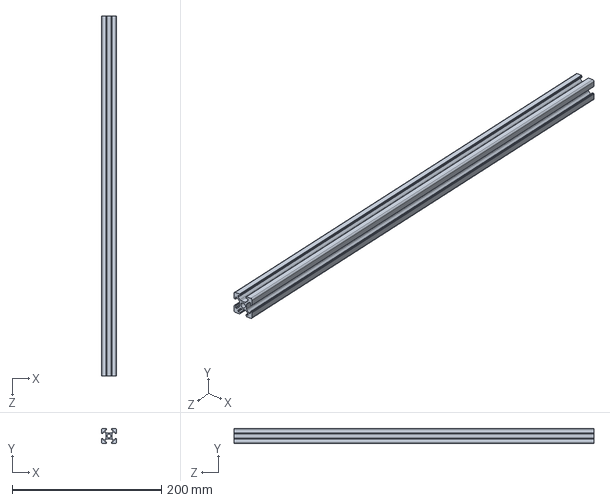
[picture p135: CAD file, 2024-02-22]
Mechanical/Battery Mount/Tslot1.SLDPRT
20.0 x 20.0 x 482.6 mm
