mlab-upenn/gokart-mechatronics/Mechanical/BBW/BBW ASM/LA top mount.SLDPRT

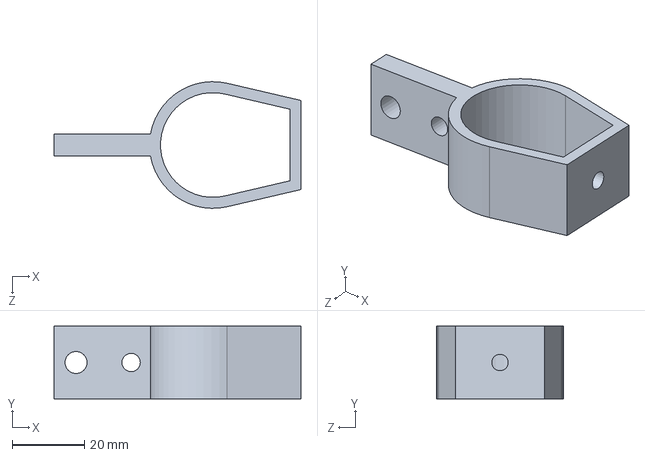
[picture p136: CAD file, 2023-08-10]
Mechanical/BBW/BBW ASM/LA top mount.SLDPRT
68.3 x 20.1 x 35.0 mm
