mlab-upenn/gokart-mechatronics/Mechanical/SBW - lower/LSBW ASM/sleeve back.SLDPRT

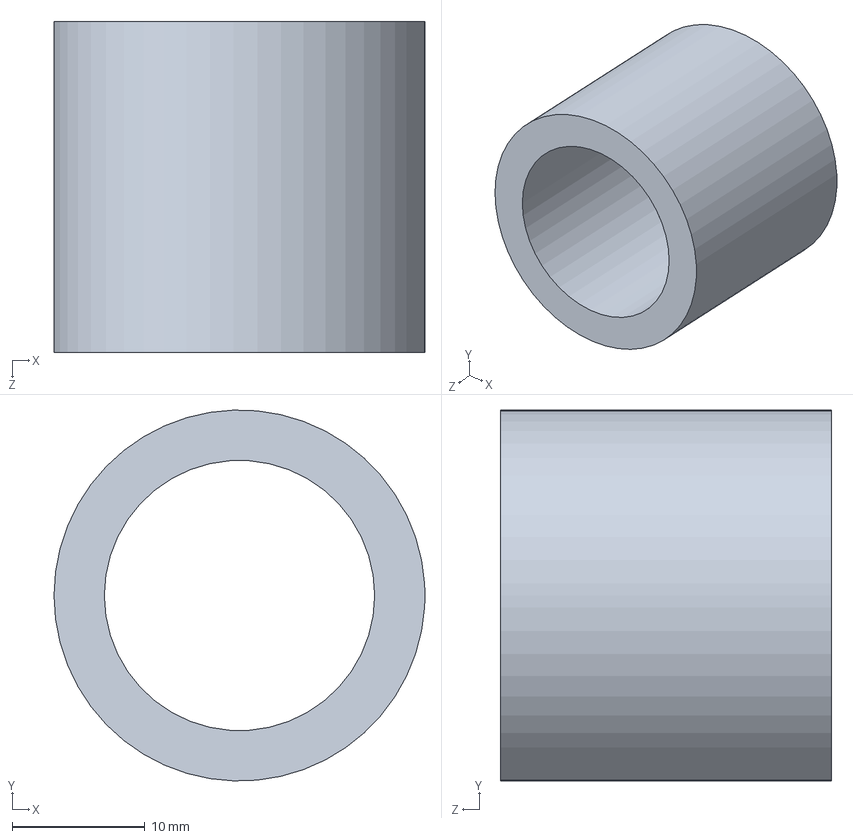
[picture p138: CAD file, 2023-08-09]
Mechanical/SBW - lower/LSBW ASM/sleeve back.SLDPRT
28.0 x 28.0 x 25.0 mm
