mlab-upenn/gokart-mechatronics/Mechanical/SBW - upper/STL/coupler.STL

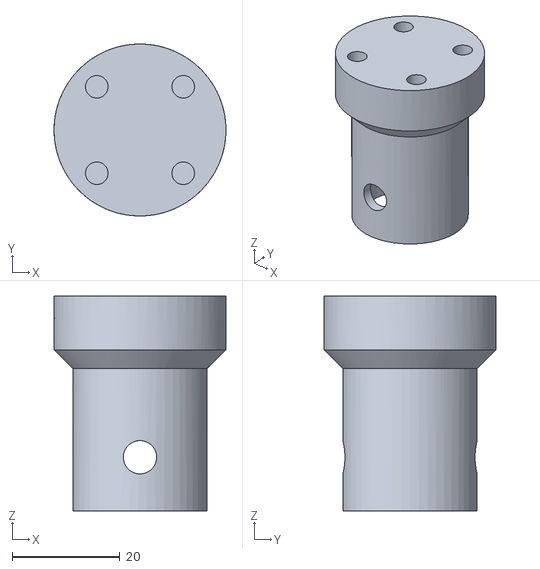
[picture p139: CAD file, 2023-08-29]
Mechanical/SBW - upper/STL/coupler.STL
32.0 x 32.0 x 40.0
