mlab-upenn/gokart-mechatronics/Mechanical/Battery Mount/Tslot2.SLDPRT

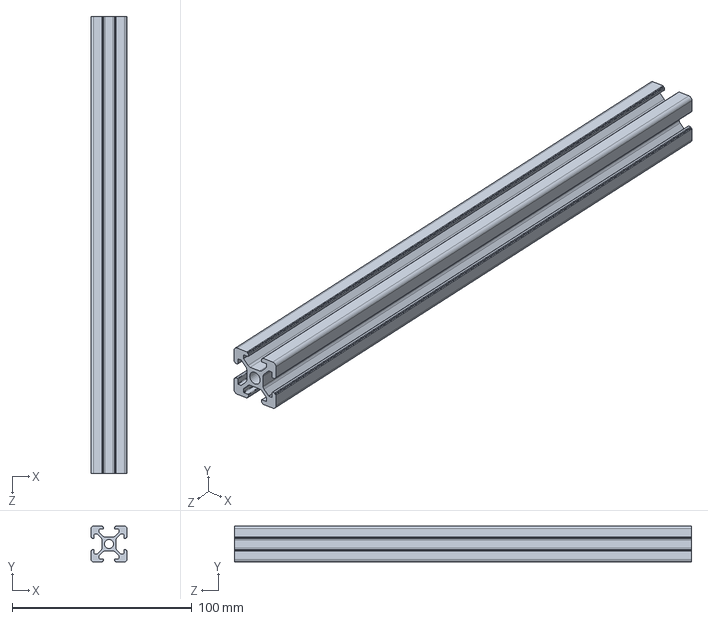
[picture p140: CAD file, 2024-02-22]
Mechanical/Battery Mount/Tslot2.SLDPRT
20.0 x 20.0 x 254.0 mm
