mlab-upenn/gokart-mechatronics/Mechanical/BBW controller mount/new pcb 50x70mm.SLDPRT

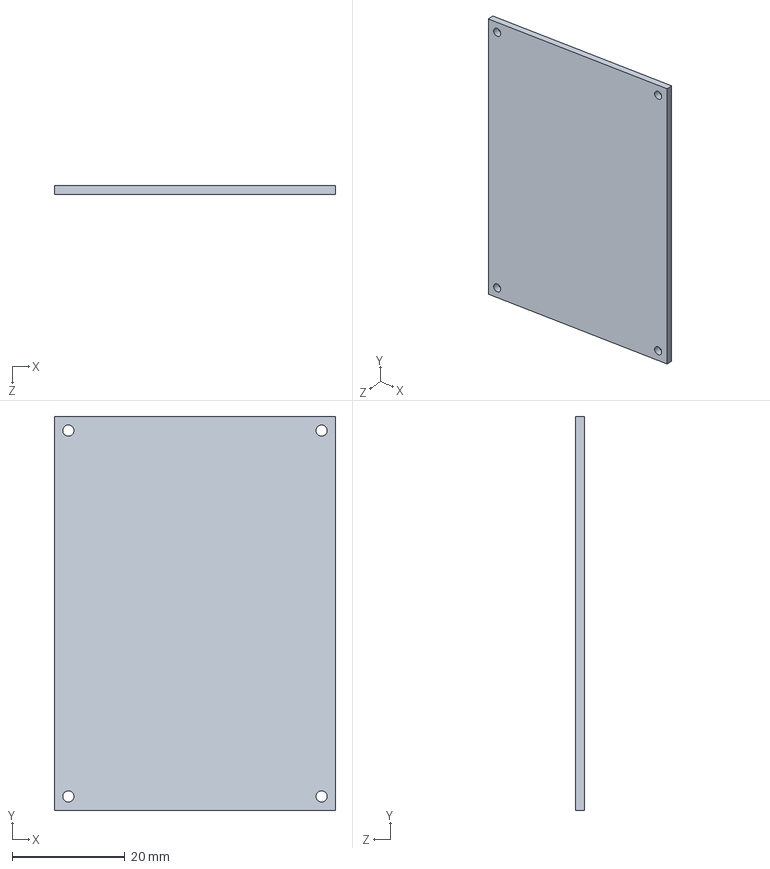
[picture p141: CAD file, 2023-08-09]
Mechanical/BBW controller mount/new pcb 50x70mm.SLDPRT
50.0 x 70.0 x 1.65 mm
