mlab-upenn/gokart-mechatronics/Mechanical/Eve_autonomy/Rect_Base_Top.SLDPRT

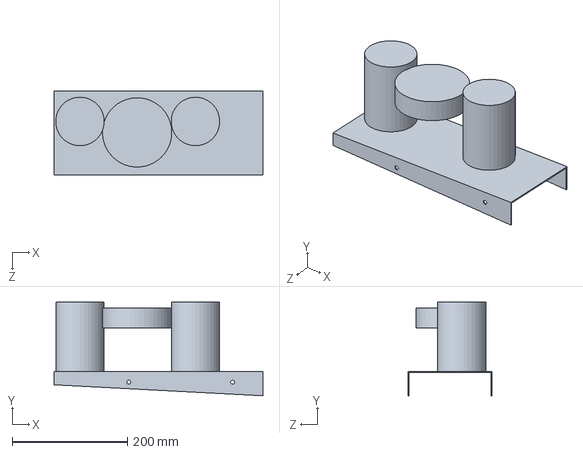
[picture p142: CAD file, 2024-02-15]
Mechanical/Eve_autonomy/Rect_Base_Top.SLDPRT
362.0 x 162.0 x 146.0 mm
