mlab-upenn/gokart-mechatronics/Mechanical/Rear Shelves/Rear Frame - Metal/T-slots/T-slot frame 171mm.SLDPRT

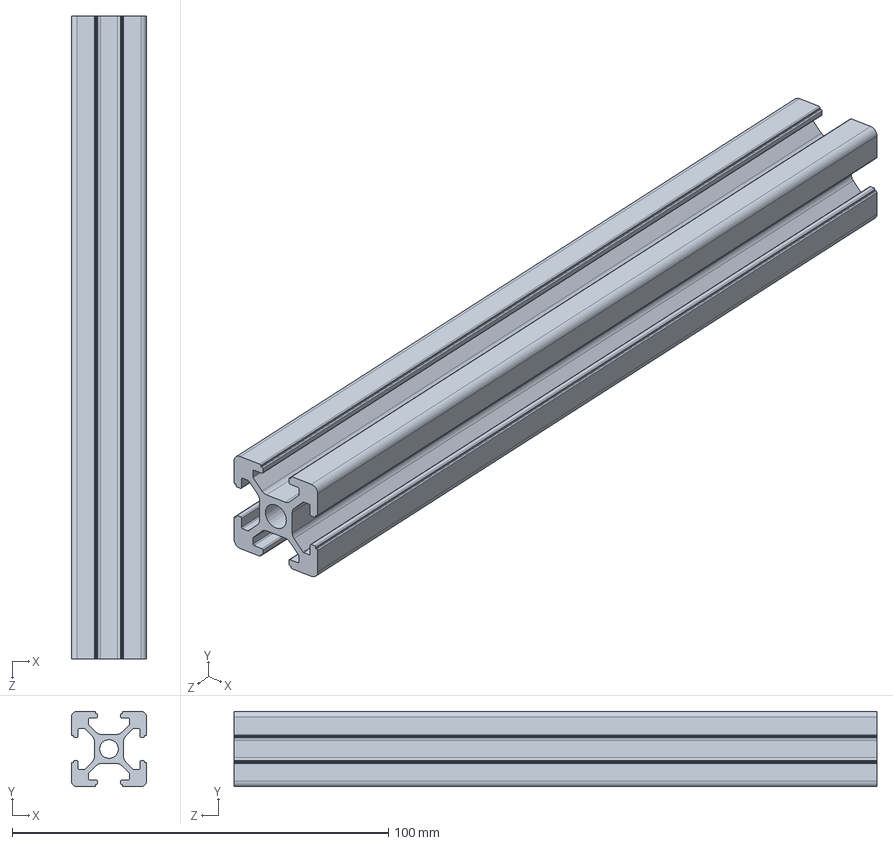
[picture p143: CAD file, 2023-07-20]
Mechanical/Rear Shelves/Rear Frame - Metal/T-slots/T-slot frame 171mm.SLDPRT
20.0 x 20.0 x 171.0 mm
