mlab-upenn/gokart-mechatronics/Mechanical/Rear Shelves/Rear Frame - Sensors and mounts/Ouster/1010C.STEP

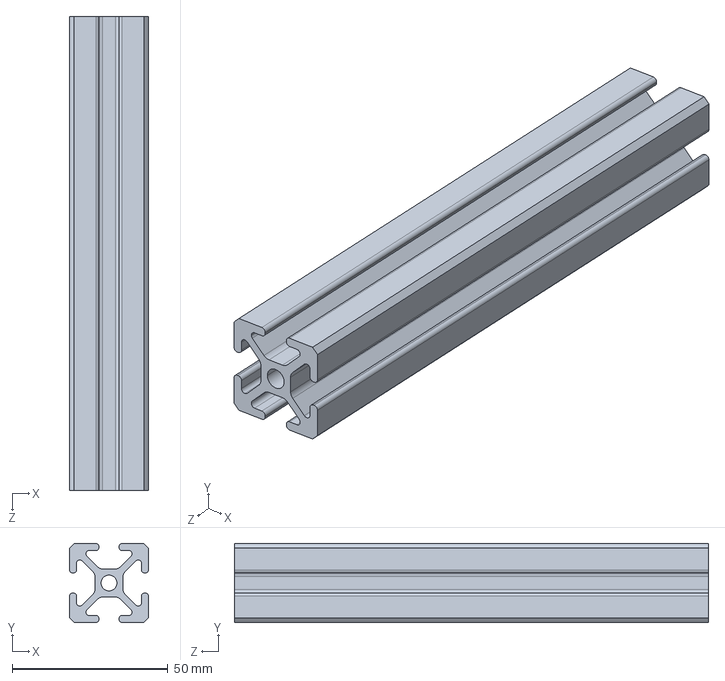
[picture p145: CAD file, 2023-04-25]
Mechanical/Rear Shelves/Rear Frame - Sensors and mounts/Ouster/1010C.STEP
25.4 x 25.4 x 152.4 mm
