mlab-upenn/gokart-mechatronics/Mechanical/SBW - lower/LSBW ASM/LSBW PCB.SLDPRT

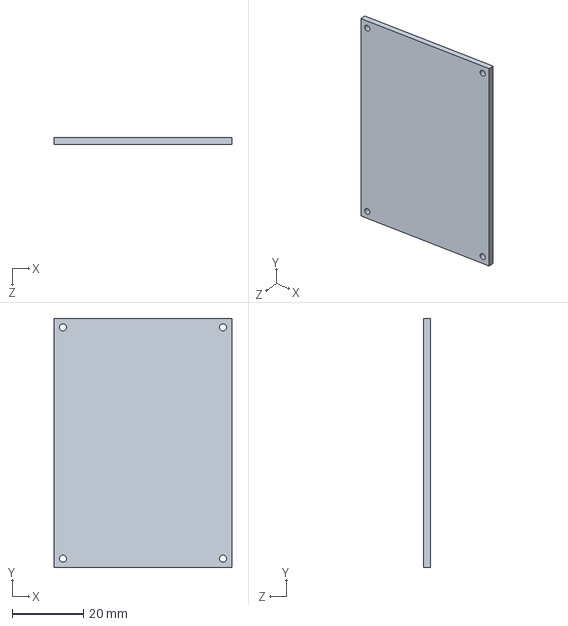
[picture p146: CAD file, 2023-08-09]
Mechanical/SBW - lower/LSBW ASM/LSBW PCB.SLDPRT
50.0 x 70.0 x 2.00 mm
