mlab-upenn/gokart-mechatronics/Mechanical/Battery Mount/Tslot3.SLDPRT

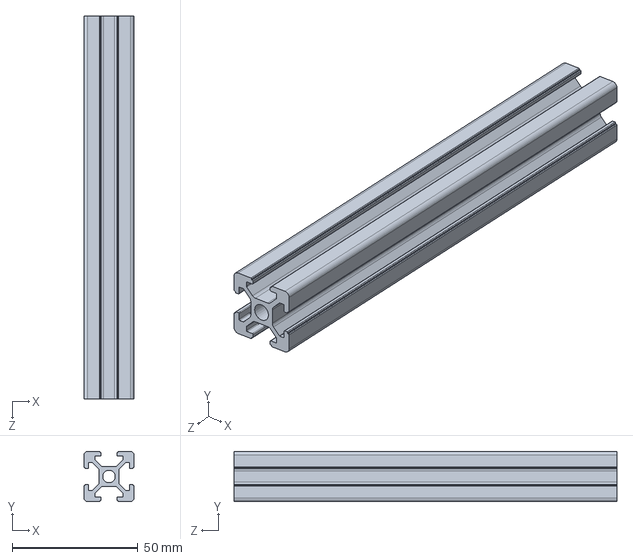
[picture p147: CAD file, 2024-02-22]
Mechanical/Battery Mount/Tslot3.SLDPRT
20.0 x 20.0 x 152.4 mm
