mlab-upenn/gokart-mechatronics/Mechanical/BBW controller mount/motor driver.SLDPRT

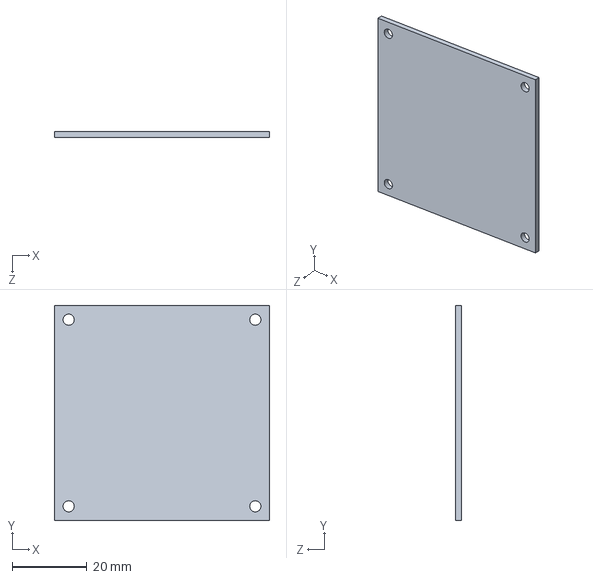
[picture p148: CAD file, 2023-08-09]
Mechanical/BBW controller mount/motor driver.SLDPRT
57.6 x 57.6 x 1.65 mm
