mlab-upenn/gokart-mechatronics/Mechanical/Eve_autonomy/Lidar_Plastic_Triangle.SLDPRT

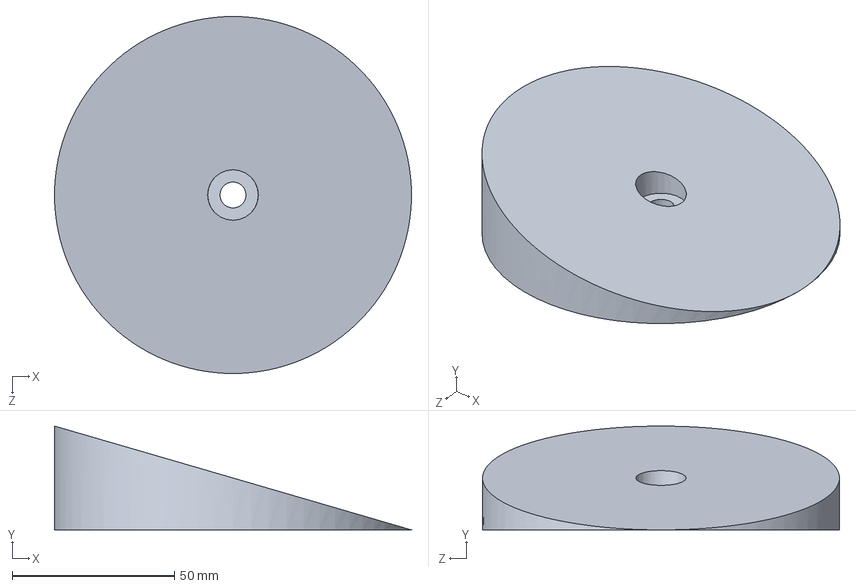
[picture p149: CAD file, 2024-02-08]
Mechanical/Eve_autonomy/Lidar_Plastic_Triangle.SLDPRT
110.0 x 32.0 x 110.0 mm
