mlab-upenn/gokart-mechatronics/Mechanical/Rear Shelves/Rear Frame - Metal/T-slots/T-slot frame 305mm.SLDPRT

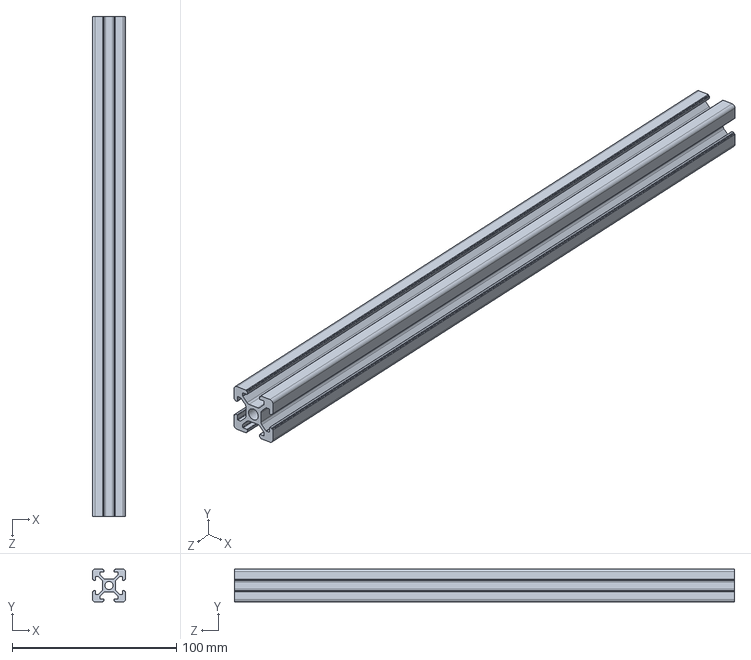
[picture p150: CAD file, 2023-07-20]
Mechanical/Rear Shelves/Rear Frame - Metal/T-slots/T-slot frame 305mm.SLDPRT
20.0 x 20.0 x 304.8 mm
