mlab-upenn/gokart-mechatronics/Mechanical/Rear Shelves/Rear Frame - Sensors and mounts/Antenna/Bullet 2hp Ubiquiti.STEP

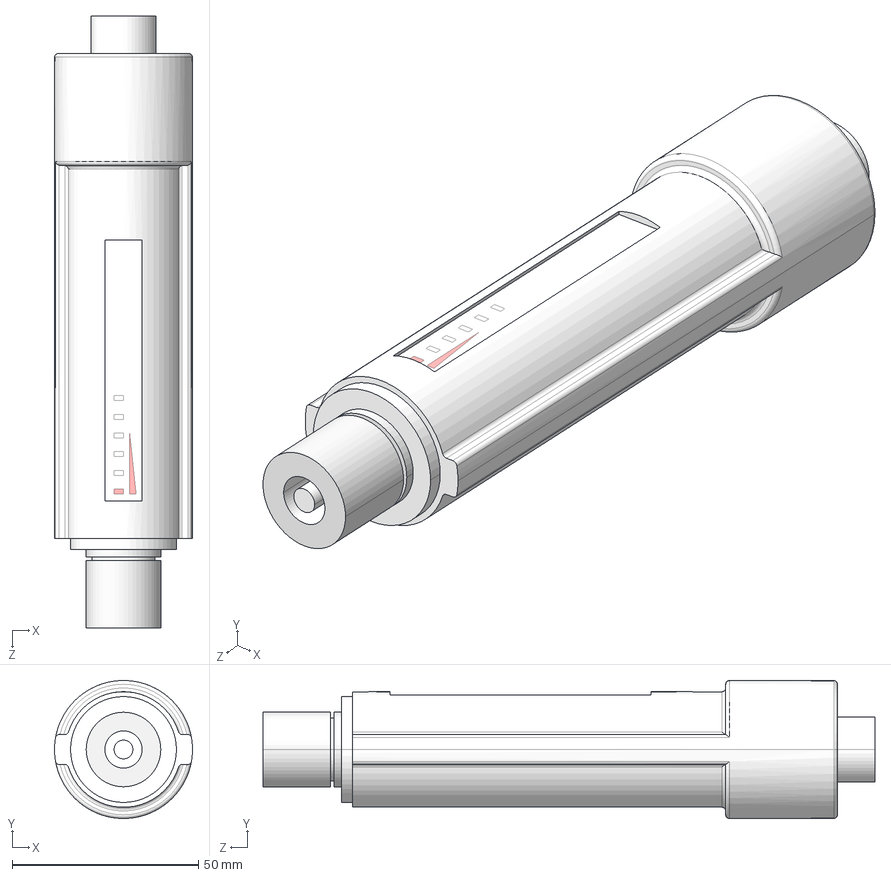
[picture p151: CAD file, 2023-06-22]
Mechanical/Rear Shelves/Rear Frame - Sensors and mounts/Antenna/Bullet 2hp Ubiquiti.STEP
37.0 x 37.0 x 164.0 mm
