mlab-upenn/gokart-mechatronics/Mechanical/Eve_autonomy/Lidar_Mounting_Assy_V1.SLDASM

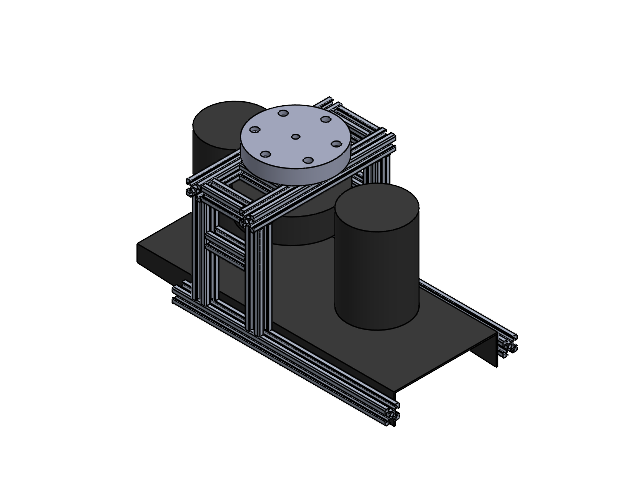
[picture p153: CAD file, 2024-02-26]
Mechanical/Eve_autonomy/Lidar_Mounting_Assy_V1.SLDASM
Rect_Base_Top
Tslot1 x 2
Tslot2 x 2
Tslot3 x 4
Tslot4 x 6
Lidar_Mount
M5_Screw
