mlab-upenn/gokart-mechatronics/Mechanical/Rear Shelves/Rear Frame - Sensors and mounts/RC Receiver/RC Receiver Assy.SLDASM

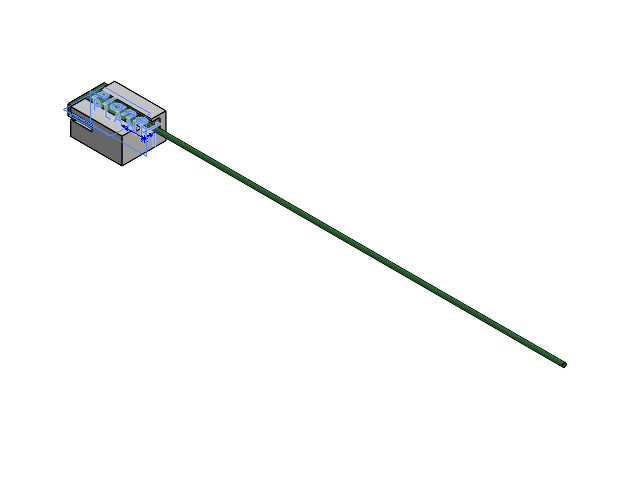
[picture p154: CAD file, 2023-08-22]
Mechanical/Rear Shelves/Rear Frame - Sensors and mounts/RC Receiver/RC Receiver Assy.SLDASM
RC Receiver Mount
RC Receiver
