mlab-upenn/gokart-mechatronics/Mechanical/Rear Shelves/Rear Shelves Assy V3.SLDASM

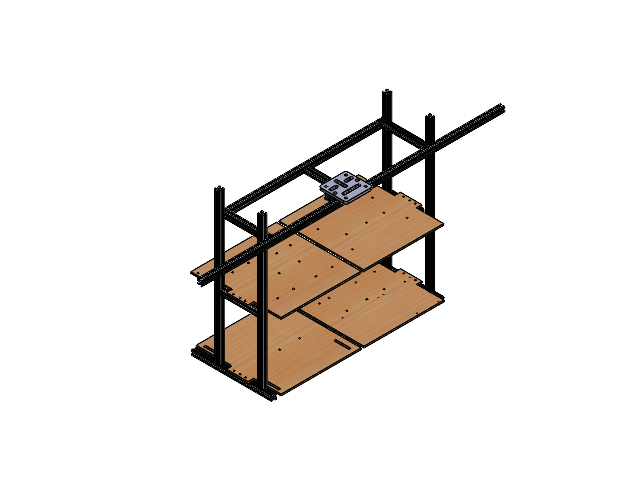
[picture p155: CAD file, 2023-07-21]
Mechanical/Rear Shelves/Rear Shelves Assy V3.SLDASM
T-slot frame 420mm x 2
T-slot frame 656mm x 2
T-slot frame 610mm x 4
Bottom plate left side V4
Bottom plate right side V4
T-slot frame 204mm x 2
Top Plate left side V1
Top Plate right side V1 dimension error
T-slot frame 1220mm
T-slot frame 190p86mm x 2
T-slot frame 616mm
T-slot frame 171mm
Alum_prof_resized_short x 2
Alum_prof_resized_shorter x 2
Old_Mount
