mlab-upenn/gokart-mechatronics/Mechanical/Rear Shelves/Rear Frame - Sensors and mounts/GNSS/GNSS_Assy.SLDASM

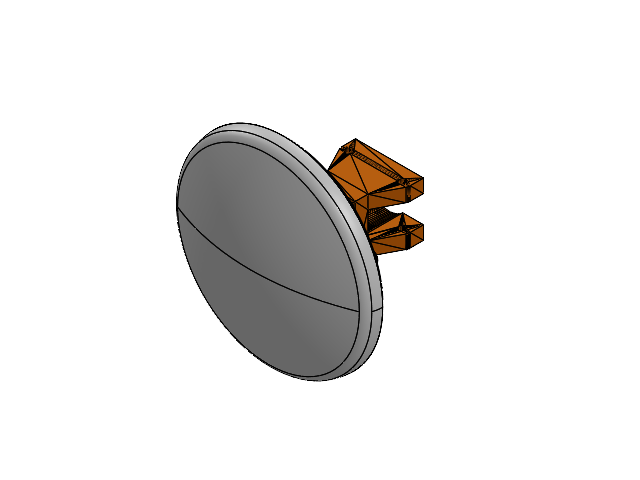
[picture p156: CAD file, 2023-08-22]
Mechanical/Rear Shelves/Rear Frame - Sensors and mounts/GNSS/GNSS_Assy.SLDASM
GNSS_mount_V2
GNSS
