mlab-upenn/gokart-mechatronics/Mechanical/BBW/Brake_rod_assy.SLDASM

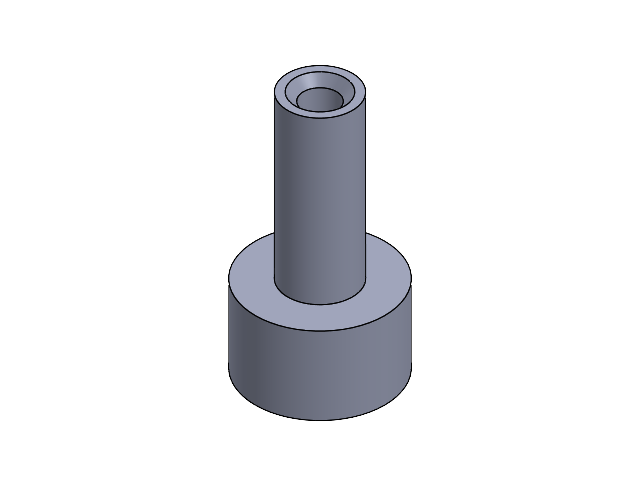
[picture p157: CAD file, 2023-08-28]
Mechanical/BBW/Brake_rod_assy.SLDASM
Brake_rod_extender
Brake_rod_locator
