mlab-upenn/gokart-mechatronics/Mechanical/Rear axle sensor/Rear_Sensor_Assy.SLDASM

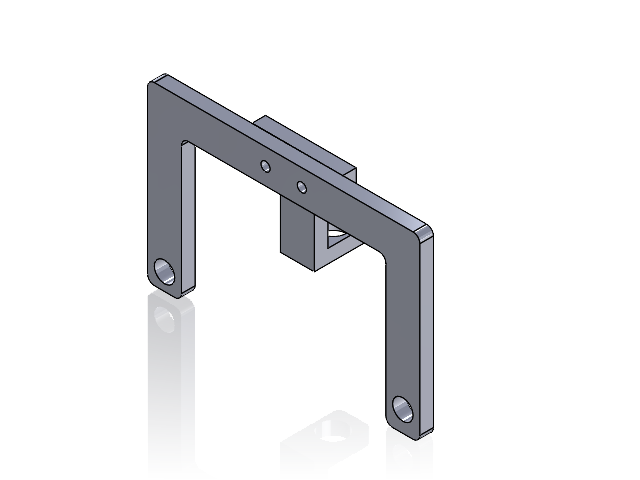
[picture p158: CAD file, 2023-08-17]
Mechanical/Rear axle sensor/Rear_Sensor_Assy.SLDASM
rear_sensor_mount
rear_sensor_holder
