mlab-upenn/gokart-mechatronics/Mechanical/SBW - lower/BLDC_Assy_LSBW.SLDASM

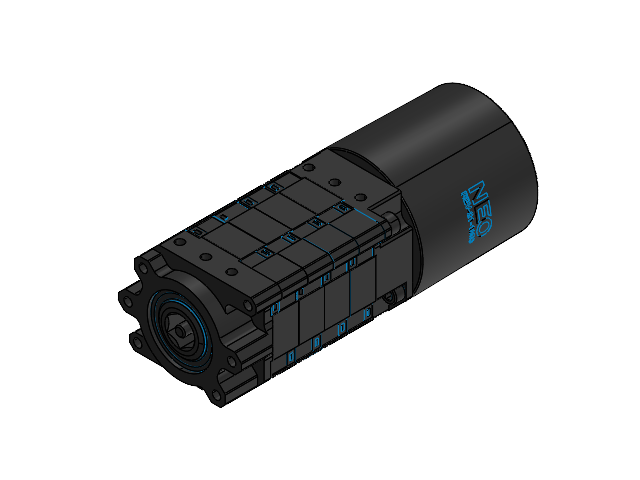
[picture p159: CAD file, 2023-09-13]
Mechanical/SBW - lower/BLDC_Assy_LSBW.SLDASM
BLDC_Front_Half
BLDC_Back_Half
