mlab-upenn/gokart-mechatronics/Mechanical/BBW controller mount/BBW controller mount asm.SLDASM

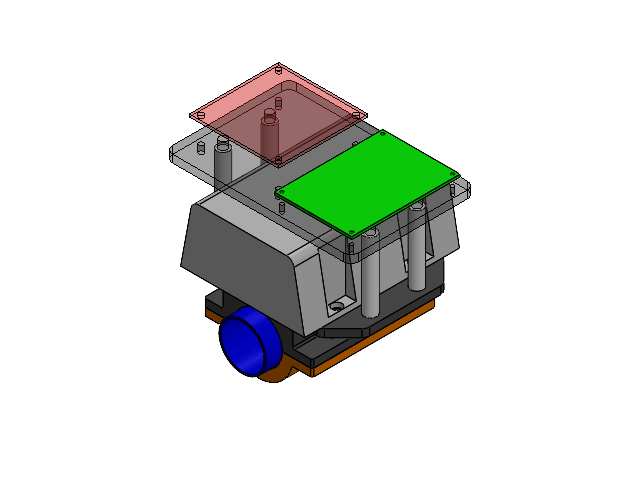
[picture p160: CAD file, 2023-08-09]
Mechanical/BBW controller mount/BBW controller mount asm.SLDASM
chassis frame
converter
upper clutch
lower clutch
M5x45mm standoff x 4
acrylic layer
new pcb 50x70mm
motor driver
