mlab-upenn/gokart-mechatronics/Mechanical/Rear Shelves/Rear Frame - MDF shelves/Plates_Assy_Testing_CAD.SLDASM

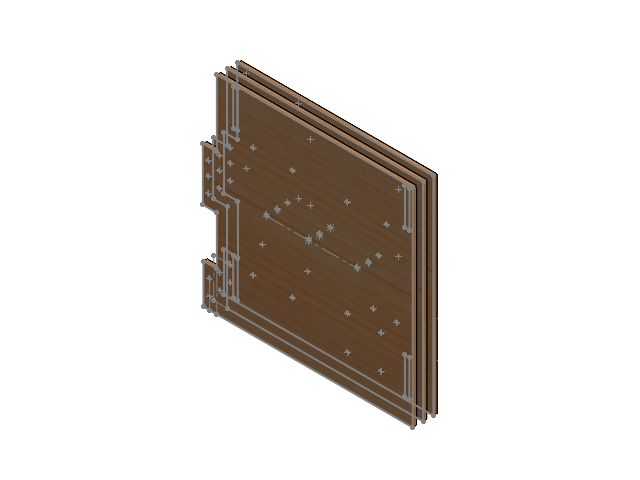
[picture p161: CAD file, 2023-07-20]
Mechanical/Rear Shelves/Rear Frame - MDF shelves/Plates_Assy_Testing_CAD.SLDASM
Top Plate right side V1 dimension error
Bottom plate right side V4 original
Bottom plate left side V4 for Testing new name
