mlab-upenn/gokart-mechatronics/Mechanical/Rear Shelves/Rear Frame - Sensors and mounts/Antenna/Antena_Mount_Assy.SLDASM

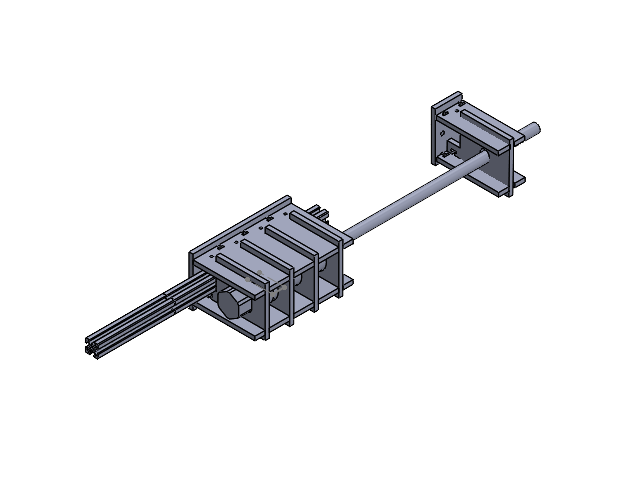
[picture p162: CAD file, 2023-06-22]
Mechanical/Rear Shelves/Rear Frame - Sensors and mounts/Antenna/Antena_Mount_Assy.SLDASM
Alum_prof_resized x 3
Antenna
Mount_Underneath
Mount_Circle_Pocket
Mount_Center_Pocket x 2
Mount_Vertical_Far
Mount_Vertical_Close_Outer x 2
Mount_Vertical_Close_Outer_Top x 2
Mount_Vertical_Far_Top
Mount_Top_Circle_Pocket
