mlab-upenn/gokart-mechatronics/Mechanical/SBW - lower/Pinned_Shaft.SLDASM

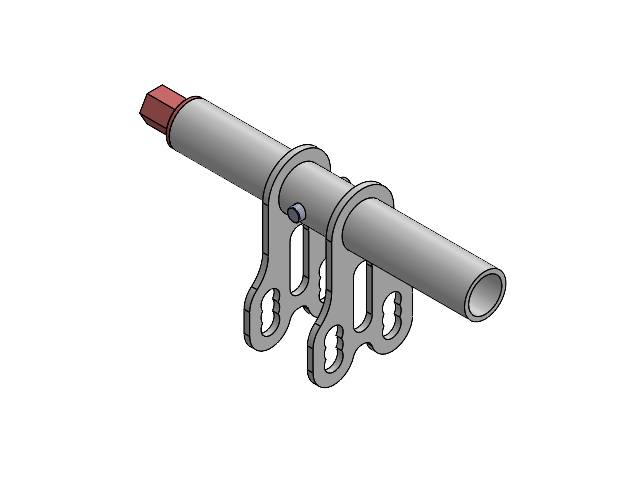
[picture p163: CAD file, 2023-09-13]
Mechanical/SBW - lower/Pinned_Shaft.SLDASM
steering shaft
tie_rod_turner x 2
hexagonal shaft
Hexagonal_shaft_pin
