mlab-upenn/gokart-mechatronics/Mechanical/SBW - lower/Rotating_Body.SLDASM

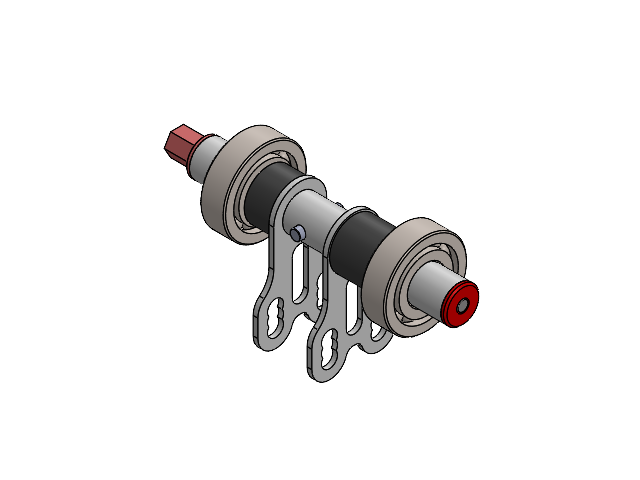
[picture p164: CAD file, 2023-09-11]
Mechanical/SBW - lower/Rotating_Body.SLDASM
steering shaft
tie_rod_turner x 2
hexagonal shaft
Hexagonal_shaft_pin
deep groove bearing 6204 x 2
sleeve back
sleeve front
AS5047P magnet
magnet mount
