mlab-upenn/gokart-mechatronics/Mechanical/SBW - lower/TopKart_Shaft.SLDASM

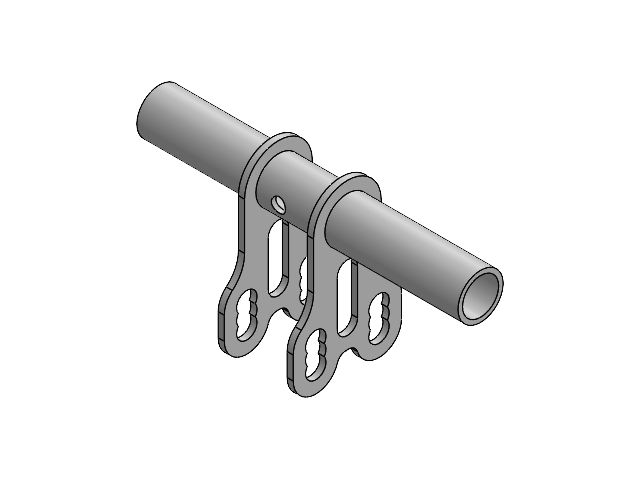
[picture p165: CAD file, 2023-08-31]
Mechanical/SBW - lower/TopKart_Shaft.SLDASM
steering shaft
tie_rod_turner x 2
