mlab-upenn/gokart-mechatronics/Mechanical/SBW - lower/L_pair.SLDASM

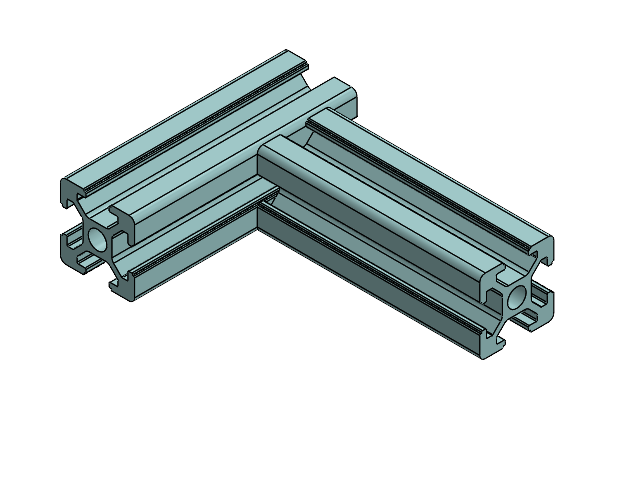
[picture p166: CAD file, 2023-08-29]
Mechanical/SBW - lower/L_pair.SLDASM
T-slot frame 60mm x 2
