mlab-upenn/gokart-mechatronics/(list of files, cad)

Other CAD files:
Mechanical/Rear Shelves/Rear Frame - MDF shelves/Top Plate Left Side V5.SLDPRT
Mechanical/Rear Shelves/Rear Frame - Sensors and mounts/GNSS/GNSS_mount_V2.STEP
Mechanical/Rear Shelves/Rear Frame - Sensors and mounts/RealSense/Mount TierIV_from_STP.SLDPRT
Mechanical/Battery Mount/floor sheet left.SLDPRT
Mechanical/BBW/BBW ASM/mid link.SLDPRT
Mechanical/Front LiDAR Driver Mount/Driver Mount.SLDPRT
Mechanical/Rear Shelves/Rear Frame - MDF shelves/Autonomy Kit shelves/Top Plate Left Side V7.SLDPRT
Mechanical/Rear Shelves/Rear Frame - MDF shelves/Bottom Plate Right Side V5.SLDPRT
Mechanical/Rear Shelves/Rear Frame - MDF shelves/Rear shelves top and bottom V1 - V4/Bottom plate left side V4.SLDPRT
Mechanical/Rear Shelves/Rear Frame - Sensors and mounts/RealSense/Mount TierIV.stp
Mechanical/Rear Shelves/Rear Frame - MDF shelves/Autonomy Kit shelves/Bottom Plate Left Side V7.SLDPRT
Mechanical/Rear Shelves/Rear Frame - MDF shelves/Bottom Plate Left Side V5.SLDPRT
Mechanical/Rear Shelves/Rear Frame - MDF shelves/Rear shelves top and bottom V1 - V4/Top Plate right side V1.SLDPRT
Mechanical/Rear Shelves/Rear Frame - Metal/T-slots/T-slot frame 656mm.SLDPRT
Mechanical/Rear Shelves/Rear Frame - Sensors and mounts/RealSense/Mount TierIV_from_STL.SLDPRT
Mechanical/Front LiDAR Driver Mount/Driver Mount V2 - Driver-1.STL
Mechanical/Rear Shelves/Rear Frame - MDF shelves/Rear shelves top and bottom V1 - V4/Top Plate left side V2.dwg
Mechanical/Rear Shelves/Rear Frame - MDF shelves/Top Plate Right Side V5.DWG
Mechanical/SBW - upper/USBW ASM/rounded spacer.SLDPRT
Mechanical/BBW/LA side mount.SLDPRT
Mechanical/SBW - upper/STL/shaft mount.STL
Mechanical/Eve_autonomy/Tslot3.SLDPRT
Mechanical/Rear Shelves/Rear Frame - MDF shelves/Autonomy Kit shelves/Top Plate Right Side V6.SLDPRT
Mechanical/Rear Shelves/Rear Frame - Metal/T-slots/Alum_prof_resized_short.SLDPRT
Mechanical/Rear Shelves/Rear Frame - Sensors and mounts/Ouster/Ouster_Mount_v3.STL
Mechanical/SBW - upper/USBW ASM/coupler.SLDPRT
Mechanical/BBW/BBW ASM/back link.SLDPRT
Mechanical/SBW - lower/sleeve front.SLDPRT
Mechanical/SBW - upper/USBW ASM/Pololu mount.SLDPRT
Mechanical/BBW/BBW ASM/sleeve 15mm.SLDPRT
Mechanical/SBW - lower/sleeve back.SLDPRT
Mechanical/BBW controller mount/DWG/acrylic layer.DWG
Mechanical/BBW controller mount/M5x45mm standoff.SLDPRT
Mechanical/BBW controller mount/STL/lower clutch.STL
Mechanical/BBW controller mount/STL/upper clutch.STL
Mechanical/BBW/BBW ASM/PA-14P.SLDPRT
Mechanical/BBW/BBW ASM/front link.SLDPRT
Mechanical/BBW/BBW ASM/mid link V2.SLDPRT
Mechanical/BBW/BBW V5 ASM.SLDASM
Mechanical/BBW/BBW V6 ASM.SLDASM
Mechanical/BBW/Engineering drawings/Brake_rod_extender.SLDDRW
Mechanical/BBW/Engineering drawings/LA side mount Drawing.SLDDRW
Mechanical/BBW/Engineering drawings/LA side mount.SLDDRW
Mechanical/BBW/Engineering drawings/LA steel frame.SLDDRW
Mechanical/BBW/Engineering drawings/Lever_arm_pin_drawing.SLDDRW
Mechanical/BBW/Engineering drawings/lever arm.SLDDRW
Mechanical/BBW/LA side mount - old.SLDPRT
Mechanical/BBW/LA side mount - plastic.SLDPRT
Mechanical/BBW/STL/LA side mount.STL
Mechanical/BBW/STL/sleeve 20mm.STL
Mechanical/BBW/STL/small plate.STL
Mechanical/BBW/chassis mount.SLDPRT
Mechanical/BBW/gantry.SLDPRT
Mechanical/BBW/mid link old.SLDPRT
Mechanical/BBW/motor block.SLDPRT
Mechanical/BBW/motor support 2.SLDPRT
Mechanical/BBW/new LA side mount - steel.SLDPRT
Mechanical/BBW/original clamp.SLDPRT
Mechanical/BBW/side chassis frame.SLDPRT
Mechanical/BBW/sleeve 20mm.SLDPRT
Mechanical/BBW/small plate.SLDPRT
Mechanical/BBW/thick U bolt.SLDPRT
Mechanical/Battery Mount/Battery_Box_Assy.SLDASM
Mechanical/Battery Mount/Tslot4.SLDPRT
Mechanical/Battery Mount/Tslot5.SLDPRT
Mechanical/Battery Mount/floor sheet left.SLDDRW
Mechanical/Battery Mount/floor sheet right.SLDDRW
Mechanical/Battery Mount/vertical sheet front and back.SLDDRW
Mechanical/Battery Mount/vertical sheet sides.SLDDRW
Mechanical/Eve_autonomy/Lidar_Mount.STL
Mechanical/Eve_autonomy/M5_Screw.SLDPRT
Mechanical/Front LiDAR Driver Mount/Driver Mount.STL
Mechanical/Rear Shelves/Rear Frame - MDF shelves/Autonomy Kit shelves/AutoKit_Blocker.DWG
Mechanical/Rear Shelves/Rear Frame - MDF shelves/Autonomy Kit shelves/Bottom Plate Left Side V6.DWG
Mechanical/Rear Shelves/Rear Frame - MDF shelves/Autonomy Kit shelves/Bottom Plate Left Side V6.SLDPRT
Mechanical/Rear Shelves/Rear Frame - MDF shelves/Autonomy Kit shelves/Bottom Plate Left Side V7.DWG
Mechanical/Rear Shelves/Rear Frame - MDF shelves/Autonomy Kit shelves/Top Plate AutoKit V6.DWG
Mechanical/Rear Shelves/Rear Frame - MDF shelves/Autonomy Kit shelves/Top Plate Left Side V6.DWG
Mechanical/Rear Shelves/Rear Frame - MDF shelves/Autonomy Kit shelves/Top Plate Left Side V6.SLDPRT
Mechanical/Rear Shelves/Rear Frame - MDF shelves/Autonomy Kit shelves/Top Plate Left Side V7.DWG
Mechanical/Rear Shelves/Rear Frame - MDF shelves/Bottom Plate Left Side V5.DWG
Mechanical/Rear Shelves/Rear Frame - MDF shelves/Bottom Plate Right Side V5.DWG
Mechanical/Rear Shelves/Rear Frame - MDF shelves/Rear shelves top and bottom V1 - V4/Bottom Plate left side V3.dwg
Mechanical/Rear Shelves/Rear Frame - MDF shelves/Rear shelves top and bottom V1 - V4/Bottom Plate left side V4.dwg
Mechanical/Rear Shelves/Rear Frame - MDF shelves/Rear shelves top and bottom V1 - V4/Bottom Plate right side V2.dwg
Mechanical/Rear Shelves/Rear Frame - MDF shelves/Rear shelves top and bottom V1 - V4/Bottom Plate right side V4.dwg
Mechanical/Rear Shelves/Rear Frame - MDF shelves/Rear shelves top and bottom V1 - V4/Left Board.SLDDRW
Mechanical/Rear Shelves/Rear Frame - MDF shelves/Rear shelves top and bottom V1 - V4/Right Board.SLDDRW
Mechanical/Rear Shelves/Rear Frame - MDF shelves/Rear shelves top and bottom V1 - V4/Top Plate left side V1.dwg
Mechanical/Rear Shelves/Rear Frame - MDF shelves/Rear shelves top and bottom V1 - V4/Top Plate right side V1.dwg
Mechanical/Rear Shelves/Rear Frame - MDF shelves/Top Plate Left Side V4.DWG
Mechanical/Rear Shelves/Rear Frame - MDF shelves/Top Plate Left Side V4.SLDPRT
Mechanical/Rear Shelves/Rear Frame - MDF shelves/Top Plate Left Side V5.DWG
Mechanical/Rear Shelves/Rear Frame - Metal/M5_Hex_Screw_Resized.SLDPRT
Mechanical/Rear Shelves/Rear Frame - Metal/T-slots/Alum_prof_resized_shorter.SLDPRT
Mechanical/Rear Shelves/Rear Frame - Metal/T-slots/T-slot frame 1220mm.SLDPRT
Mechanical/Rear Shelves/Rear Frame - Metal/T-slots/T-slot frame 139mm.SLDPRT
Mechanical/Rear Shelves/Rear Frame - Metal/T-slots/T-slot frame 140mm.SLDPRT
Mechanical/Rear Shelves/Rear Frame - Metal/T-slots/T-slot frame 190p86mm.SLDPRT
Mechanical/Rear Shelves/Rear Frame - Metal/T-slots/T-slot frame 244mm.SLDPRT
Mechanical/Rear Shelves/Rear Frame - Metal/T-slots/T-slot frame 284mm.SLDPRT
Mechanical/Rear Shelves/Rear Frame - Metal/T-slots/T-slot frame 304mm.SLDPRT
Mechanical/Rear Shelves/Rear Frame - Metal/T-slots/T-slot frame 610mm.SLDPRT
Mechanical/Rear Shelves/Rear Frame - Metal/T-slots/T-slot frame 696mm.SLDPRT
Mechanical/Rear Shelves/Rear Frame - Sensors and mounts/Antenna/Alum_prof_resized.SLDPRT
Mechanical/Rear Shelves/Rear Frame - Sensors and mounts/Antenna/Antenna_failed_first_attempt.SLDPRT
Mechanical/Rear Shelves/Rear Frame - Sensors and mounts/Antenna/Corner.SLDPRT
Mechanical/Rear Shelves/Rear Frame - Sensors and mounts/Antenna/Derek antenna mount/antenna mount.STL
Mechanical/Rear Shelves/Rear Frame - Sensors and mounts/Antenna/Mount_Center_Pocket.DXF
Mechanical/Rear Shelves/Rear Frame - Sensors and mounts/Antenna/Mount_Center_Pocket_v2.DXF
Mechanical/Rear Shelves/Rear Frame - Sensors and mounts/Antenna/Mount_Center_Pocket_v2.SLDPRT
Mechanical/Rear Shelves/Rear Frame - Sensors and mounts/Antenna/Mount_Circle_Pocket.DXF
Mechanical/Rear Shelves/Rear Frame - Sensors and mounts/Antenna/Mount_Circle_Pocket.SLDPRT
Mechanical/Rear Shelves/Rear Frame - Sensors and mounts/Antenna/Mount_Circle_Pocket_v2.DXF
Mechanical/Rear Shelves/Rear Frame - Sensors and mounts/Antenna/Mount_Top_Circle_Pocket.DXF
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
