mlab-upenn/gokart-mechatronics/Mechanical/Battery Mount/floor sheet left.pdf

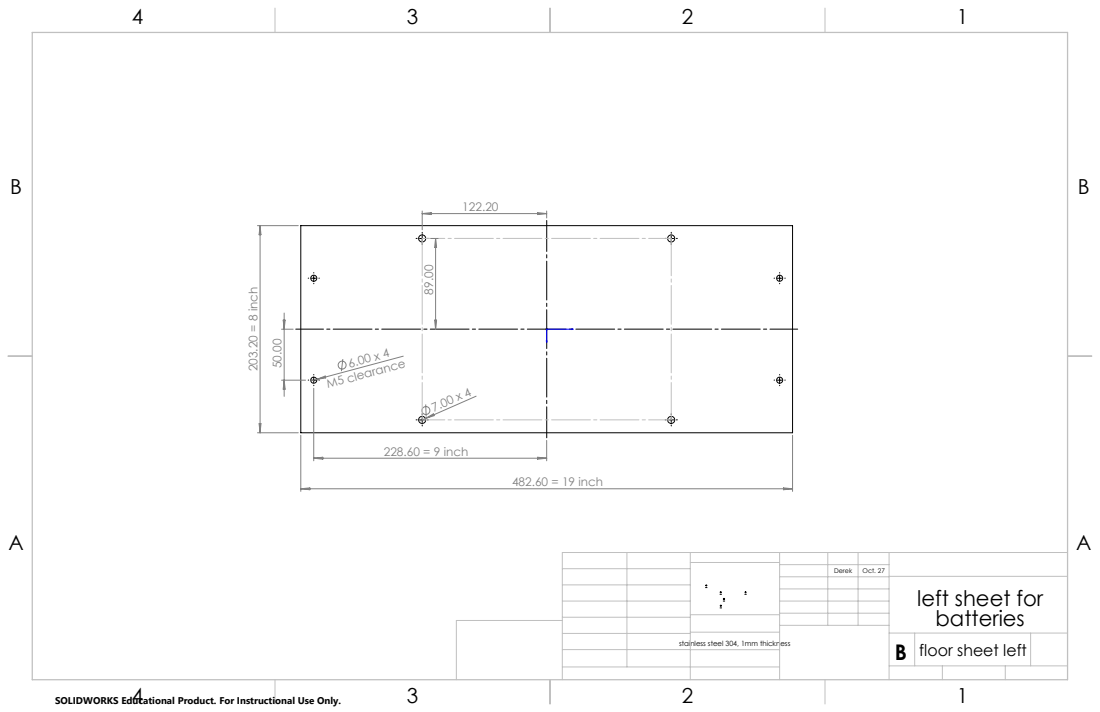
[picture p167: page 1]
6.00 x 4 M5 clearance; 228.60 = 9 inch; 203.20 = 8 inch; 482.60 = 19 inch; stainless steel 304, 1mm thickness; Derek; Oct. 27

left sheet for
batteries
floor sheet left

SOLIDWORKS Educational Product. For Instructional Use Only.
