mlab-upenn/gokart-mechatronics/Mechanical/Battery Mount/floor sheet right.pdf

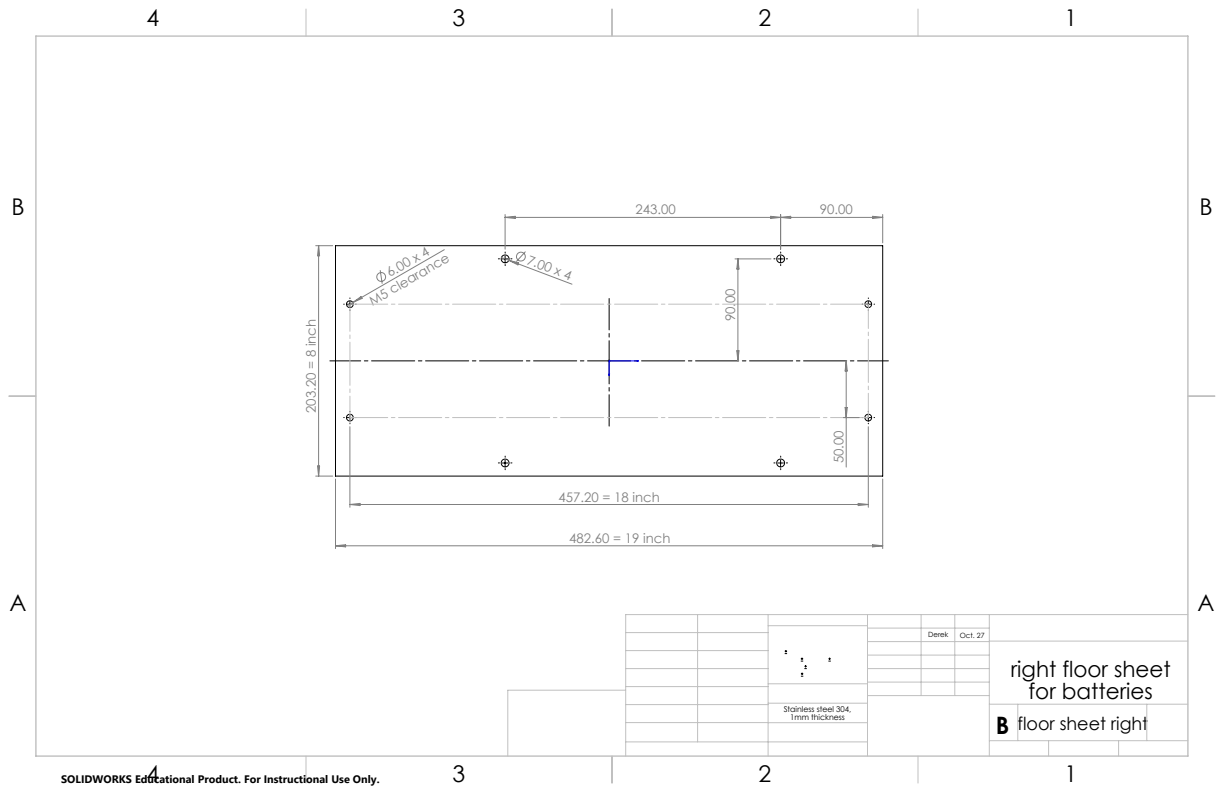
[picture p168: page 1]
457.20 = 18 inch; 482.60 = 19 inch; 203.20 = 8 inch; 6.00 x 4 M5 clearance; Stainless steel 304,; 1mm thickness; Derek; Oct. 27

right floor sheet
for batteries
floor sheet right

SOLIDWORKS Educational Product. For Instructional Use Only.
