mlab-upenn/gokart-mechatronics/Mechanical/Battery Mount/vertical sheet sides.pdf

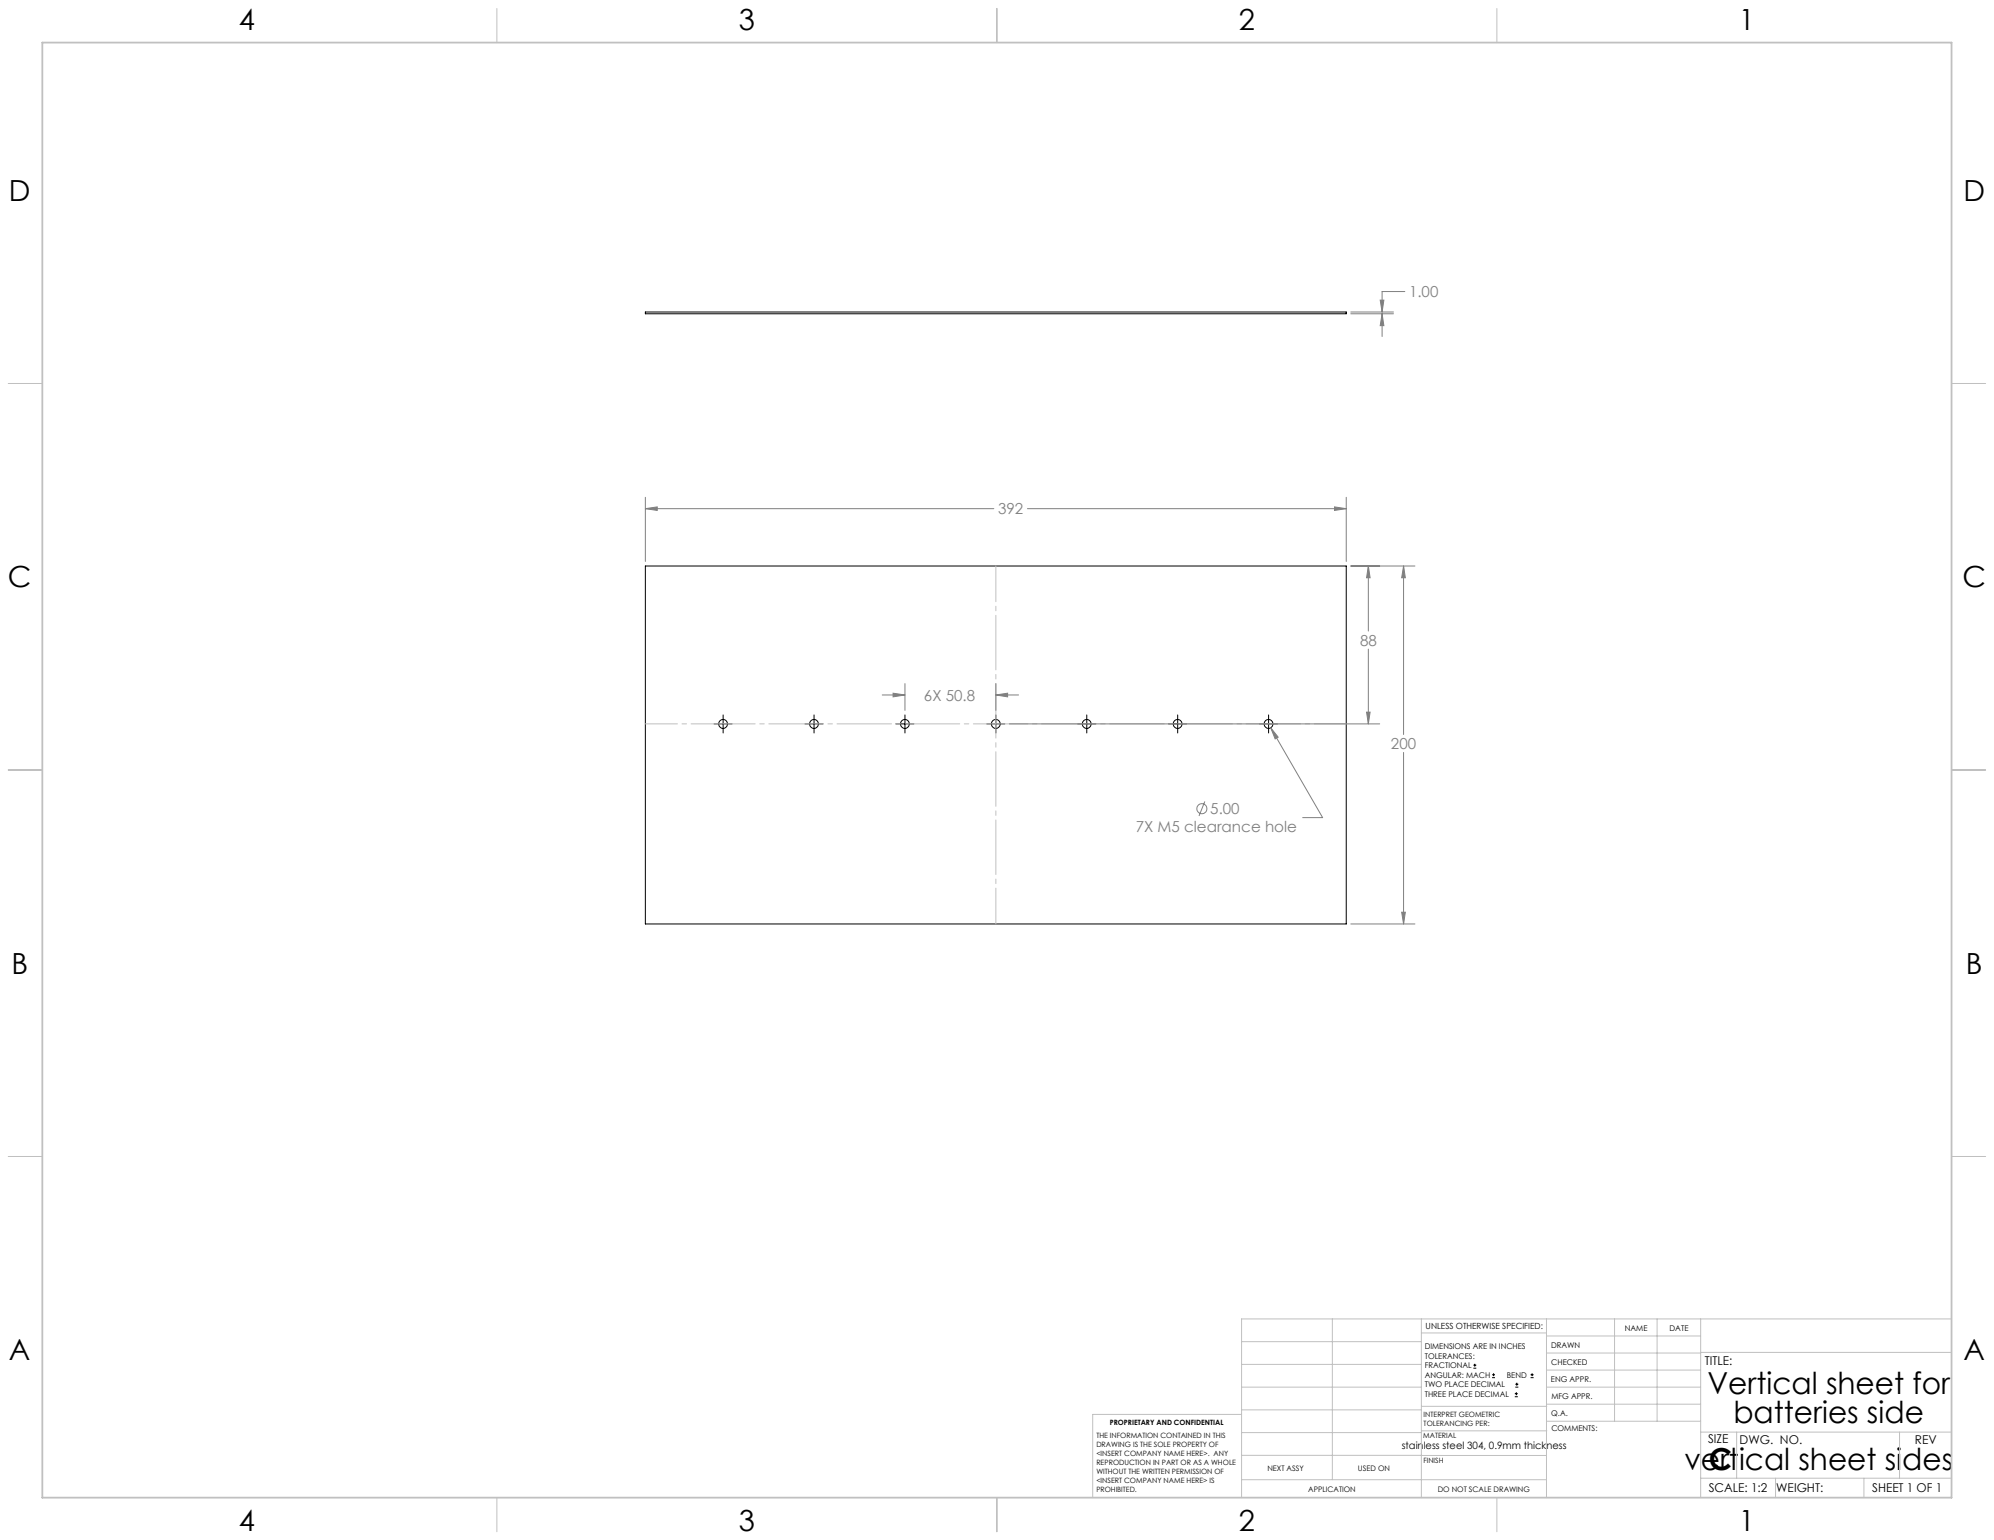
[picture p170: page 1]
7X M5 clearance hole; vertical sheet sides; DWG. NO.; REV

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

CHECKED | | | TITLE: Vertical sheet for batteries side

ENG APPR.
MFG APPR.

INTERPRET GEOMETRIC TOLERANCING PER: | Q.A.

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

MATERIAL
stainless steel 304, 0.9mm thickness

NEXT ASSY | USED ON | FINISH

APPLICATION | DO NOT SCALE DRAWING | | SCALE: 1:2 | WEIGHT: | SHEET 1 OF 1
