mlab-upenn/gokart-mechatronics/Mechanical/BBW/TD 1.0 - Chassis frame and chassis main parts.pdf

1 2

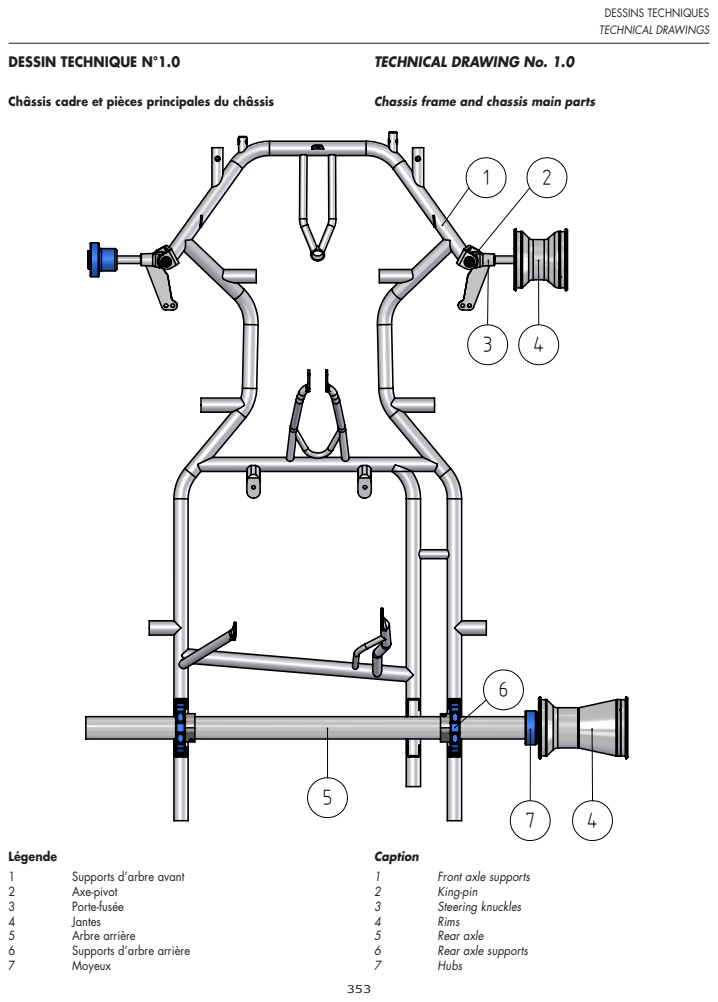
[picture p171: page 1]
DESSINS TECHNIQUES TECHNICAL DRAWINGS; Caption; Front axle supports; King-pin; Steering knuckles; Rims; Rear axle; Rear axle supports; Hubs; Légende; Supports d’arbre avant; Axe-pivot; Porte-fusée; Jantes; Arbre arrière; Supports d’arbre arrière; Moyeux; DESSIN TECHNIQUE N°1.0

TECHNICAL DRAWING No. 1.0

Châssis cadre et pièces principales du châssis

Chassis frame and chassis main parts
