mlab-upenn/gokart-mechatronics/Mechanical/SBW - lower/Drawings/LSBW motor mount.pdf

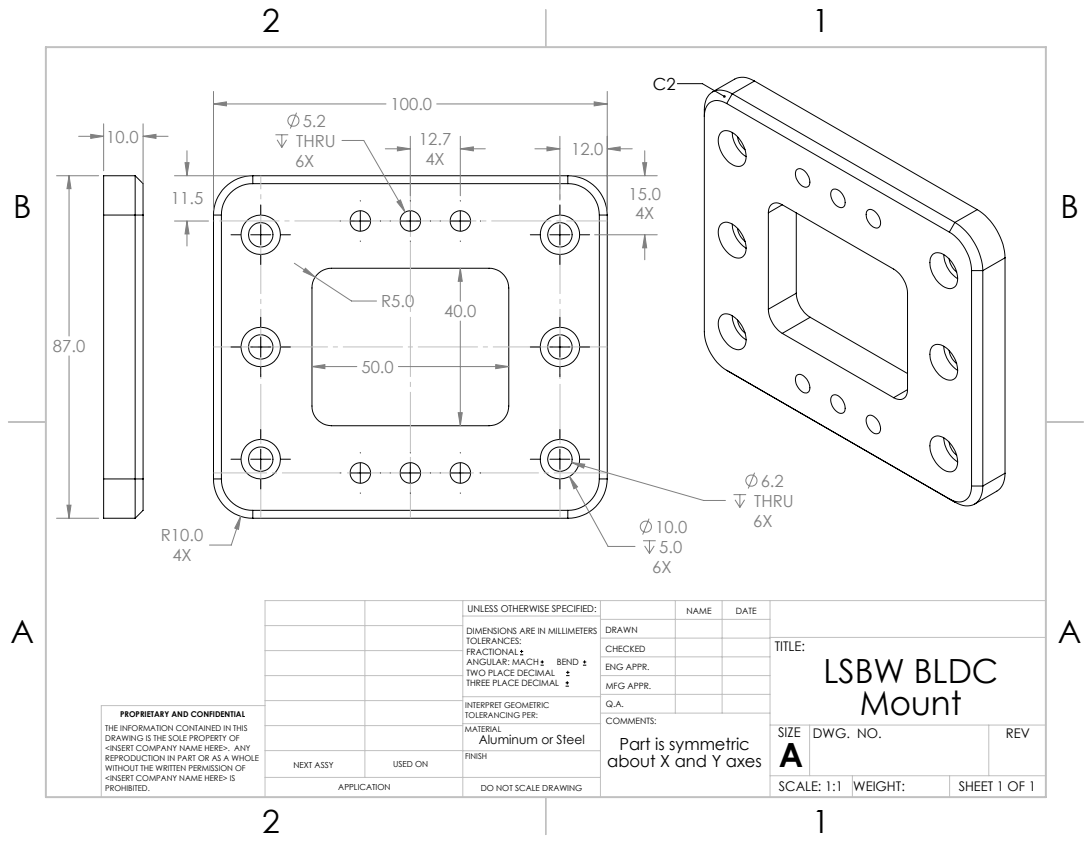
[picture p172: page 1]

UNLESS OTHERWISE SPECIFIED: | | NAME | DATE
DIMENSIONS ARE IN MILLIMETERS TOLERANCES: FRACTIONAL ANGULAR: MACH BEND TWO PLACE DECIMAL THREE PLACE DECIMAL | DRAWN

CHECKED | | | TITLE: LSBW BLDC Mount

ENG APPR.
MFG APPR.

INTERPRET GEOMETRIC TOLERANCING PER: | Q.A.
MATERIAL Aluminum or Steel | | SIZE A | DWG. NO. | REV

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

COMMENTS:
Part is symmetric
about X and Y axes

NEXT ASSY | USED ON | FINISH

APPLICATION | DO NOT SCALE DRAWING | | SCALE: 1:1 | WEIGHT: | SHEET 1 OF 1
