mlab-upenn/gokart-mechatronics/Mechanical/SBW - lower/Drawings/sleeve front.pdf

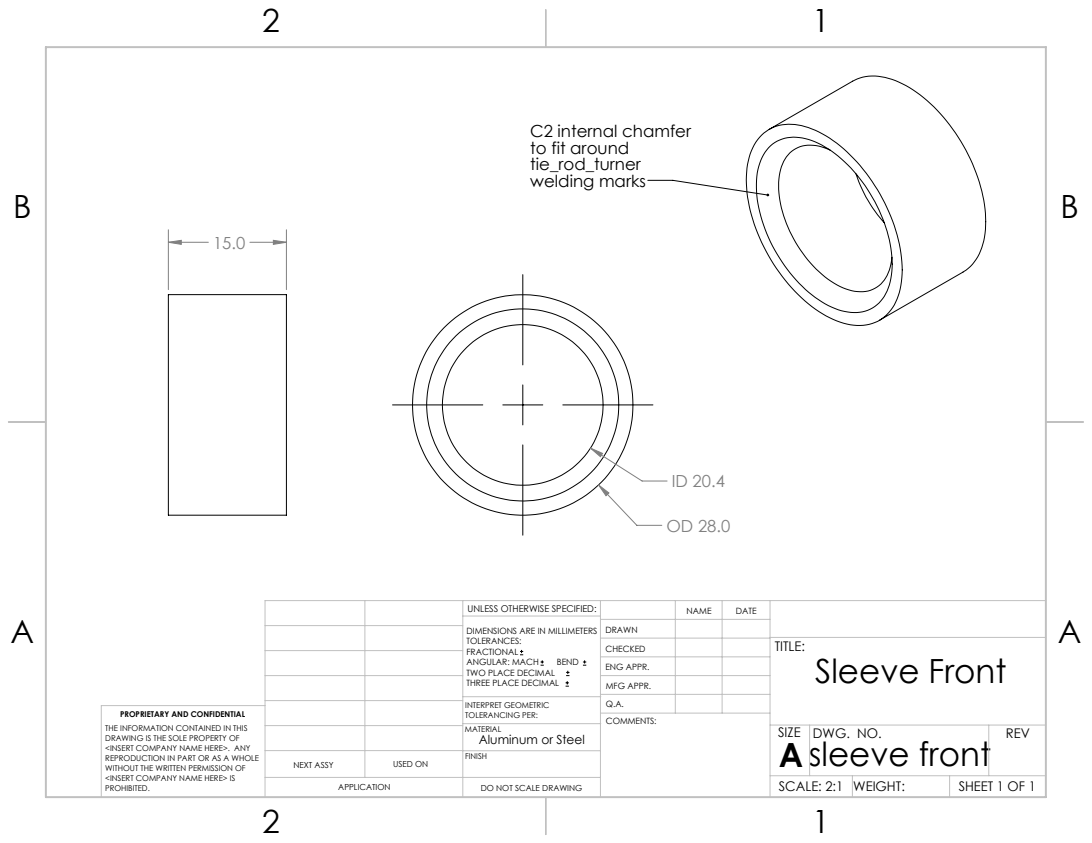
[picture p173: page 1]

C2 internal chamfer
to fit around
tie_rod_turner
welding marks

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

CHECKED | | | TITLE: Sleeve Front

ENG APPR.
MFG APPR.

INTERPRET GEOMETRIC TOLERANCING PER: | Q.A.
MATERIAL Aluminum or Steel | | SIZE A | DWG. NO. sleeve front | REV

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

NEXT ASSY | USED ON | FINISH

APPLICATION | DO NOT SCALE DRAWING | | SCALE: 2:1 | WEIGHT: | SHEET 1 OF 1
