mlab-upenn/gokart-mechatronics/Mechanical/SBW - lower/Drawings/hexagonal shaft.pdf

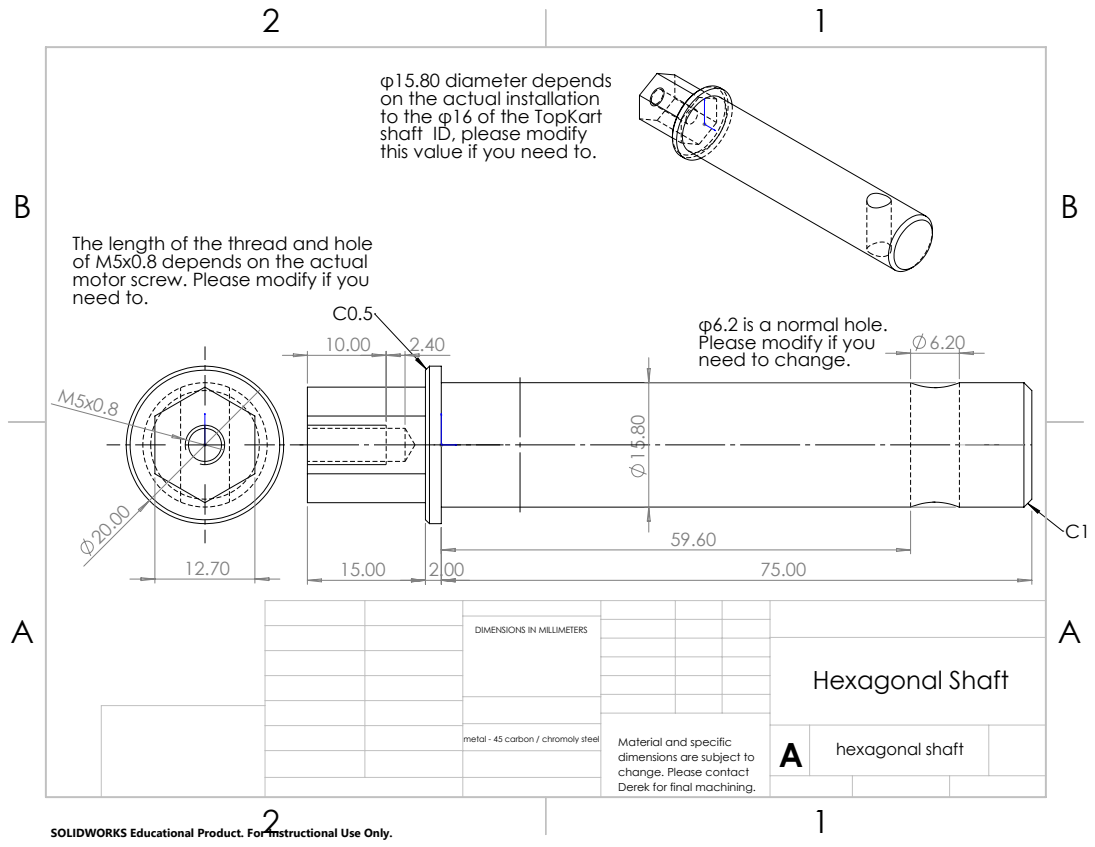
[picture p174: page 1]
A hexagonal shaft; Hexagonal Shaft

φ15.80 diameter depends
on the actual installation
to the φ16 of the TopKart
shaft ID, please modify
this value if you need to.

The length of the thread and hole
of M5x0.8 depends on the actual
motor screw. Please modify if you
need to.

φ6.2 is a normal hole.
Please modify if you
need to change.

DIMENSIONS IN MILLIMETERS

metal - 45 carbon / chromoly steel

Material and specific
dimensions are subject to
change. Please contact
Derek for final machining.

SOLIDWORKS Educational Product. For Instructional Use Only.
