mlab-upenn/gokart-mechatronics/Mechanical/BBW/Engineering drawings/LA side mount Drawing.pdf

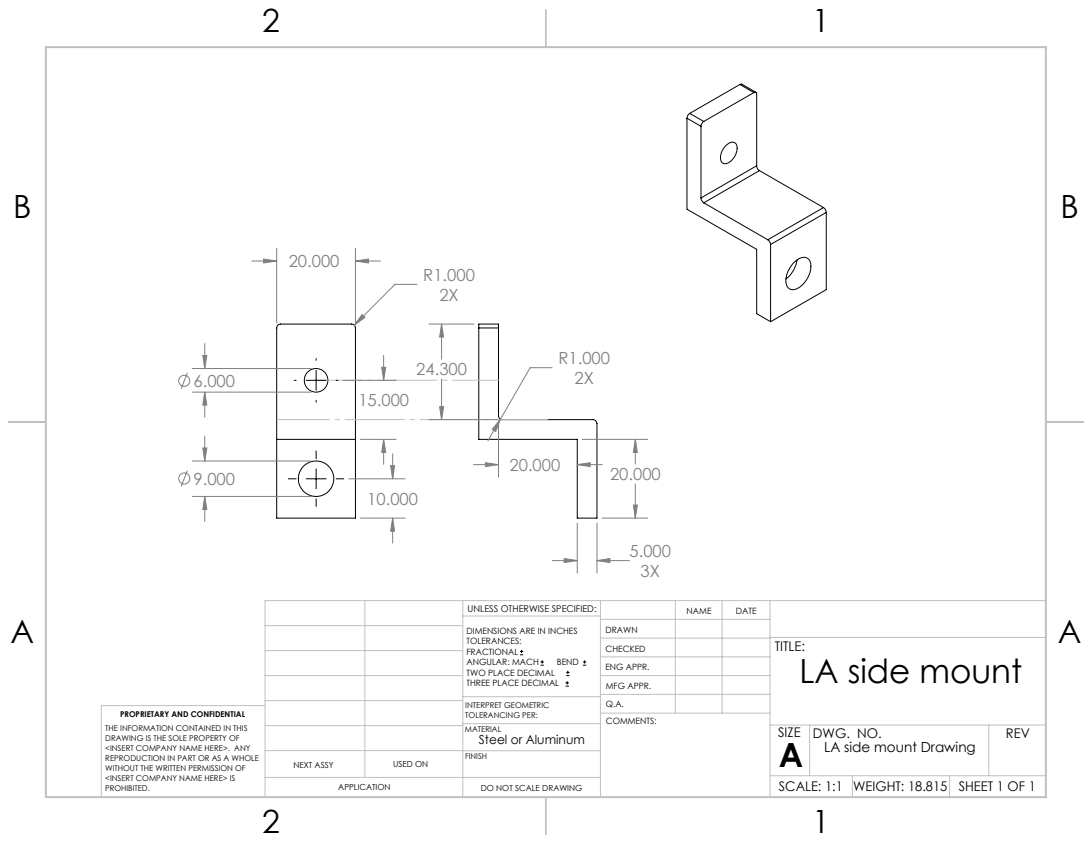
[picture p175: page 1]
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

CHECKED | | | TITLE: LA side mount

ENG APPR.
MFG APPR.

INTERPRET GEOMETRIC TOLERANCING PER: | Q.A.
MATERIAL Steel or Aluminum | | SIZE A | DWG. NO. LA side mount Drawing | REV

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

NEXT ASSY | USED ON | FINISH

APPLICATION | DO NOT SCALE DRAWING | | SCALE: 1:1 | WEIGHT: 18.815 | SHEET 1 OF 1
