mlab-upenn/gokart-mechatronics/Mechanical/BBW/Engineering drawings/LA steel frame Drawing.pdf

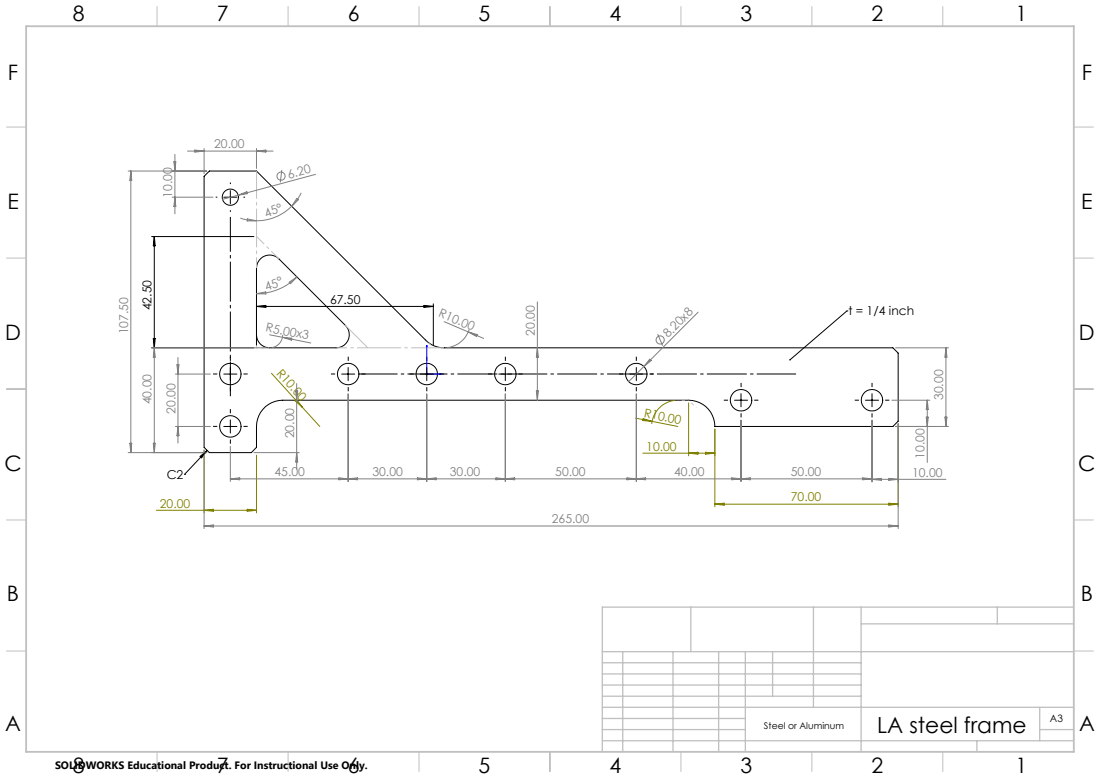
[picture p176: page 1]
t = 1/4 inch; Steel or Aluminum

SOLIDWORKS Educational Product. For Instructional Use Only.

LA steel frame
