mlab-upenn/gokart-mechatronics/Mechanical/BBW/Engineering drawings/Lever arm Drawing.pdf

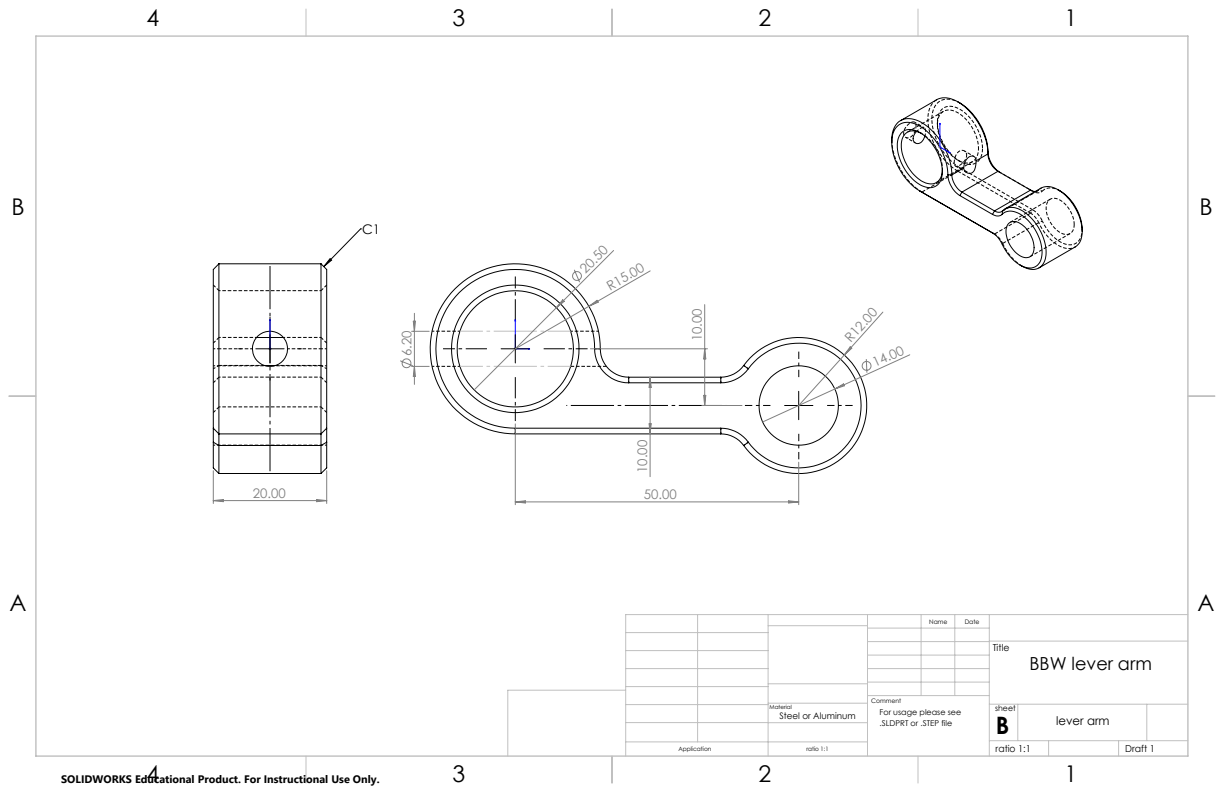
[picture p177: page 1]
Steel or Aluminum; ratio 1:1; Draft 1; lever arm; BBW lever arm

Comment
For usage please see
.SLDPRT or .STEP file

SOLIDWORKS Educational Product. For Instructional Use Only.
