mlab-upenn/gokart-mechatronics/(list of files, drawings)

Other design files:
Circuit Board/PCB Brake By Wire V4/Brake By Wire.PcbDoc
Circuit Board/PCB Brake By Wire V4/Brake By Wire.PrjPcb
Circuit Board/PCB Brake By Wire V4/Sheet1.SchDoc
Circuit Board/PCB Main Controller V4/Main Controller.PcbDoc
Circuit Board/PCB Main Controller V4/Main Controller.PrjPcb
Circuit Board/PCB Main Controller V4/Sheet1.SchDoc
Circuit Board/PCB Power Distribution V3/GoKart PDU_V3.PrjPcb
Circuit Board/PCB Power Distribution V3/PDU_Main.PcbDoc
Circuit Board/PCB Power Distribution V3/PDU_Schematic.SchDoc
Circuit Board/PCB Throttle By Wire V1/Sheet1.SchDoc
Circuit Board/PCB Throttle By Wire V1/Throttle By Wire.PcbDoc
Circuit Board/PCB Throttle By Wire V1/Throttle By Wire.PrjPcb
Circuit Board/PCB User Inteface V1/Sheet1.SchDoc
Circuit Board/PCB User Inteface V1/User Interface.PcbDoc
Circuit Board/PCB User Inteface V1/User Interface.PrjPcb
Mechanical/SBW - lower/Lower Steer By Wire/Lower Steer By Wire.PcbDoc
Mechanical/SBW - lower/Lower Steer By Wire/Lower Steer By Wire.PrjPcb
Mechanical/SBW - lower/Lower Steer By Wire/Sheet1.SchDoc
Mechanical/SBW - upper/Upper Steer By Wire/Sheet1.SchDoc
Mechanical/SBW - upper/Upper Steer By Wire/Upper Steer By Wire.PcbDoc
Mechanical/SBW - upper/Upper Steer By Wire/Upper Steer By Wire.PrjPcb
