mlab-upenn/gokart-mechatronics/STM32 Control/Nucleo-L432KC-BBW/Core/Src/main.c

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
/* Includes ------------------------------------------------------------------*/
#include "main.h"

/* USER CODE BEGIN Includes */

#include "stdio.h"

/* USER CODE END Includes */

ADC_HandleTypeDef hadc1;

CAN_HandleTypeDef hcan1;

TIM_HandleTypeDef htim1;
TIM_HandleTypeDef htim6;
TIM_HandleTypeDef htim7;
TIM_HandleTypeDef htim16;

UART_HandleTypeDef huart2;

void SystemClock_Config(void);
static void MX_GPIO_Init(void);
static void MX_USART2_UART_Init(void);
static void MX_CAN1_Init(void);
static void MX_TIM6_Init(void);
static void MX_TIM1_Init(void);
static void MX_ADC1_Init(void);
static void MX_TIM7_Init(void);
static void MX_TIM16_Init(void);
/* USER CODE BEGIN 0 */

CAN_TxHeaderTypeDef TxHeader;
CAN_RxHeaderTypeDef RxHeader;

uint32_t TxMailbox;

uint8_t CAN_TxData[4];
uint8_t CAN_RxData[4];

// important: don't convert to int or it will get reset to 0 for unknown reason
double first_met = 1.0;

double pressure_desired = 0.0;
double pressure_measured = 0.0;

double pressure_measured_avg = 0.0;
double pressure_measured_sum = 0.0;

// uart print to serial terminal for debugging purpose
int _write(int file, char *ptr, int len){
	HAL_UART_Transmit(&huart2, (uint8_t*)ptr, len, HAL_MAX_DELAY);
	return len;
}

void HAL_CAN_RxFifo0MsgPendingCallback(CAN_HandleTypeDef *hcan1)
{
  if (HAL_CAN_GetRxMessage(hcan1, CAN_RX_FIFO0, &RxHeader, CAN_RxData) != HAL_OK)
  {
    Error_Handler();
  }

  // 0x100 is the can device id of the main controller
  if ((RxHeader.StdId == 0x100))
  {
	  // first compute the brake percentage then the pressure needed
	  pressure_desired = CAN_RxData[1];
  }
}

void HAL_TIM_PeriodElapsedCallback(TIM_HandleTypeDef *htim) {
	// 100Hz = 10ms breaking linear actuator control loop
	if (htim == &htim6){
	  int brake_duty_cycle;
	  int max_duty_cycle = 400;

	  double pressure_error = pressure_measured_avg - pressure_desired;

	  // brake error very small
	  int error_met = pressure_error > -15.0 && pressure_error < 15.0;

	  // we want to first narrow down to a small range of error
	  // and then increase this bound to avoid oscillation
	  if (pressure_error > -7.5 && pressure_error < 7.5){
		  first_met = 1.0;
	  }

	  // if any conditions are met, lock the motor and cutoff power
	  if (error_met && first_met){
		  HAL_GPIO_WritePin(GPIOA, Motor1_Pin, GPIO_PIN_RESET);
		  HAL_GPIO_WritePin(GPIOA, Motor2_Pin, GPIO_PIN_RESET);
		  brake_duty_cycle = 0;
	  }
	  else{
		  first_met = 0.0;

		  // set the movement direction of the motor
		  if(pressure_error > 0.0){
			  HAL_GPIO_WritePin(GPIOA, Motor1_Pin, GPIO_PIN_RESET);
			  HAL_GPIO_WritePin(GPIOA, Motor2_Pin, GPIO_PIN_SET);
		  } else{
			  HAL_GPIO_WritePin(GPIOA, Motor1_Pin, GPIO_PIN_SET);
			  HAL_GPIO_WritePin(GPIOA, Motor2_Pin, GPIO_PIN_RESET);
		  }

		  // note that the backward force (loosing the brake) is much
		  // smaller than the forward force required (pushing the brake)
		  if(pressure_error > 0.0){
			  brake_duty_cycle = pressure_error * 10.0;
		  } else{
			  brake_duty_cycle = -pressure_error * 20.0;
		  }

		  if(brake_duty_cycle > max_duty_cycle){
			  brake_duty_cycle = max_duty_cycle;
		  }
	  }

	  // send out speed control pwm
	  TIM1->CCR1 = brake_duty_cycle;
	  HAL_TIM_PWM_Start(&htim1, TIM_CHANNEL_1);
  }

  // 100ms = 10Hz
  if (htim == &htim7){

  }

  // 5Hz = 200ms send out measured breaking pressure to can bus
  if (htim == &htim16){
	  CAN_TxData[0] = (int)(pressure_measured_avg);
	  HAL_CAN_AddTxMessage(&hcan1, &TxHeader, CAN_TxData, &TxMailbox);

	  printf("brake pressure measured: %.2f PSI \r\n", pressure_measured_avg);
	  printf("brake pressure desired: %.2f PSI \r\n", pressure_desired);
  }
}

/* USER CODE END 0 */

/**
  * @brief  The application entry point.
  * @retval int
  */
int main(void)
{
  /* MCU Configuration--------------------------------------------------------*/

  /* Reset of all peripherals, Initializes the Flash interface and the Systick. */
  HAL_Init();

  /* Configure the system clock */
  SystemClock_Config();

  /* Initialize all configured peripherals */
  MX_GPIO_Init();
  MX_USART2_UART_Init();
  MX_CAN1_Init();
  MX_TIM6_Init();
  MX_TIM1_Init();
  MX_ADC1_Init();
  MX_TIM7_Init();
  MX_TIM16_Init();
  /* USER CODE BEGIN 2 */

  // IMPORTANT: DO NOT MOVE THIS COUNTER TO GLOBAL VARIABLE
  // OR IT WILL BE RESET EVERY FEW LOOPS FOR NO REASON
  int count_max = 50;
  int pressure_count = 0;

  double pressure_voltage;
  double pressure_voltage_max = 5.0;
  double pressure_voltage_min = 1.0;

  double pressure_abs_max = 500.0;

  /* USER CODE END 2 */

  /* Infinite loop */
  /* USER CODE BEGIN WHILE */
  while (1)
  {
	  HAL_ADC_Start(&hadc1);
	  HAL_ADC_PollForConversion(&hadc1, HAL_MAX_DELAY);

	  // reference adc reading [0-4095], reference voltage [0-3.3v]
	  // however, empirical test show that 3.7v gives more accurate reading
	  pressure_voltage = HAL_ADC_GetValue(&hadc1) / 4095.0 * 3.7;
	  pressure_measured = (pressure_voltage - pressure_voltage_min) / (pressure_voltage_max - pressure_voltage_min) * pressure_abs_max;

	  // Throw out out of bound readings to reduce errors
	  if (pressure_measured > 0.0 && pressure_measured < pressure_abs_max){
		  pressure_measured_sum += pressure_measured;
		  pressure_count += 1;
	  }

	  if (pressure_count == count_max){
		  pressure_measured_avg = pressure_measured_sum / count_max;

		  if (pressure_measured_avg < 0){
			  pressure_measured_avg = 0;
		  }

		  pressure_count = 0;
		  pressure_measured_sum = 0.0;
	  }
  }
  /* USER CODE END WHILE */

}

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
