mlab-upenn/gokart-mechatronics/STM32 Control/Nucleo-F439ZI-Main/Src/main.c

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
/* Includes ------------------------------------------------------------------*/
#include "main.h"

/* USER CODE BEGIN Includes */
#include "app.h"
#include "uart_serial.h"

/* USER CODE END Includes */

/* USER CODE BEGIN PD */

void compute_auto_brake();

/* USER CODE END PD */

ADC_HandleTypeDef hadc1;

CAN_HandleTypeDef hcan1;

I2C_HandleTypeDef hi2c1;

TIM_HandleTypeDef htim1;
TIM_HandleTypeDef htim6;
TIM_HandleTypeDef htim7;
TIM_HandleTypeDef htim10;
TIM_HandleTypeDef htim11;

UART_HandleTypeDef huart2;
UART_HandleTypeDef huart3;
UART_HandleTypeDef huart6;

/* USER CODE BEGIN PV */
int gokart_mode = 0;
int motor_direction = 0;

float throttle_desired = 0.0;

float speed_measured = 0.0;
float speed_desired = 0.0;

float steer_desired = 0.0;
float steer_measured = 0.0;
float steer_max = 55.0;

float steering_wheel = 0.0;

float brake_desired = 0.0;
float brake_measured = 0.0;
float brake_max = 150.0;

app_state_t app;
app_state_t *main_app;

CAN_TxHeaderTypeDef TxHeader;
CAN_RxHeaderTypeDef RxHeader;

uint32_t TxMailbox;

uint8_t CAN_TxData[6];
uint8_t CAN_RxData[6];

//char UART_TxData[6];

/* USER CODE END PV */

void SystemClock_Config(void);
static void MX_GPIO_Init(void);
static void MX_USART3_UART_Init(void);
static void MX_USART2_UART_Init(void);
static void MX_TIM1_Init(void);
static void MX_CAN1_Init(void);
static void MX_ADC1_Init(void);
static void MX_USART6_UART_Init(void);
static void MX_TIM6_Init(void);
static void MX_I2C1_Init(void);
static void MX_TIM7_Init(void);
static void MX_TIM10_Init(void);
static void MX_TIM11_Init(void);
/* USER CODE BEGIN 0 */

int Debug_UART_Get_Byte() {
	if (__HAL_UART_GET_FLAG(&huart3, UART_FLAG_RXNE) == SET) {
		return (uint8_t) (huart3.Instance->DR & (uint8_t) 0x00FF);
	}
	return -1;
}

// This function merges array a, b, c into array d in sequence (no sort)
void mergearray(char a[], char b[], char c[], char d[], int arr1size, int arr2size, int arr3size)
{
    // resultant Array Size Declaration
    int i, j;

    // copying array 1 elements in to c array
    for (i = 0; i < arr1size; i++) {
    	d[i] = a[i];
    }

    // copying array 2 elements in to c array
    for (i = 0, j = arr1size;
         j < arr1size + arr2size && i < arr2size; i++, j++) {
        d[j] = b[i];
    }

    // copying array 3 elements in to c array
    for (i = 0, j = arr1size + arr2size;
         j < arr1size + arr2size + arr3size && i < arr3size; i++, j++) {
        d[j] = c[i];
    }
}

void send_gokart_info(float steer, float speed, int is_info){
	char data[6];
	char info_steer[13];
	char info_speed[13];
	char info_type[9];
	char info_out[35];

	sprintf(data, "%.2f", steer / 180.0 * 3.14);
	mergearray("steer ", data, " ", info_steer, 6, 6, 1);

	sprintf(data, "%.2f", speed);
	mergearray("speed ", data, " ", info_speed, 6, 6, 1);

	if (is_info == 0){
		mergearray("type ", "cmmd", "", info_type, 5, 4, 0);
	} else{
		mergearray("type ", "info", "", info_type, 5, 4, 0);
	}

	mergearray(info_steer, info_speed, info_type, info_out, 13, 13, 9);

	HAL_UART_Transmit(&huart6, info_out, sizeof(info_out), 10); // Sending in normal mode
}

void handle_remote_command(){
	float acc_percent = app.acc_percent;
	float gear_shift = app.gokart_status;
	float steer_percent = app.steer_percent;

	if(acc_percent > 0.00){
		throttle_desired = acc_percent * 100.0;
		brake_desired = 0.0;
	} else{
		throttle_desired = 0.0;
		brake_desired = -acc_percent * brake_max;
	}

	if (gear_shift == 0){
		motor_direction = 0;
	} else{
		motor_direction = 1;
	}

	steer_desired = steer_percent * steer_max;
}

void handle_autonomous_command(){
	uint8_t place_holder[10];
	sscanf(drive_msg, "%s %f %s %f", place_holder, &steer_desired, place_holder, &speed_desired);

	compute_auto_brake();
}

void handle_manual_command(){
	steer_desired = steering_wheel;
}

void compute_auto_brake(){
	float speed_error = speed_desired - speed_measured;

	if (speed_error < -1.5){
		brake_desired = (-speed_error - 1.5) * brake_max / 2;
	} else{
		brake_desired = 0.0;
	}
}

void cast_command(){
	if(steer_desired > steer_max){
		steer_desired = steer_max;
	} else if (steer_desired < -steer_max){
		steer_desired = -steer_max;
	}

	if (brake_desired > brake_max){
		brake_desired = brake_max;
	} else if (brake_desired < 0.0){
		brake_desired = 0.0;
	}

	if (throttle_desired > 100.0){
		throttle_desired = 100.0;
	} else if (throttle_desired < 0.0){
		throttle_desired = 0.0;
	}
}

void send_command(){
	// Send CANBus command
	CAN_TxData[0] = (int)(steer_desired + steer_max);
	CAN_TxData[1] = (int)(brake_desired);
	CAN_TxData[2] = (int)(throttle_desired);
	CAN_TxData[3] = (int)(motor_direction);

    HAL_CAN_AddTxMessage(&hcan1, &TxHeader, CAN_TxData, &TxMailbox);
}

void print_info(){
	if (gokart_mode == 0){
		printf("mode: remote \r\n");
	} else if (gokart_mode == 1){
		printf("mode: autonomous \r\n");
	} else if (gokart_mode == 2){
		printf("mode: manual \r\n");
	}

	if (motor_direction == 0){
		printf("motor_direction: reverse \r\n\n");
	} else{
		printf("motor_direction: forward \r\n");
	}

	printf("throttle desired %.2f \r\n\n", throttle_desired);
	printf("steer desired %.2f ", steer_desired);
	printf("steer measured %.2f \r\n", steer_measured);
	printf("brake desired %.2f ", brake_desired);
	printf("brake measured %.2f \r\n", brake_measured);
	printf("speed desired %.2f  ", speed_desired);
	printf("speed measured %.2f \r\n", speed_measured);
	printf("\r\n");
}

void HAL_CAN_RxFifo0MsgPendingCallback(CAN_HandleTypeDef *hcan1)
{
  if (HAL_CAN_GetRxMessage(hcan1, CAN_RX_FIFO0, &RxHeader, CAN_RxData) != HAL_OK)
  {
	  Error_Handler();
  }

  if (RxHeader.StdId == 0x101)
  {
	  speed_measured = CAN_RxData[0] / 10.0;
  }

  if (RxHeader.StdId == 0x102)
  {
	  brake_measured = CAN_RxData[0];
  }

  if (RxHeader.StdId == 0x103)
  {
	  steer_measured = CAN_RxData[0] - steer_max;
  }

  if (RxHeader.StdId == 0x104)
  {
	  steering_wheel = CAN_RxData[0] - steer_max;
  }
}

void HAL_TIM_PeriodElapsedCallback(TIM_HandleTypeDef *htim) {
	// 40Hz - 25ms handle gokart command and send to subsystems
	if (htim == &htim6) {
		gokart_mode = app.control_mode;

		if (gokart_mode == 0){
			handle_remote_command();
		} else if (gokart_mode == 1){
			handle_autonomous_command();
		} else if (gokart_mode == 2){
			handle_manual_command();
		}

		cast_command();
		send_command();
	}

	// 40Hz - 25ms send out gokart drive info to higher level device
	if (htim == &htim7){
		 // the current gokart drive state information
	     send_gokart_info(steer_measured, speed_measured, 1);
	}

	// 10Hz - 100ms send out gokart drive command to higher level device
	if(htim == &htim10){
	    send_gokart_info(steer_desired, speed_desired, 0);
	}

	// 5Hz - 200ms print gokart info
	if (htim == &htim11){
		 print_info();
	}
}

/* USER CODE END 0 */

/**
  * @brief  The application entry point.
  * @retval int
  */
int main(void)
{
  /* MCU Configuration--------------------------------------------------------*/

  /* Reset of all peripherals, Initializes the Flash interface and the Systick. */
  HAL_Init();

  /* Configure the system clock */
  SystemClock_Config();

  /* Initialize all configured peripherals */
  MX_GPIO_Init();
  MX_USART3_UART_Init();
  MX_USART2_UART_Init();
  MX_TIM1_Init();
  MX_CAN1_Init();
  MX_ADC1_Init();
  MX_USART6_UART_Init();
  MX_TIM6_Init();
  MX_I2C1_Init();
  MX_TIM7_Init();
  MX_TIM10_Init();
  MX_TIM11_Init();
  /* USER CODE BEGIN 2 */

  main_app = &app;
  app_run(&app);

  /* USER CODE END 2 */

  /* Infinite loop */
  /* USER CODE BEGIN WHILE */
  while (1)
  {

  }
    /* USER CODE END WHILE */

}

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
