mlab-upenn/gokart-mechatronics/STM32 Control/Nucleo-L432KC-IMU/Core/Inc/dma.h

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
/* Define to prevent recursive inclusion -------------------------------------*/
#ifndef __DMA_H__
#define __DMA_H__

#ifdef __cplusplus
extern "C" {
#endif

/* Includes ------------------------------------------------------------------*/
#include "main.h"

/* DMA memory to memory transfer handles -------------------------------------*/

/* USER CODE BEGIN Private defines */
static const uint8_t CHANNEL_OFFSET_TAB[] =
{
  (uint8_t)(DMA1_Channel1_BASE - DMA1_BASE),
  (uint8_t)(DMA1_Channel2_BASE - DMA1_BASE),
  (uint8_t)(DMA1_Channel3_BASE - DMA1_BASE),
  (uint8_t)(DMA1_Channel4_BASE - DMA1_BASE),
  (uint8_t)(DMA1_Channel5_BASE - DMA1_BASE),
  (uint8_t)(DMA1_Channel6_BASE - DMA1_BASE),
  (uint8_t)(DMA1_Channel7_BASE - DMA1_BASE)
};
/* USER CODE END Private defines */

void MX_DMA_Init(void);

/* USER CODE BEGIN Prototypes */
__STATIC_INLINE uint32_t APP_DMA_GetDataLength(DMA_TypeDef *DMAx, uint32_t Channel)
{
  uint32_t dma_base_addr = (uint32_t)DMAx;
  return (READ_BIT(((DMA_Channel_TypeDef *)(dma_base_addr + CHANNEL_OFFSET_TAB[Channel]))->CNDTR,
                   DMA_CNDTR_NDT));
}
/* USER CODE END Prototypes */

#ifdef __cplusplus
}
#endif

#endif /* __DMA_H__ */
