mlab-upenn/gokart-mechatronics/STM32 Control/Nucleo-F439ZI-Main/Inc/endianness.h

#ifndef _ENDIANNESS_H
#define _ENDIANNESS_H

#include <stdint.h>

#define ntohs(x)        __builtin_bswap16(x)
#define htons(x)        __builtin_bswap16(x)

#define ntohl(x)        __builtin_bswap32(x)
#define htonl(x)        __builtin_bswap32(x)

#endif // _ENDIANNESS_H
