mlab-upenn/gokart-mechatronics/STM32 Control/Nucleo-L432KC-LSBW/Core/Inc/vesc_crc.h

// ORIGINAL SOURCE: (VESC firmware v2.18) https://github.com/vedderb/bldc/blob/ed61c4d332009aa2f284321380a49d6b170548d9/crc.h
#ifndef CRC_H_
#define CRC_H_

unsigned short crc16(unsigned char *buf, unsigned int len);

#endif /* CRC_H_ */
