mlab-upenn/gokart-mechatronics/(commit log)

2022-12-17 main branch update
    [3043T629_U-Bolt.SLDPRT, 8875T914_Mount Plate for 3 8 -16 Thread Size.SLDPRT, ABS offset.SLDPRT, ABS washer.SLDPRT, AS5047P magnet.SLDPRT, AS5047P mount.SLDPRT, AS5047P mount.STL, AS5047P.SLDPRT]
2022-12-22 LSBW Spreadsheet
    [3043T629_U-Bolt.SLDPRT, 8875T914_Mount Plate for 3 8 -16 Thread Size.SLDPRT, AS5047P magnet.SLDPRT, AS5047P mount.SLDPRT, AS5047P.SLDPRT, BBW V4 ASM.SLDASM, BLDC mount.SLDPRT, LSBW PCB.SLDPRT]
2022-12-24 USBW spreadsheet
    [3043T629_U-Bolt.SLDPRT, ABS offset.SLDPRT, ABS washer.SLDPRT, BBW V4 ASM.SLDASM, D-shaft hub.SLDPRT, DC mount.SLDPRT, LSBW V7 ASM.SLDASM, USBW PCB.SLDPRT]
2023-02-09 Added control and eletrical
    [12V DCDC.SchDoc, 3043T629_U-Bolt.SLDPRT, 8875T914_Mount Plate for 3 8 -16 Thread Size.SLDPRT, ABS offset.SLDPRT, ABS washer.SLDPRT, AS5047P magnet.SLDPRT, AS5047P mount.SLDPRT, AS5047P mount.STL]
2023-02-09 Added Jason's IMU Project
2023-03-30 updated PCB and control
    [12V DCDC.SchDoc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]
2023-04-07 Updated drive-by-wire system control
2023-04-07 BBW V5
    [BBW V4 ASM.SLDASM, BBW V5 ASM.SLDASM, LA mount.SLDPRT, LA side mount - plastic.SLDPRT, LA side mount - plasticx2.STL, LA side mount -right.SLDPRT, LSBW V7 ASM.SLDASM, PA-14P.SLDPRT]
2023-04-08 implemented speed controller and removed redundancies in the lower steer by wire control
2023-04-09 Updated UART Serial Communication
2023-04-10 added canbus support to exchange data both ways
2023-04-13 updated lower steering control
2023-04-13 increased max steering shaft angle to 50 degrees
2023-04-13 implmemted gokart speed controller and adjusted steering gain
2023-04-15 LSBW BLDC mount V9
    [BLDC mount_4steers.SLDPRT, BLDC mount_4steers.STL, LSBW BLDC mount - V9.SLDPRT, bearing mount.SLDPRT]
2023-04-15 added mode switch and deadman switch
2023-04-22 updated brake system control code
2023-04-22 improved brake control and added comment
2023-04-24 updated uart to allow info and command recording
2023-04-24 fixed gokart steering asymmetric issue
    [main.c]
2023-04-25 Jason Ouster Mount CAD
    [1010C.STEP, A2_bolt.step, Alum_prof_resized.SLDPRT, Alum_prof_resized_short.SLDPRT, Alum_prof_resized_shorter.SLDPRT, Assem1.SLDASM, Corner.SLDPRT, M5_Hex_Screw_Resized.SLDPRT]
2023-04-27 update metal version of the LA controller mount
    [LA controller mount asm.SLDASM, M5x45mm standoff.SLDPRT, acrylic layer.DWG, acrylic layer.SLDPRT, chassis frame.SLDPRT, converter.SLDPRT, lower clutch.SLDPRT, lower clutch.STL]
2023-04-27 recalibrated LSBW after metal mount
2023-04-27 fixed a wiring error in power distribution
    [Brake By Wire.PcbDoc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]
2023-04-27 new design: power over canbus
    [Brake By Wire.PcbDoc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]
2023-05-05 increased throttle and steering limit
2023-05-11 antenna mount
    [antenna mount.SLDPRT, antenna mount.STL]
2023-05-11 rear shelf board update
    [Left Board.SLDDRW, Plate left side V3.dwg, Plate left side V4.dwg, Plate right side V2.dwg, Plate right side V4.dwg, Right Board.SLDDRW, Top Plate left side V2.dwg]
2023-05-12 throttle and steering recalibration
2023-05-29 Added Makefile for all projects but deprecated IMU
    resolves gh-#3
    The Makefiles were generated by CubeMX via each project's respective
    .ioc files, then modified per each Project's source files. Naming
    conventions were modified to accomodate extant project code.
2023-06-01 change throttle control setting as used at Purdue
2023-06-01 steering offset recalibrate as used at Purdue
2023-06-01 remove two 5v connector in the PDU
    [GoKart PDU_V3.PrjPcb, PDU_Schematic.SchDoc]
2023-06-22 jason antenna mount uploaded, with derek's
    [1010C.STEP, Alum_prof_resized.SLDPRT, Antena_Mount_Assy.SLDASM, Antenna.SLDPRT, Antenna_failed_first_attempt.SLDPRT, Bullet 2hp Ubiquiti.STEP, Corner.SLDPRT, Mount_Center_Pocket.DXF]
2023-06-22 battery box uploaded to main branch
    [Back_revised.SLDPRT, side_revised.SLDPRT, vertical sheet front and back.SLDDRW, vertical sheet sides.SLDDRW]
2023-06-29 renamed LA controller mount to BBW controller mount
    [BBW controller mount asm.SLDASM]
2023-06-29 renamed LA controller mount to BBW controller mount, folders now
    [BBW controller mount asm.SLDASM, L-Link.SLDPRT, Left Board.SLDDRW, M5x45mm standoff.SLDPRT, PCB Mount.SLDPRT, Rear Metal Frame.SLDASM, Right Board.SLDDRW, T-slot frame 110mm.SLDPRT]
2023-06-29 SBW BLDC Mount folder renamed more clearly
    [LSBW BLDC mount - V9.SLDPRT]
2023-07-13 add throttle by wire subsystem and update control code
    [Sheet1.SchDoc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]
2023-07-20 jason rear shelf redesign
    [700-105333-OS1ExteriorSpec_FOV.STEP.SLDPRT, Alum_prof_resized_short.SLDPRT, Alum_prof_resized_shorter.SLDPRT, Bottom Plate Left Side V5.DWG, Bottom Plate Left Side V5.SLDPRT, Bottom Plate Right Side V5.DWG, Bottom Plate Right Side V5.SLDPRT, Bottom Plate left side V3.dwg]
2023-07-21 jason sensor CAD updates
    [1010C.STEP, 700-105333-OS1ExteriorSpec_FOV.STEP.SLDPRT, A2_bolt.step, Alum_prof_resized.SLDPRT, Alum_prof_resized_short.SLDPRT, Alum_prof_resized_shorter.SLDPRT, Antena_Mount_Assy.SLDASM, Antenna.SLDPRT]
2023-07-21 jason sensor CAD updates 2
    [RC Receiver Assy.SLDASM]
2023-07-21 jason rear shelf sensors integrated into CAD
    [700-105333-OS1ExteriorSpec_FOV.STEP.SLDPRT, Alum_prof_resized_short.SLDPRT, Alum_prof_resized_shorter.SLDPRT, Assem1.SLDASM, Corner.SLDPRT, GNSS_Assy.SLDASM, L-Link.SLDPRT, Old_Mount.SLDPRT]
2023-07-25 RealSense CAD from Felix
    [1010C.STEP, Alum_prof_resized.SLDPRT, Antena_Mount_Assy.SLDASM, Antenna.SLDPRT, Antenna_failed_first_attempt.SLDPRT, Bullet 2hp Ubiquiti.STEP, Corner.SLDPRT, Mount TierIV.SLDPRT]
2023-07-25 RealSense CAD in STL format
    [Mount TierIV.stp, Mount TierIV_from_STL.SLDPRT, Mount TierIV_from_STP.SLDPRT]
2023-07-25 RealSense mount unfinished
    [RealSense_Mount.SLDPRT]
2023-08-09 BBW remove broken mounted 3d printed part
    [BBW V5 ASM.SLDASM, BBW V6 ASM.SLDASM, LA mount.SLDPRT, LA side mount -right.SLDPRT, PA-14P.SLDPRT, back link.SLDPRT, black box frame.SLDPRT, chassis mount.SLDPRT]
2023-08-09 various small CAD changes
    [3043T629_U-Bolt.SLDPRT, 8875T914_Mount Plate for 3 8 -16 Thread Size.SLDPRT, ABS offset.SLDPRT, ABS washer.SLDPRT, AS5047P magnet.SLDPRT, AS5047P mount.SLDPRT, AS5047P.SLDPRT, BBW controller mount asm.SLDASM]
2023-08-09 jason small CAD changes convo w George
    [BBW V6 ASM.SLDASM, LSBW V7 ASM.SLDASM, USBW V7 ASM.SLDASM]
2023-08-09 jason fixed LSBW BLDC mount
    [BLDC mount - V8.SLDPRT, BLDC mount - V9.SLDPRT, LSBW BLDC mount - V9.SLDPRT, LSBW V7 ASM.SLDASM, MAXPlanetary 3-Stage.SLDPRT, side_revised.SLDPRT]
2023-08-10 changed names of battery box files
    [vertical sheet front and back.SLDPRT, vertical sheet sides.SLDPRT]
2023-08-10 rear shelf legs CAD included
    [BBW V5 ASM.SLDASM, BBW V6 ASM.SLDASM, LA mount.SLDPRT, LA side mount -right.SLDPRT, LA side mount.SLDPRT, LA steel frame.SLDPRT, LA top mount.SLDPRT, T-slot frame 146mm.SLDPRT]
2023-08-15 USBW small changes
    [DC mount.SLDPRT, Pololu mount.SLDPRT, USBW V7 ASM.SLDASM, coupler.SLDPRT, new coupler.SLDPRT, sw frame.SLDPRT]
2023-08-17 rear sensor mount CAD from Archit
    [Rear_Sensor_Assy.SLDASM, rear_sensor_holder.SLDPRT, rear_sensor_mount.SLDPRT]
2023-08-18 jason edited some BBW engineering drawings
    [LA steel frame.SLDDRW, end link new metal.SLDDRW, lever arm.SLDDRW, metal frame.SLDDRW]
2023-08-19 jason small CAD changes
    [ABS offset.SLDPRT, BBW V6 ASM.SLDASM, LSBW V7 ASM.SLDASM, USBW V7 ASM.SLDASM, rounded spacer.SLDPRT, shaft mount.SLDPRT, steering wheel housing.SLDPRT, steering wheel shaft.SLDPRT]
2023-08-21 Jason mech documentation updated some drawings
    [LA side mount Drawing.SLDDRW, LA side mount V2.SLDPRT, LA side mount.SLDDRW, LA side mount.STL, LA steel frame.SLDDRW, lever arm.SLDDRW]
2023-08-22 jason small changes
    [BBW V6 ASM.SLDASM]
2023-08-22 jason restructured CAD within Git for rubustness to future changes
    [1010C.STEP, 3043T629_U-Bolt.SLDPRT, 8875T914_Mount Plate for 3 8 -16 Thread Size.SLDPRT, A2_bolt.step, ABS washer.SLDPRT, AS5047P magnet.SLDPRT, AS5047P mount.SLDPRT, AS5047P mount.STL]
2023-08-24 jason pushed zip files for 3 major subsystem assemblies
2023-08-24 bbw mid link stl size fixed
    [BBW V6 ASM.SLDASM, mid link V2.SLDPRT, mid link old.SLDPRT, mid link.SLDPRT, mid link.STL]
2023-08-28 jason pushed BBW brake rod assy
    [Brake_rod_assy.SLDASM, Brake_rod_extender.SLDPRT, Brake_rod_locator.SLDPRT]
2023-08-28 brake rod extender engineering drawing
    [Brake_rod_assy.SLDASM, Brake_rod_extender.SLDDRW]
2023-08-28 jason BBW lever arm pin CAD and drawing
    [Lever_arm_pin.SLDPRT, Lever_arm_pin_drawing.SLDDRW]
2023-08-29 jason USBW STL files pushed
    [ABS washer.STL, Pololu mount.STL, USBW PCB mount.SLDPRT, USBW PCB mount.STL, USBW V7 ASM.SLDASM, USBW controller mount.SLDPRT, beam link.STL, beam.STL]
2023-08-29 LSBW mounting t-slots added
    [LSBW V7 ASM.SLDASM, L_pair.SLDASM, T-slot frame 60mm.SLDPRT]
2023-08-30 LSBW L-pair mounts added from Tomas
    [LSBW V7 ASM.SLDASM, L_Pair_Bottom_Mount.SLDPRT, L_Pair_Top_Mount.SLDPRT]
2023-08-30 LSBW l-pair mount drawings inserted
    [LSBW V7 ASM.SLDASM, L_Pair_Bottom_Mount.SLDDRW, L_Pair_Bottom_Mount.SLDPRT, L_Pair_Top_Mount.SLDDRW]
2023-08-30 magnet_holder_collar pushed to Git
    [magnet_holder_collar.SLDPRT]
2023-08-30 LSBW motor front support CAD pushed
    [LSBW V7 ASM.SLDASM, LSBW_Motor_Front_Support.SLDDRW, LSBW_Motor_Front_Support.SLDPRT]
2023-08-30 LSBW welded part CAD updated
    [BLDC mount - V9.SLDPRT, Hexagonal_shaft_pin.SLDPRT, LSBW V7 ASM.SLDASM, LSBW motor mount.SLDPRT, Rotating_Body.SLDASM, TopKart_Shaft.SLDASM, TopKart_Shaft.SLDDRW, Welded_Shaft.SLDASM]
2023-08-31 LSBW CAD fixed, esp rotating body
    [LSBW V7 ASM.SLDASM, Pinned_Shaft.SLDASM, Rotating_Body - Copy.SLDASM, Rotating_Body.SLDASM, TopKart_Shaft.SLDASM, Welded_Shaft.SLDASM]
2023-08-31 LSBW organized
    [Rotating_Body - Copy.SLDASM]
2023-08-31 hexagonal shaft drawings posted
    [Hexagonal_shaft_pin.SLDDRW, hexagonal shaft.SLDDRW]
2023-09-01 LSBW sleeves CAD
    [sleeve back.SLDDRW, sleeve back.SLDPRT, sleeve front.SLDDRW, sleeve front.SLDPRT]
2023-09-01 bearing mount drawing pushed
    [LSBW V7 ASM.SLDASM, bearing mount.SLDDRW]
2023-09-01 magnet mount STL pushed
    [magnet mount.STL]
2023-09-11 BBW LA side mount revised
    [BBW V6 ASM.SLDASM, LA side mount - old.SLDPRT, LA side mount V2.SLDPRT, LA side mount.SLDPRT, LSBW V7 ASM.SLDASM, Rotating_Body.SLDASM]
2023-09-13 LSBW BLDC 4th gear added in CAD
    [BLDC_Assy_LSBW.SLDASM, BLDC_Back_Half.SLDPRT, BLDC_Front_Half.SLDPRT, LSBW V7 ASM.SLDASM, Pinned_Shaft.SLDASM]
2023-09-13 LSBW BLDC Mount engineering drawing
    [BLDC_Assy_LSBW.SLDASM, BLDC_Back_Half.SLDPRT, LSBW V7 ASM.SLDASM, LSBW motor mount.SLDDRW, bearing mount.SLDPRT]
2023-09-29 BBW CAD assembly extracted
    [BBW V6 ASM.SLDASM, LA side mount.SLDPRT, LA steel frame.SLDPRT, LA top mount.SLDPRT, PA-14P.SLDPRT, TopKart reservoir frame.SLDPRT, back link.SLDPRT, front link.SLDPRT]
2023-10-09 jason new MDF sheets to lasercut
    [Bottom Plate Left Side V6.DWG, Bottom Plate Left Side V6.SLDPRT, Top Plate Left Side V5.SLDPRT, Top Plate Left Side V6.DWG, Top Plate Left Side V6.SLDPRT, Top Plate Left Side V7.DWG, Top Plate Left Side V7.SLDPRT, Top Plate Right Side V6.SLDPRT]
2023-10-17 jason AutoKit MDF shelves
    [AutoKit_Blocker.DWG, AutoKit_Blocker.SLDPRT, Bottom Plate Left Side V6.DWG, Bottom Plate Left Side V6.SLDPRT, Bottom Plate Left Side V7.DWG, Bottom Plate Left Side V7.SLDPRT, Top Plate AutoKit V6.DWG, Top Plate AutoKit V6.SLDPRT]
2023-10-17 Generated link for USBW and LSBW assemblies
    [3043T629_U-Bolt.SLDPRT, 8875T914_Mount Plate for 3 8 -16 Thread Size.SLDPRT, ABS washer.SLDPRT, AS5047P magnet.SLDPRT, AS5047P mount.SLDPRT, AS5047P.SLDPRT, BLDC mount - V9.SLDPRT, D-shaft hub.SLDPRT]
2024-01-08 GNSS antenna mount STEP
    [GNSS_mount_V2.STEP]
2024-02-08 Eve autonomy Lidar fixing
    [Lidar_Plastic_Triangle.SLDPRT, Lidar_Plastic_v1.SLDPRT]
2024-02-13 ByWire assemblies pushed as STEP files
    [BBW V6 ASM.SLDASM, BBW V6 ASM.STEP]
2024-02-15 eve autonomy Rect Base Top CAD
    [Rect_Base_Top.SLDPRT]
2024-02-15 added CAD for previous broken mount
    [Lidar_Mounting_Assy_V1.SLDASM, Rect_Base_Top.SLDPRT, T-slot frame 1220mm.SLDPRT, Tslot1.SLDPRT, Tslot2.SLDPRT, Tslot3.SLDPRT, Tslot4.SLDPRT, Tslot5.SLDPRT]
2024-02-15 Lidar mount assy V2
    [Lidar_Mounting_Assy_V1.SLDASM, Rect_Base_Top.SLDPRT, Tslot1.SLDPRT, Tslot2.SLDPRT, Tslot3.SLDPRT, Tslot4.SLDPRT]
2024-02-15 Eve autonomy lidar mount assy changes
    [Lidar_Mount.SLDPRT, Lidar_Mounting_Assy_V1.SLDASM]
2024-02-22 Battery Box Top Assy pushed
    [Battery_Box_Top_Assy.SLDASM, Tslot1.SLDPRT, Tslot2.SLDPRT, Tslot3.SLDPRT, Tslot4.SLDPRT, Tslot5.SLDPRT, vertical sheet front and back.SLDPRT, vertical sheet sides.SLDPRT]
2024-02-22 battery box assy final pushed
    [Battery_Box_Assy.SLDASM, Battery_Box_Assy.STEP, Battery_Box_Top_Assy.SLDASM, LiPo_Simple.SLDPRT, floor sheet left.SLDPRT, floor sheet right.SLDPRT, vertical sheet front and back.SLDPRT, vertical sheet sides.SLDPRT]
2024-02-22 lidar mount holes added
    [Lidar_Mount.SLDPRT, Lidar_Mounting_Assy_V1.SLDASM]
2024-02-22 LiDar mount holes added and fixed
    [Lidar_Mount.SLDPRT, Lidar_Mounting_Assy_V1.SLDASM]
2024-02-26 lidar mount holes dimensioned for M5 20mm, exported as STL
    [Lidar_Mount.SLDPRT, Lidar_Mount.STL, Lidar_Mounting_Assy_V1.SLDASM, M5_Screw.SLDPRT]
