mlab-upenn/gokart-mechatronics/(notices)

Notices in the files:
STM32 Control/Nucleo-F439ZI-Main/Src/main.c:
Copyright (c) 2022 STMicroelectronics.
All rights reserved.
This software is licensed under terms that can be found in the LICENSE file
STM32 Control/Nucleo-L432KC-LSBW/Core/Inc/vesc_datatypes.h:
The VESC firmware is free software: you can redistribute it and/or modify
it under the terms of the GNU General Public License as published by
the Free Software Foundation, either version 3 of the License, or
(at your option) any later version.
STM32 Control/Nucleo-L432KC-IMU/Core/Src/usart.c:
Copyright (c) 2023 STMicroelectronics.
